nguyentrungthao/KicadLibrary/3D/Switch_Button/TactileSwitch_Button/SMD/YD-3414/31LzOt8mbsL._AC_SY1000_.jpg

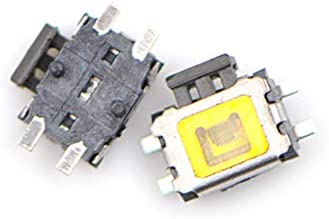
3D/Switch_Button/TactileSwitch_Button/SMD/YD-3414/31LzOt8mbsL._AC_SY1000_.jpg
