nguyentrungthao/KicadLibrary/README.md

# KicadLibrary
symbol and footprints for kicad
