nguyentrungthao/KicadLibrary/3D/Relay/PhanLoaiRelay.docx

HF32F 18.4x10.2x15.3

SRD 19.1x15.5x15.3

SRA 15.5X12.3X14.0

JQC 19.0X15.2X15.5

HK4100F 15.5X10.5X11.0 RELAY ĐÓNG CẮT NHANH

### RELAY SLA-12VDC-SL-A

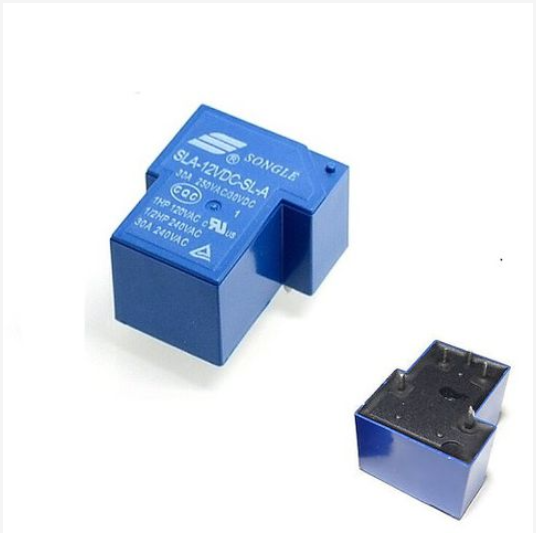
[picture p3: figure]
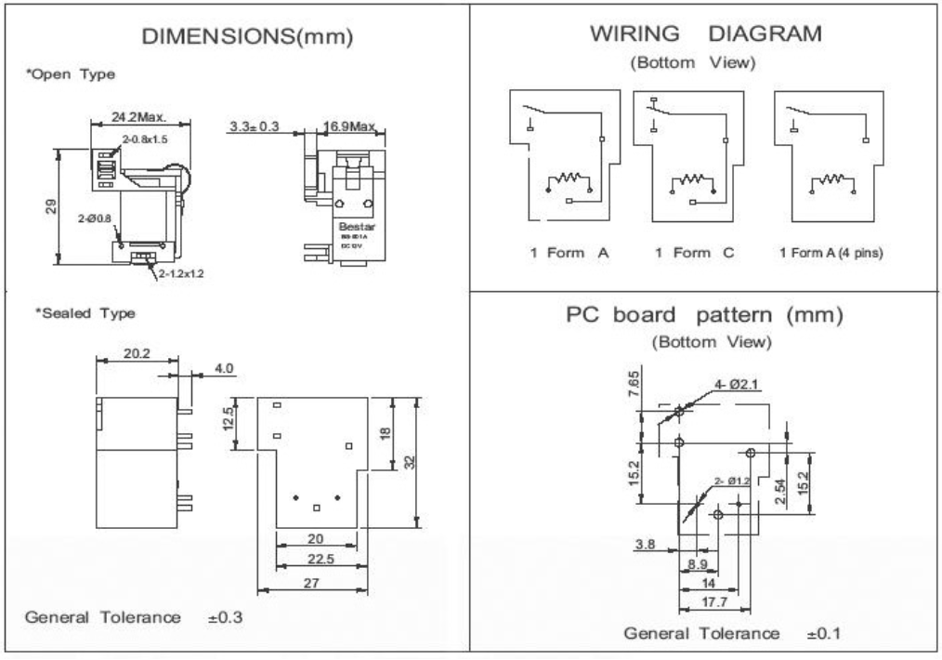
[picture p4: figure]

### Relay HK4100F-DC9V-SHG

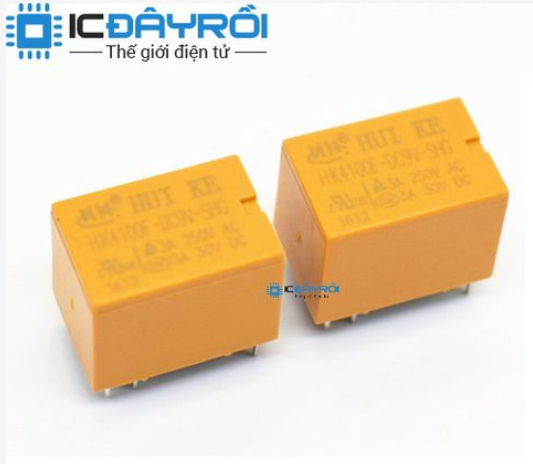
[picture p5: figure]
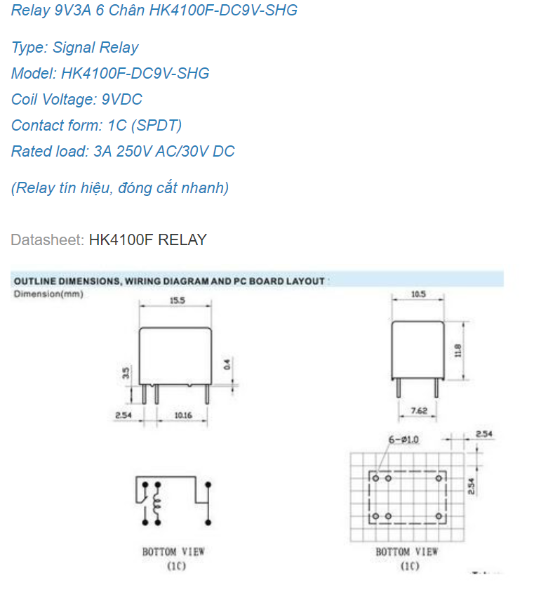
[picture p6: figure]

### Relay JQC-3FF-005-1ZS

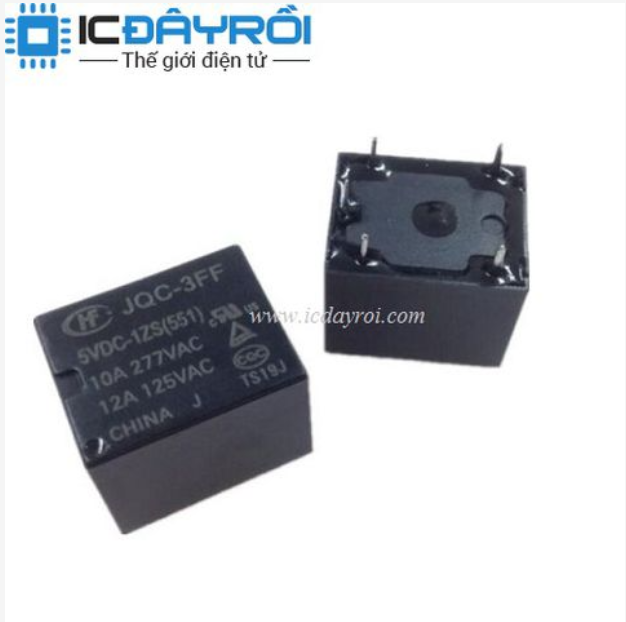
[picture p7: figure]
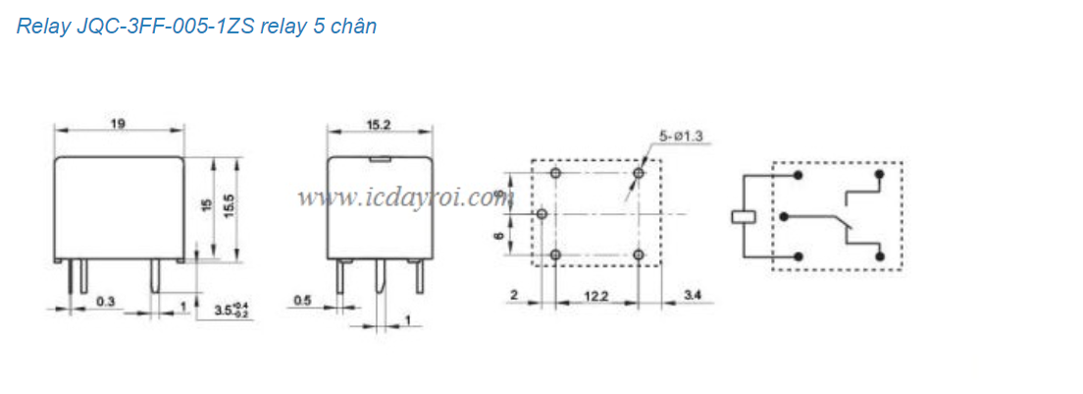
[picture p8: figure]

### Relay SRA-05VDC-CL

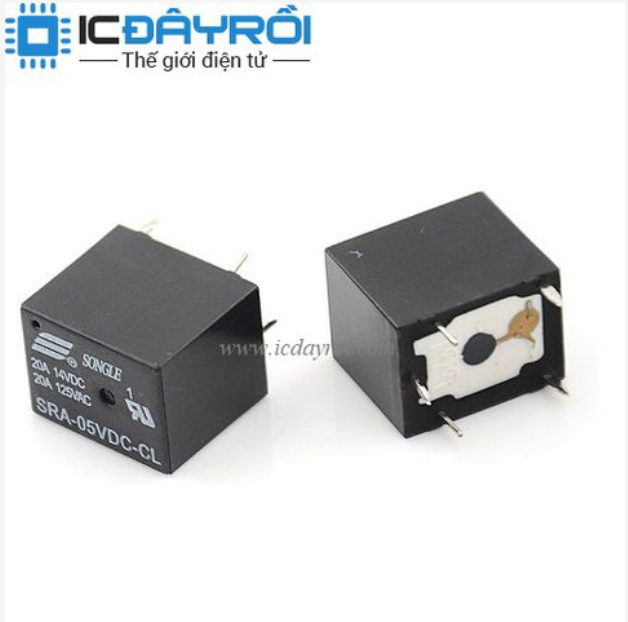
[picture p9: figure]
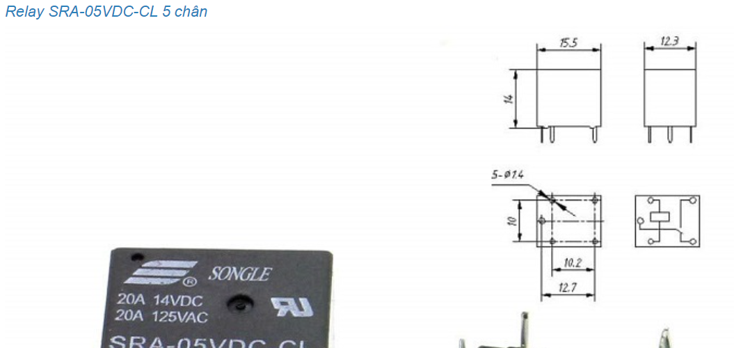
[picture p10: figure]

### Relay SRD-24VDC-SL-C

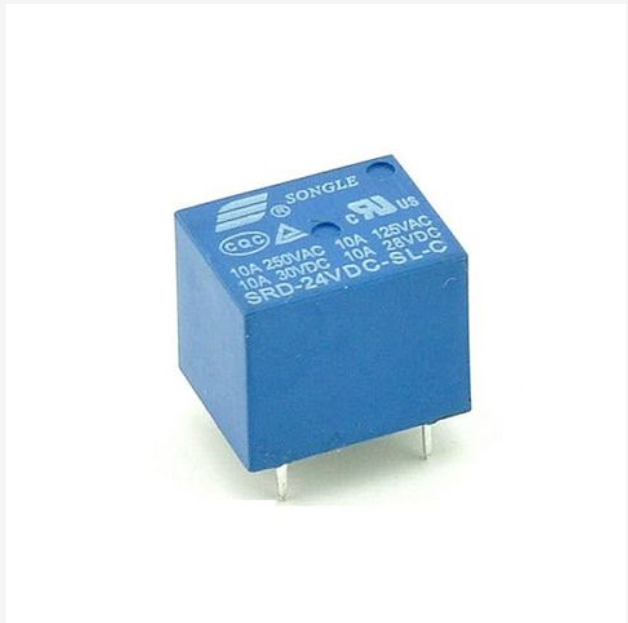
[picture p11: figure]
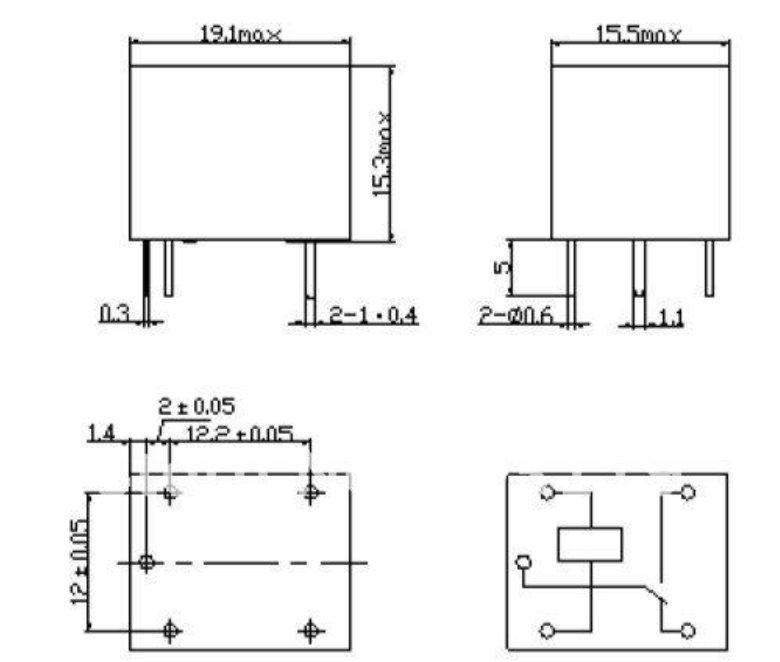
[picture p12: figure]

### Relay SLC-12VDC-SL-C

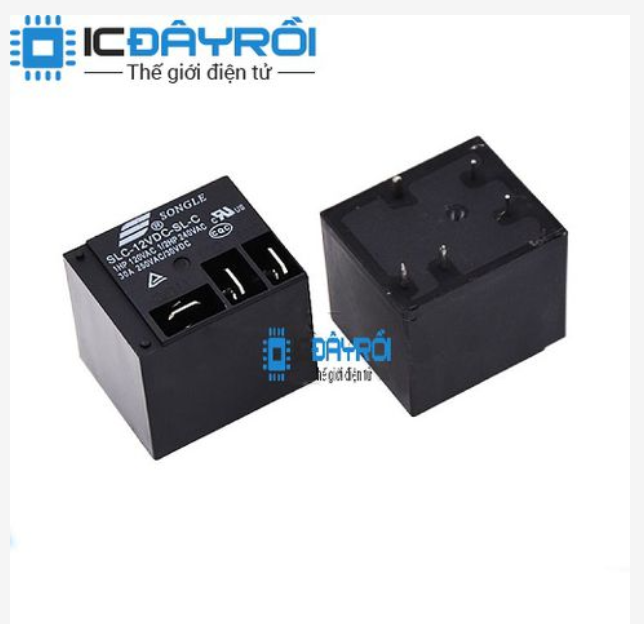
[picture p13: figure]
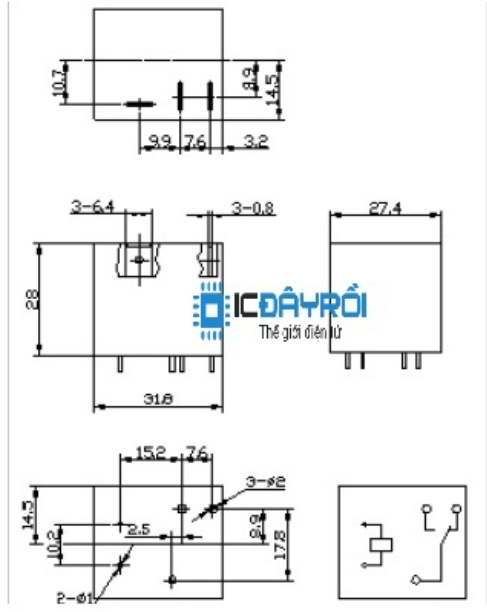
[picture p14: figure]

### Relay omron G3MB-202P-5VDC

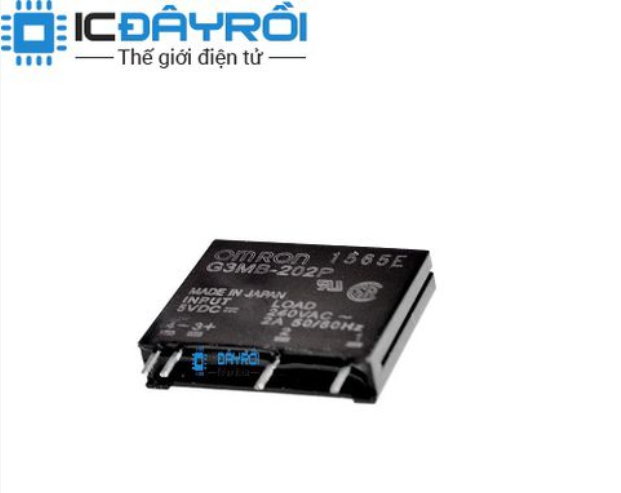
[picture p15: figure]
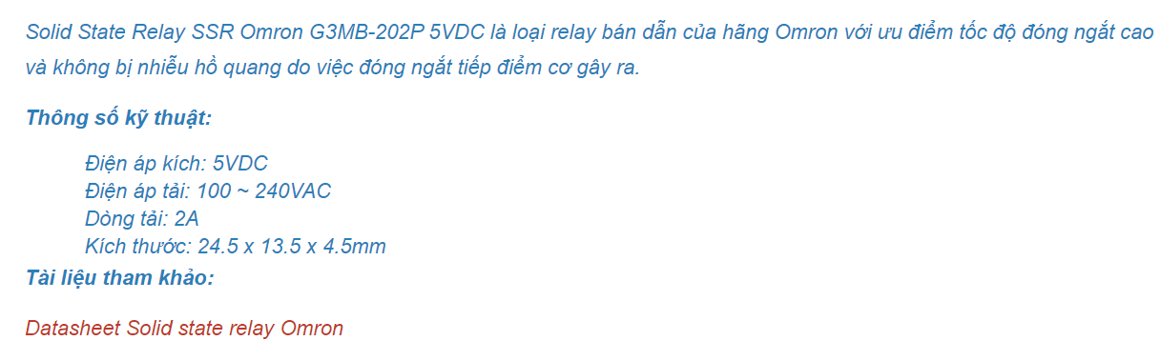
[picture p16: figure]

### Relay SMI-05VDC-SL-2C

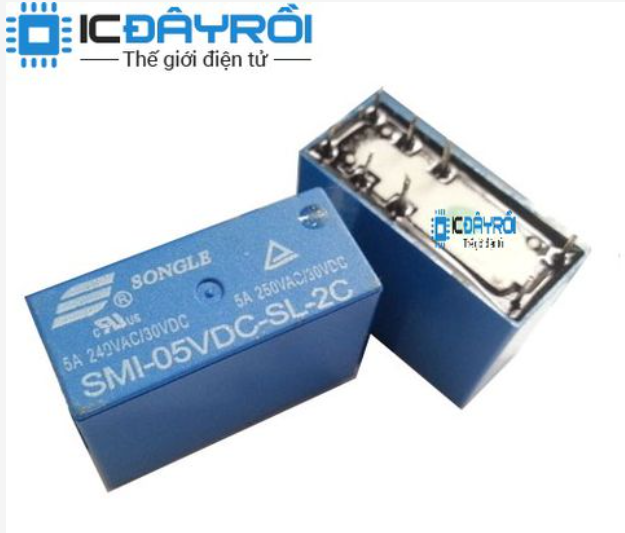
[picture p17: figure]
