nguyentrungthao/KicadLibrary/3D/Connector/RJ11/TJ6P6C/TJ6P6C (1).pdf

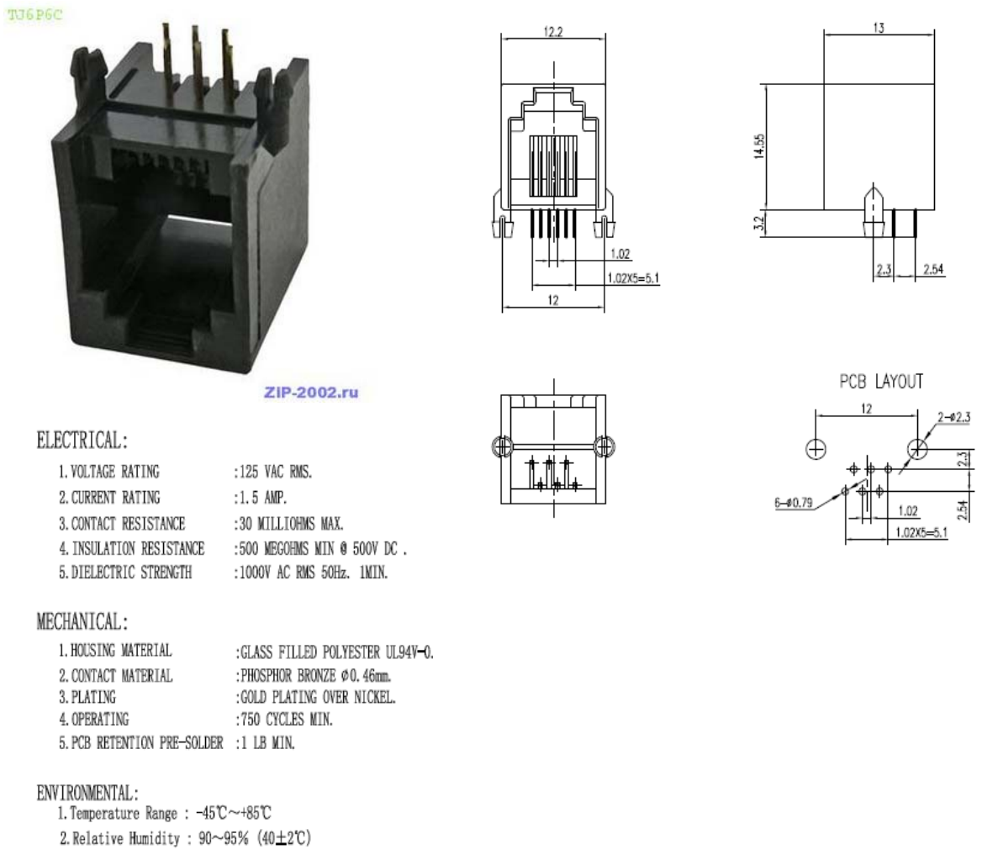
[picture p18: page 1]
