nguyentrungthao/KicadLibrary/3D/Capacitor/Cap_SMD/AluminumCap/Capacitor_SMD.jpeg

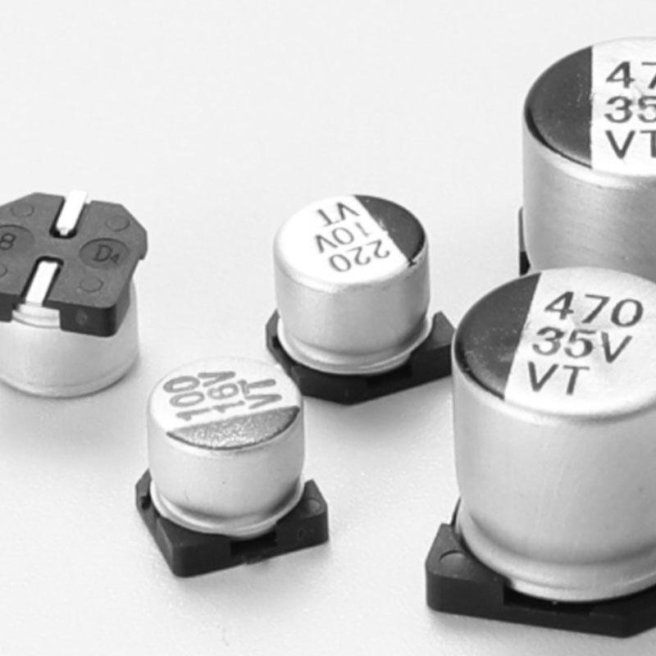
3D/Capacitor/Cap_SMD/AluminumCap/Capacitor_SMD.jpeg
