nguyentrungthao/KicadLibrary/3D/Comunication/TD301D485/TDx01D485.jpg

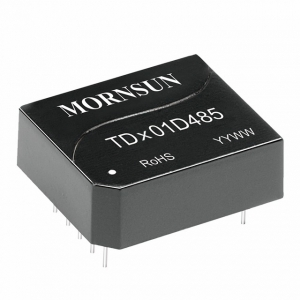
3D/Comunication/TD301D485/TDx01D485.jpg
