nguyentrungthao/KicadLibrary/3D/Connector/Banana/14116.jpg

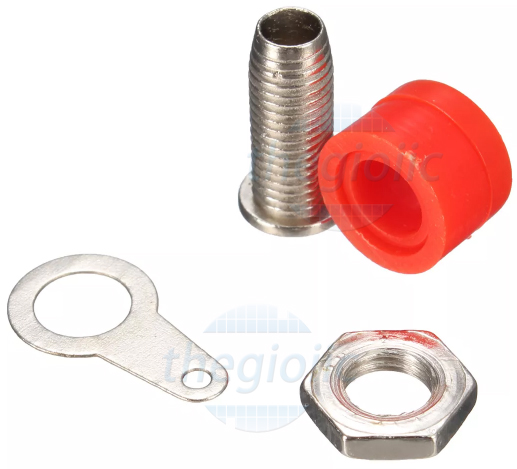
3D/Connector/Banana/14116.jpg
