nguyentrungthao/KicadLibrary/3D/Connector/DB/Db15 male PCB Connector.jpg

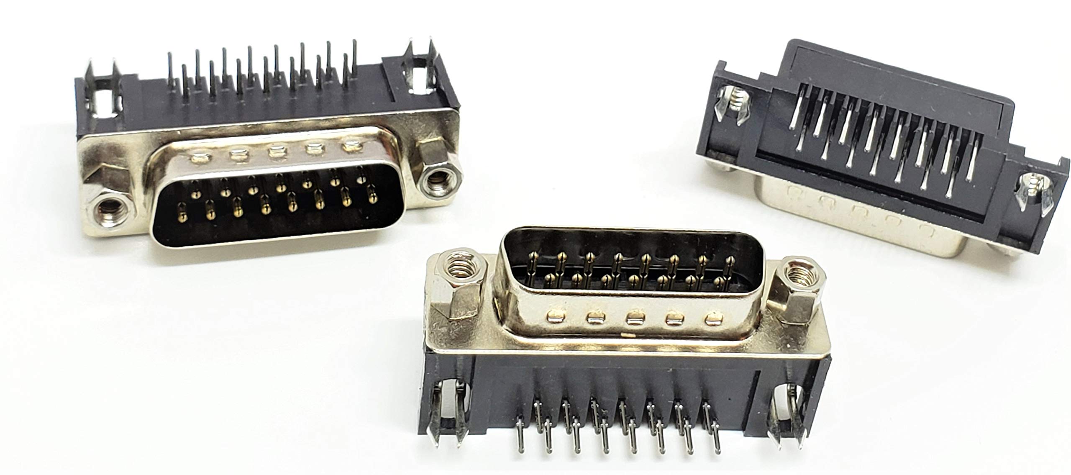
3D/Connector/DB/Db15 male PCB Connector.jpg
