nguyentrungthao/KicadLibrary/3D/Connector/IPEX_Antenna/i-pex-mhf-micro-coax-45-ghz-rf-receptacle-1.snapshot.1/I-PEX MHF_7 Recepticle iso rendering.JPG

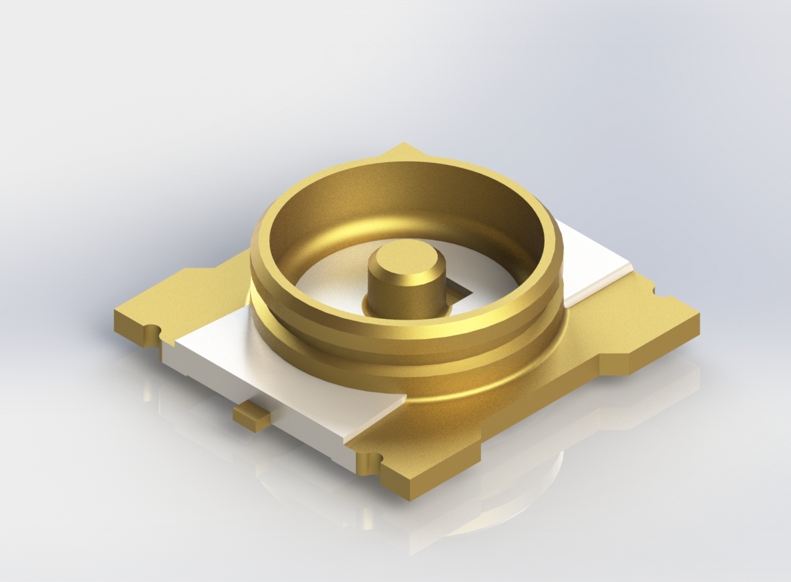
3D/Connector/IPEX_Antenna/i-pex-mhf-micro-coax-45-ghz-rf-receptacle-1.snapshot.1/I-PEX MHF_7 Recepticle iso rendering.JPG
