nguyentrungthao/KicadLibrary/3D/Connector/JST/DIP/JST-CH-Thru-Vertical-3.96mm/Capture.PNG

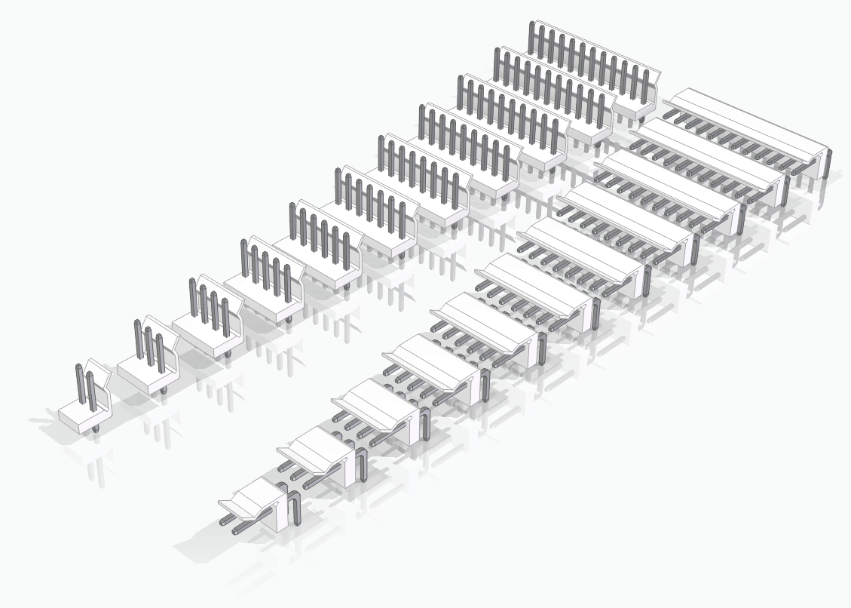
3D/Connector/JST/DIP/JST-CH-Thru-Vertical-3.96mm/Capture.PNG
