nguyentrungthao/KicadLibrary/3D/Connector/KF2510/molex3.jpg

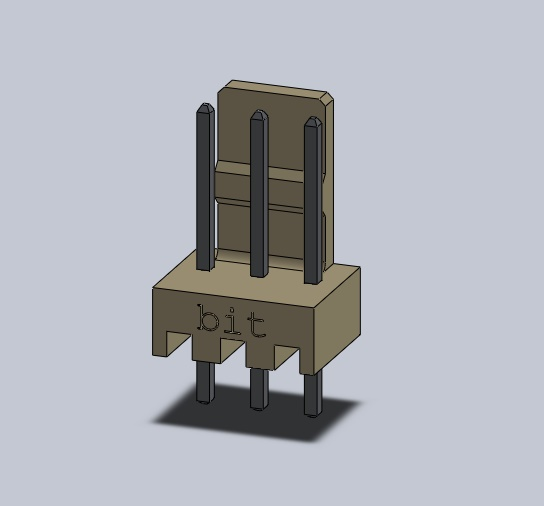
3D/Connector/KF2510/molex3.jpg
