nguyentrungthao/KicadLibrary/3D/Connector/RJ11/TJ6P4C/8fafbc54ad9b048f512ba79f.jpg

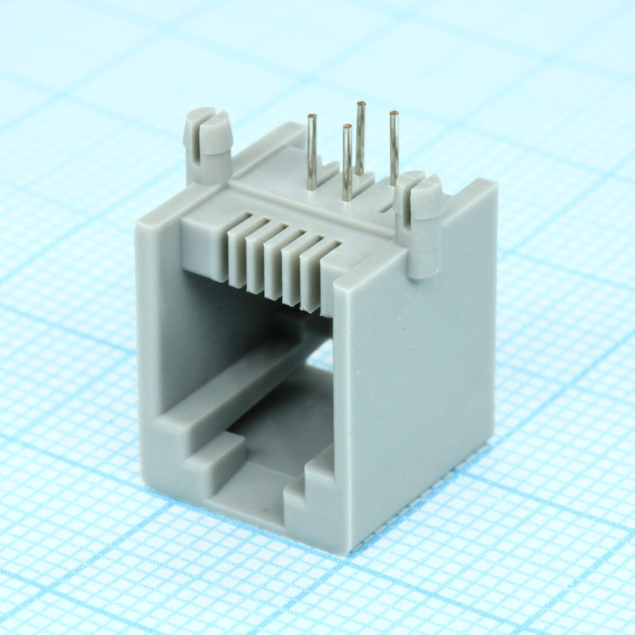
3D/Connector/RJ11/TJ6P4C/8fafbc54ad9b048f512ba79f.jpg
