nguyentrungthao/KicadLibrary/3D/Connector/RJ11/TJ6P6C/e70e3a5bf0055c61a7531b99.jpg

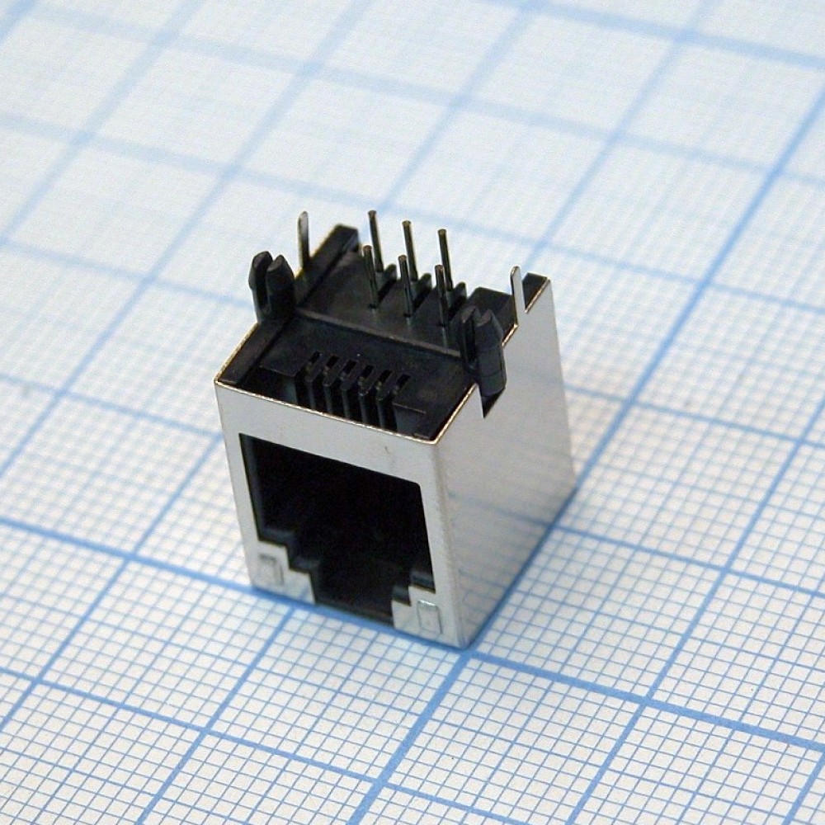
3D/Connector/RJ11/TJ6P6C/e70e3a5bf0055c61a7531b99.jpg
