nguyentrungthao/KicadLibrary/3D/Connector/SIMCardHolder/NanoSIM/Molex/78800001/1.JPG

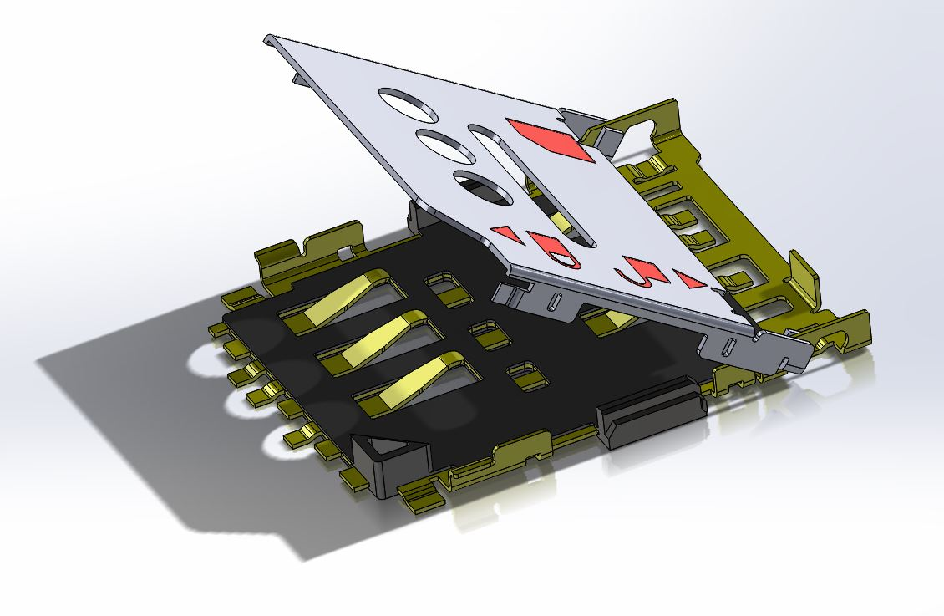
3D/Connector/SIMCardHolder/NanoSIM/Molex/78800001/1.JPG
