nguyentrungthao/KicadLibrary/3D/Connector/TerminalBlock/borne-5-08mm-duplo-nivel-1.snapshot.2/borne.png

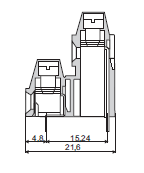
3D/Connector/TerminalBlock/borne-5-08mm-duplo-nivel-1.snapshot.2/borne.png
