nguyentrungthao/KicadLibrary/3D/Diode/Diodes-smd-packages.png

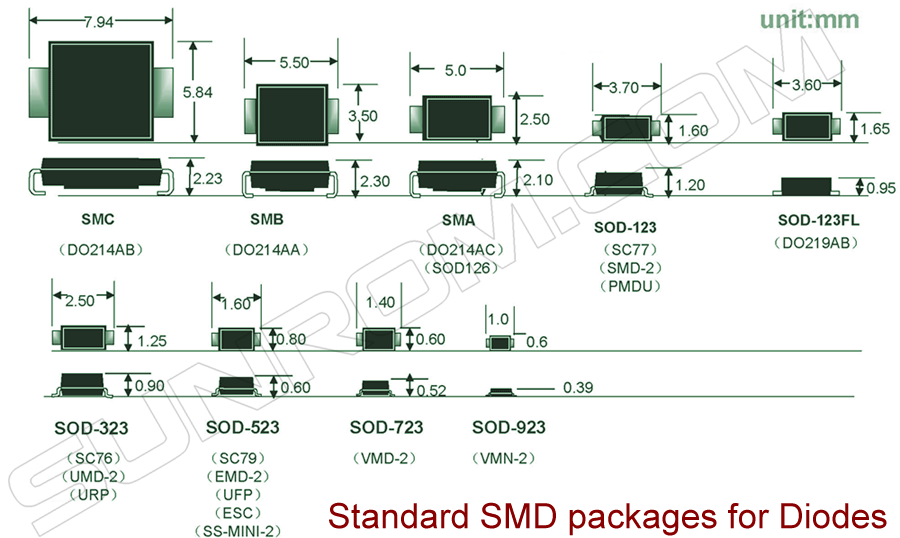
3D/Diode/Diodes-smd-packages.png
