nguyentrungthao/KicadLibrary/3D/Diode/LED/GP1UE26RK0VF.jpg

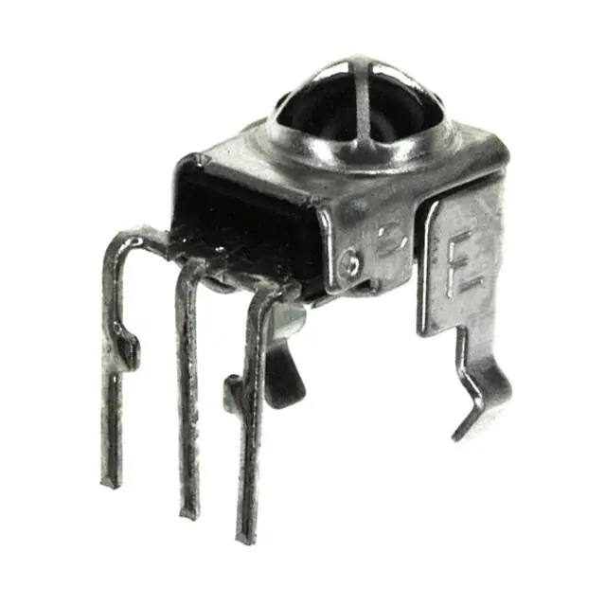
3D/Diode/LED/GP1UE26RK0VF.jpg
