nguyentrungthao/KicadLibrary/3D/Diode/LED/itr9909-ir-reflective-sensor-1.snapshot.2 (1)/ITR9909.png

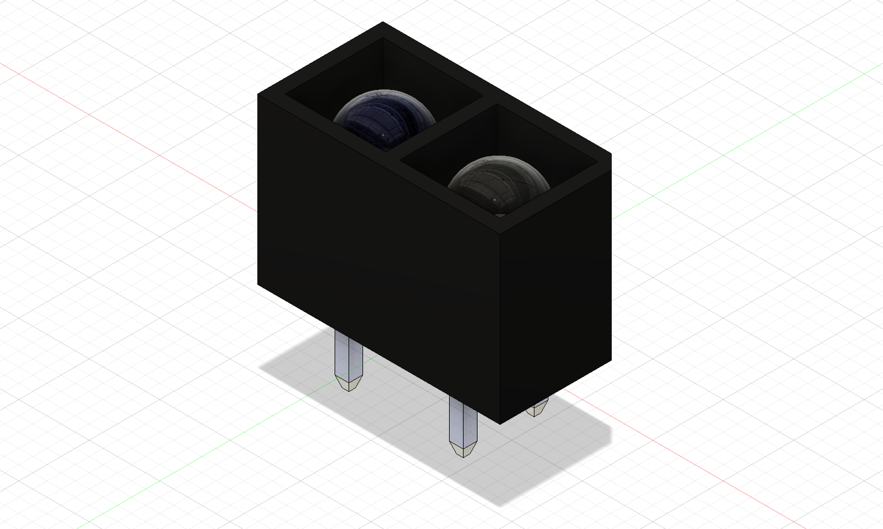
3D/Diode/LED/itr9909-ir-reflective-sensor-1.snapshot.2 (1)/ITR9909.png
