nguyentrungthao/KicadLibrary/3D/Diode/LED/ITR9909.jpg

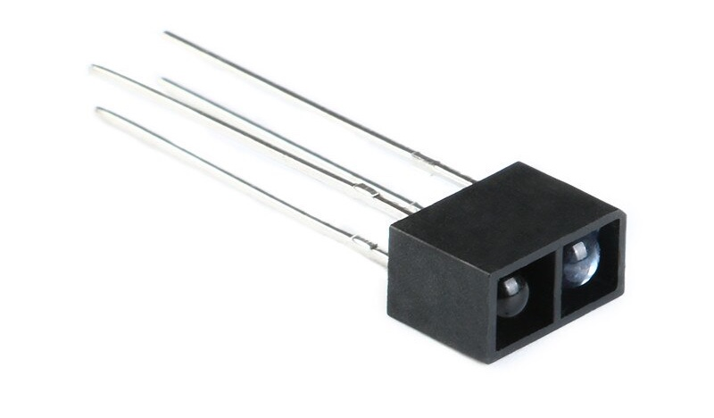
3D/Diode/LED/ITR9909.jpg
