nguyentrungthao/KicadLibrary/3D/Diode/LED/LED/Lite-On SMD LEDs.PNG

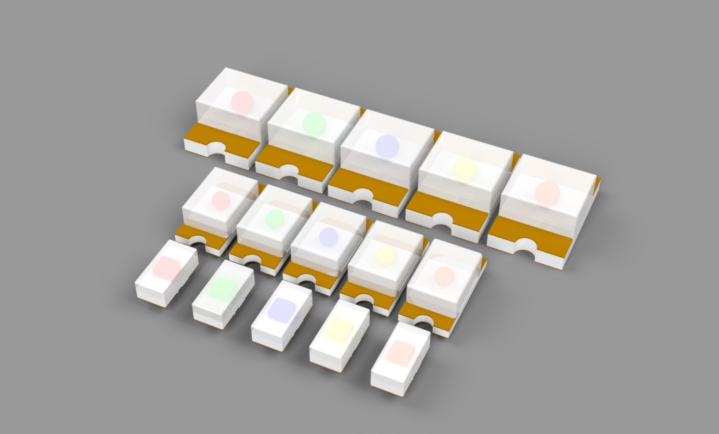
3D/Diode/LED/LED/Lite-On SMD LEDs.PNG
