nguyentrungthao/KicadLibrary/3D/Diode/LED/LED_Housing/LED 3mm red housing_3.jpg

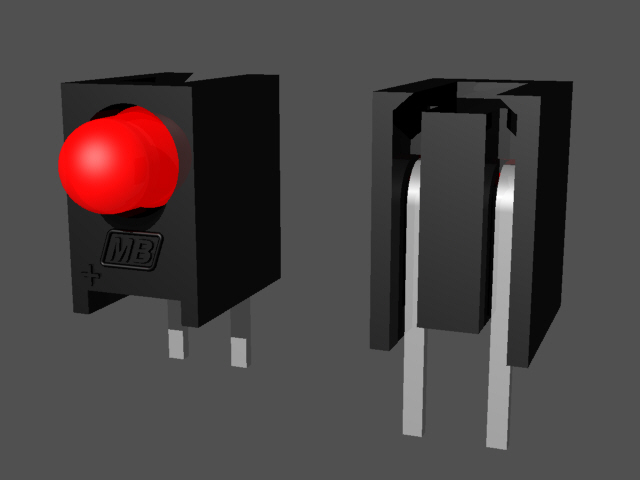
3D/Diode/LED/LED_Housing/LED 3mm red housing_3.jpg
