nguyentrungthao/KicadLibrary/3D/Diode/SMA/Package diode SMA.jpg

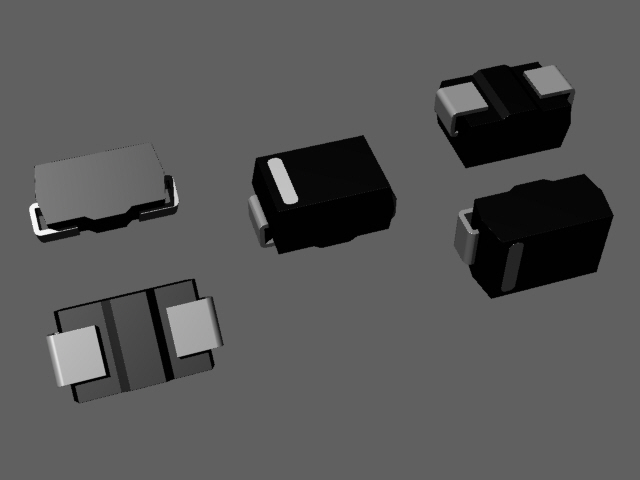
3D/Diode/SMA/Package diode SMA.jpg
