nguyentrungthao/KicadLibrary/3D/Diode/SOD323/SOD-600.jpg

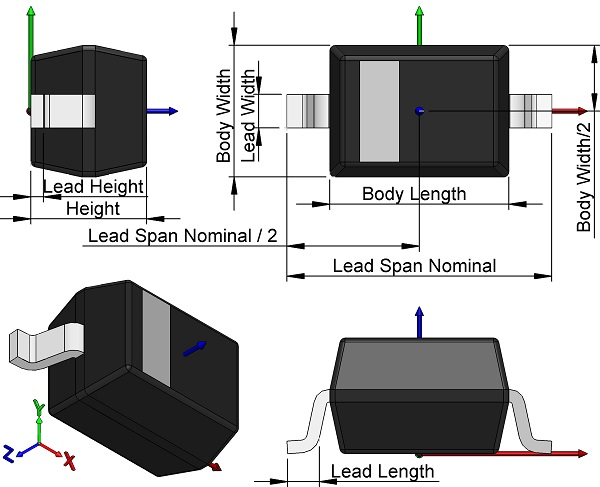
3D/Diode/SOD323/SOD-600.jpg
