nguyentrungthao/KicadLibrary/3D/Encoder/SMD/11mm-metal-shaft-rotary-encoders-smd-vertical-w-push-on-switch-1.snapshot.1/EC11-SMD-15F-green.png

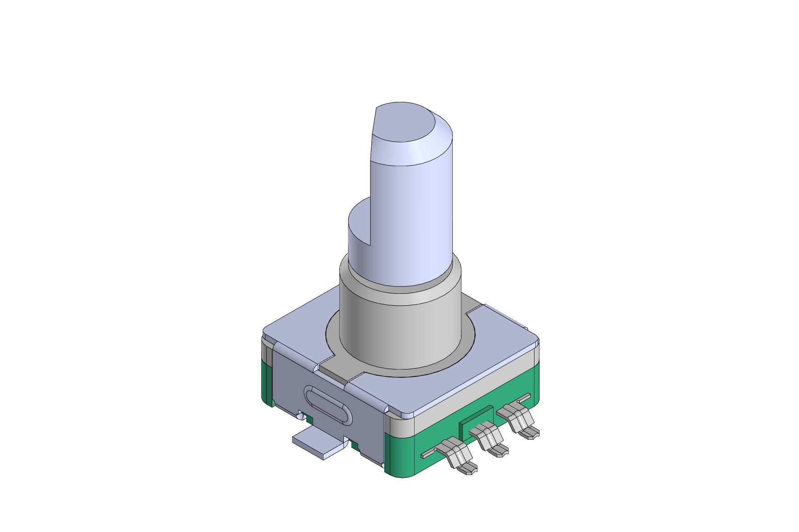
3D/Encoder/SMD/11mm-metal-shaft-rotary-encoders-smd-vertical-w-push-on-switch-1.snapshot.1/EC11-SMD-15F-green.png
