nguyentrungthao/KicadLibrary/3D/Filter/AC Filter Choke/filtr-ac-pins7x8.jpg

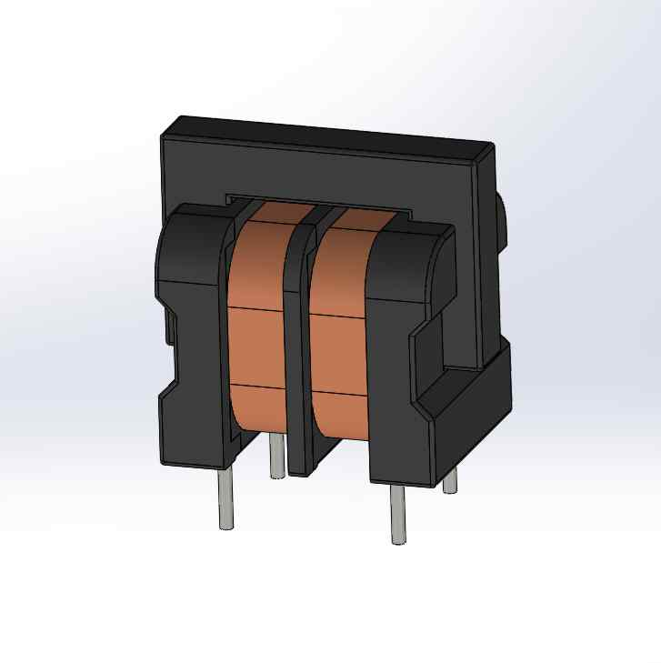
3D/Filter/AC Filter Choke/filtr-ac-pins7x8.jpg
