nguyentrungthao/KicadLibrary/3D/Fuses/FuseSMD/litteFuse/Littelfuse_0154.500DRT_2020-Jun-25_04-00-22AM-000_CustomizedView8331790309.png

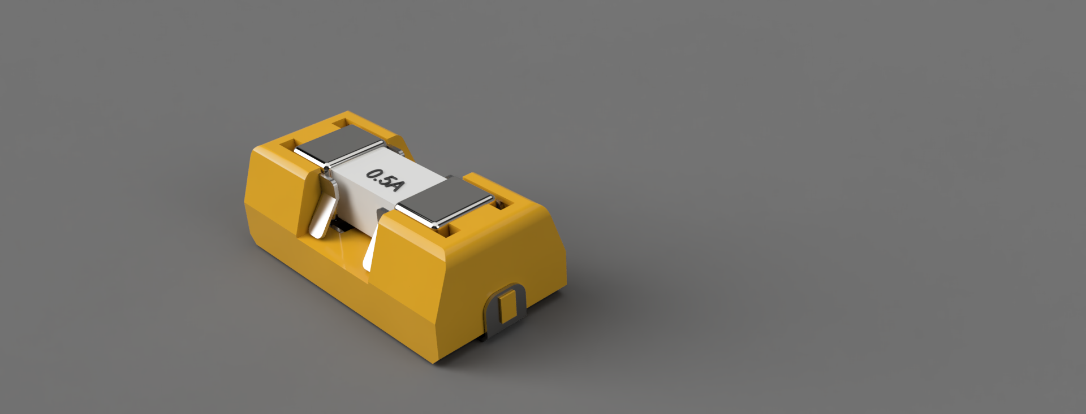
3D/Fuses/FuseSMD/litteFuse/Littelfuse_0154.500DRT_2020-Jun-25_04-00-22AM-000_CustomizedView8331790309.png
