nguyentrungthao/KicadLibrary/3D/Fuses/FuseSMD/litteFuse/Littelfuse_0154.500DRT_without_value_2020-Jun-29_07-49-51PM-000_CustomizedView18297485210.png

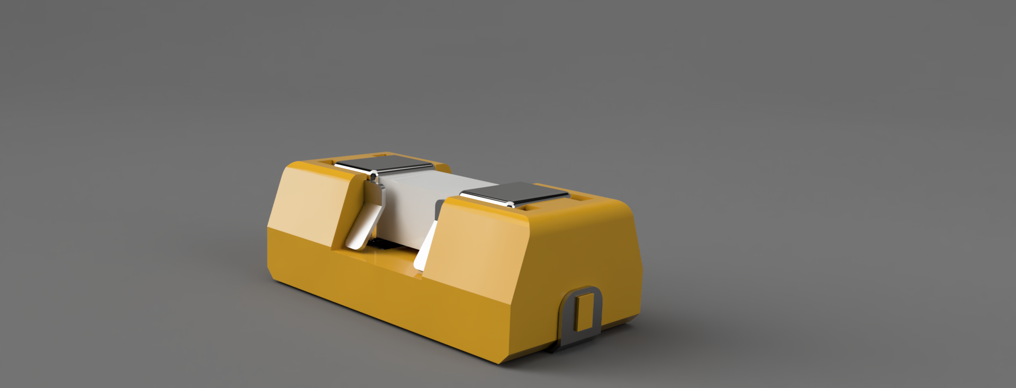
3D/Fuses/FuseSMD/litteFuse/Littelfuse_0154.500DRT_without_value_2020-Jun-29_07-49-51PM-000_CustomizedView18297485210.png
