nguyentrungthao/KicadLibrary/3D/Fuses/FuseSMD/Resettable Fuse/1206/Bourns SF Fuse/Bourns SF-1206SA-R series SMD Fuses.jpg

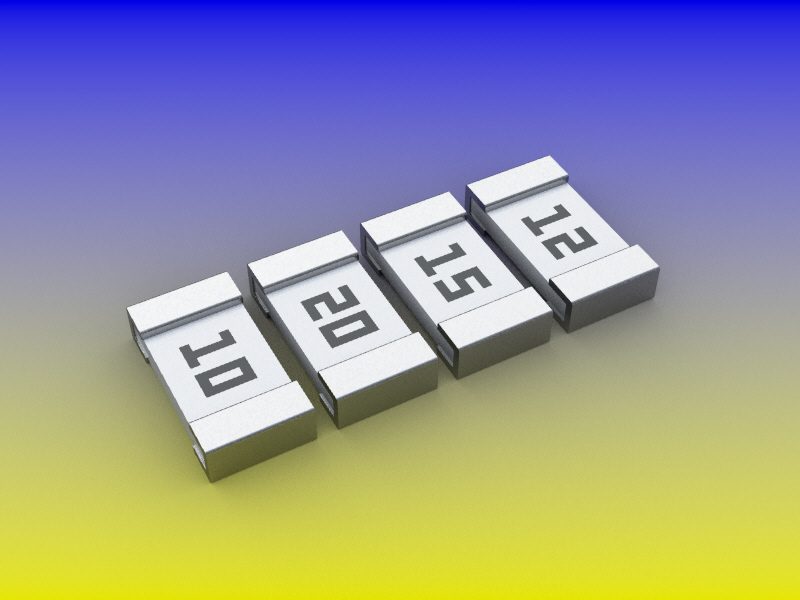
3D/Fuses/FuseSMD/Resettable Fuse/1206/Bourns SF Fuse/Bourns SF-1206SA-R series SMD Fuses.jpg
