nguyentrungthao/KicadLibrary/3D/Fuses/FuseSMD/Resettable Fuse/fuse_dimensions.PNG

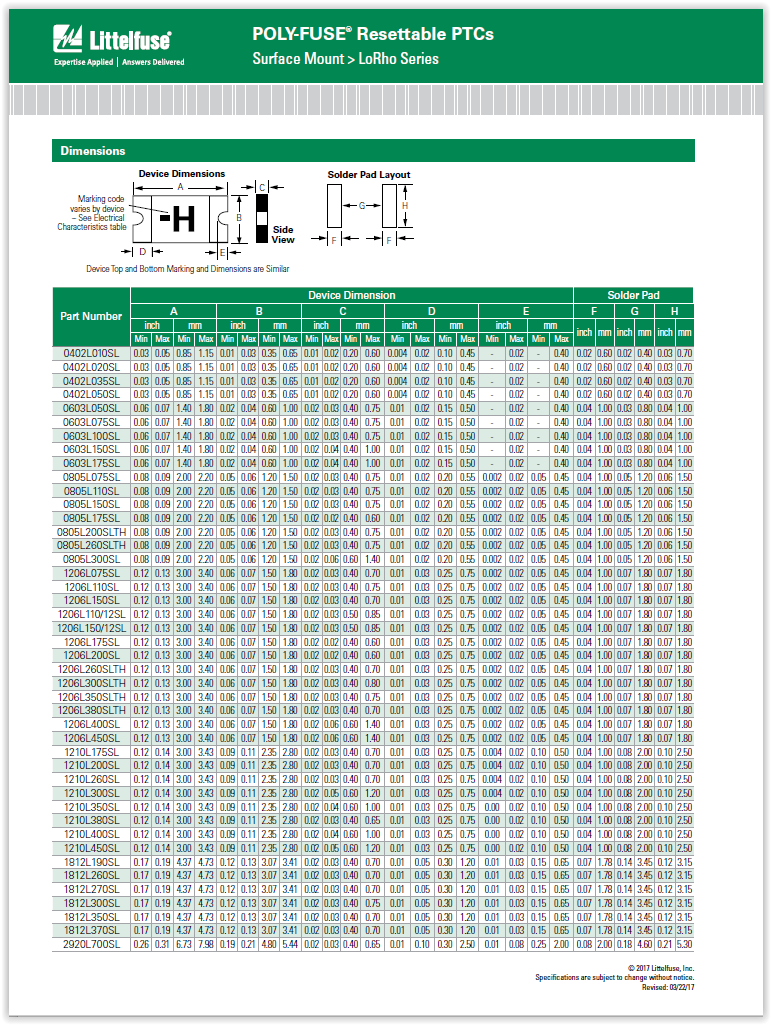
3D/Fuses/FuseSMD/Resettable Fuse/fuse_dimensions.PNG
