nguyentrungthao/KicadLibrary/3D/Isolation/OPTO/pc817/tải xuống.png

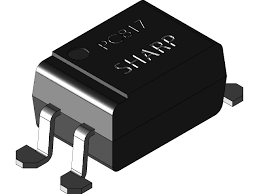
3D/Isolation/OPTO/pc817/tải xuống.png
