nguyentrungthao/KicadLibrary/3D/MCU_SoC_Package/QFN/HVQFN-40_5x5.PNG

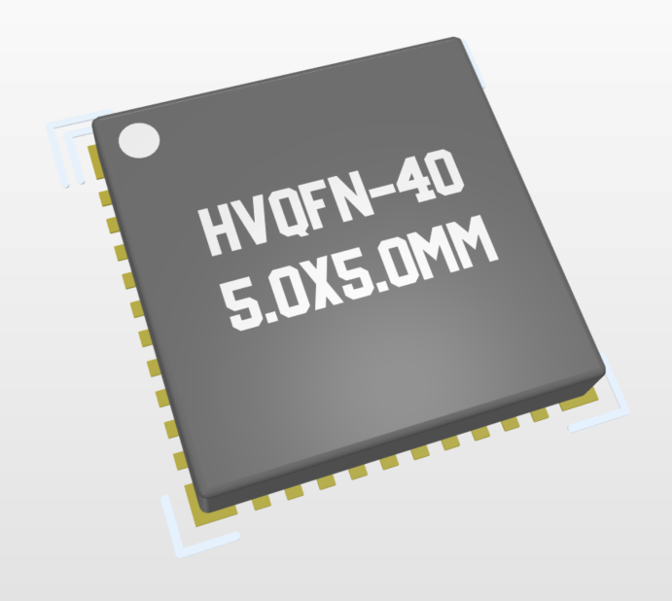
3D/MCU_SoC_Package/QFN/HVQFN-40_5x5.PNG
