nguyentrungthao/KicadLibrary/3D/MCU_SoC_Package/QFN/UFQFPN-48_7x7.PNG

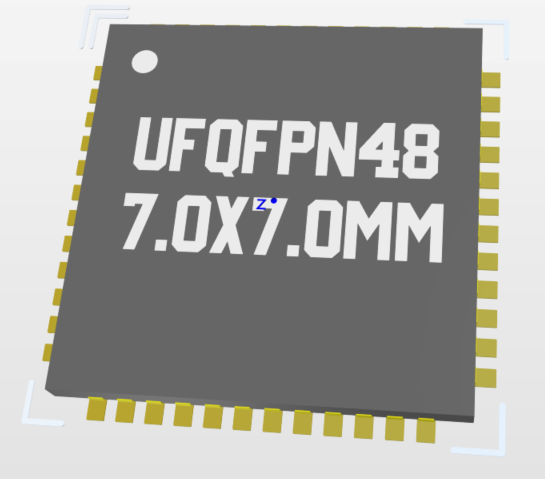
3D/MCU_SoC_Package/QFN/UFQFPN-48_7x7.PNG
