nguyentrungthao/KicadLibrary/3D/MCU_SoC_Package/SOIC_package/SOIC8/large.png

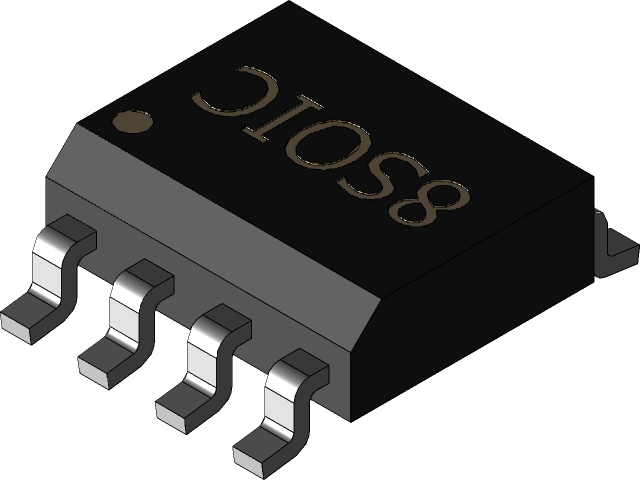
3D/MCU_SoC_Package/SOIC_package/SOIC8/large.png
