nguyentrungthao/KicadLibrary/3D/MCU_SoC_Package/SOT223/large.png

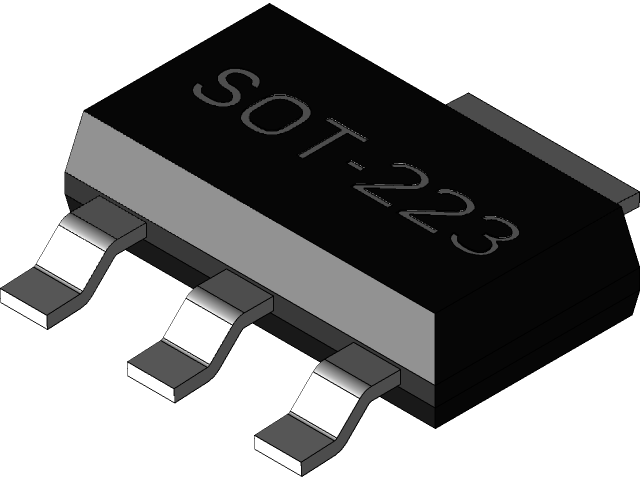
3D/MCU_SoC_Package/SOT223/large.png
