nguyentrungthao/KicadLibrary/3D/MCU_SoC_Package/SOT363/1.PNG

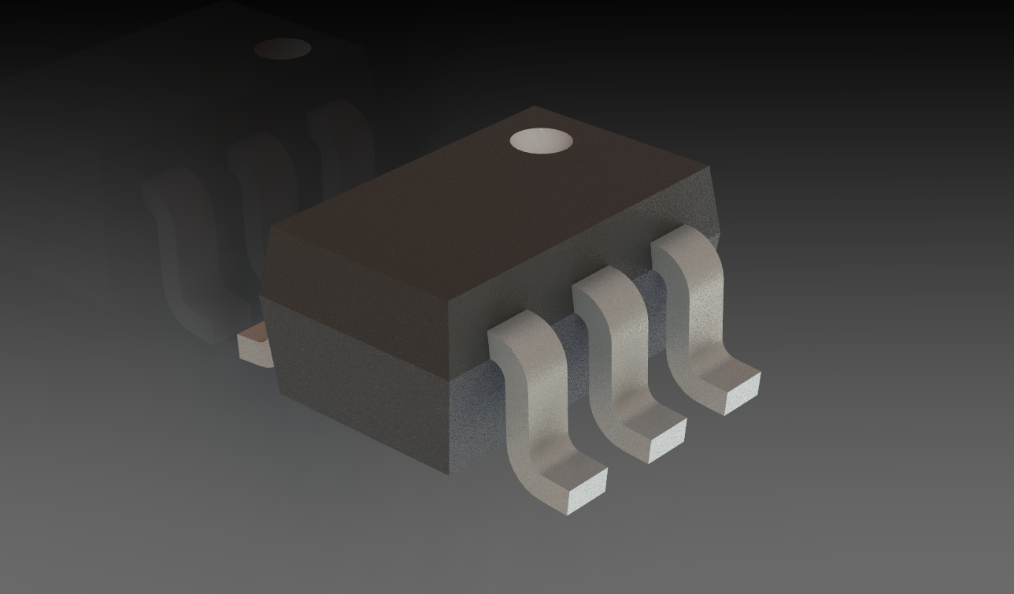
3D/MCU_SoC_Package/SOT363/1.PNG
