nguyentrungthao/KicadLibrary/3D/MCU_SoC_Package/TO-92/TO-92.jpg

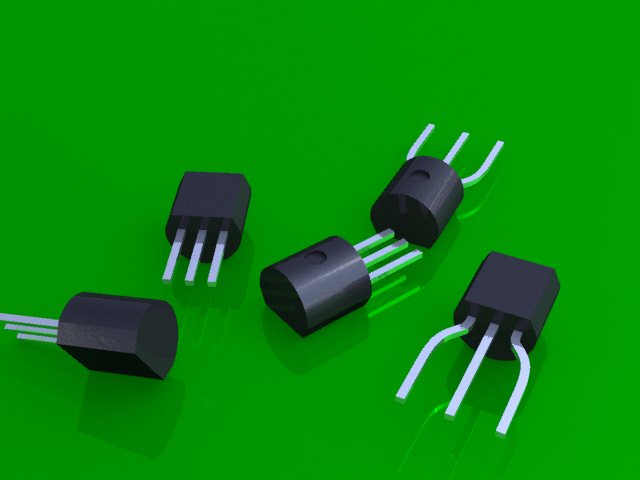
3D/MCU_SoC_Package/TO-92/TO-92.jpg
