nguyentrungthao/KicadLibrary/3D/Power/DCDC_converter/Isolate/1W/10691.jpg

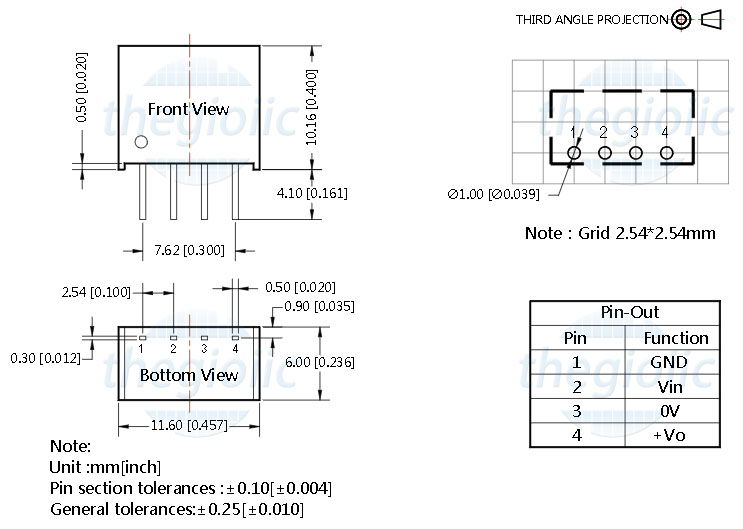
3D/Power/DCDC_converter/Isolate/1W/10691.jpg
