nguyentrungthao/KicadLibrary/3D/Power/DCDC_converter/Isolate/1W/34749.jpg

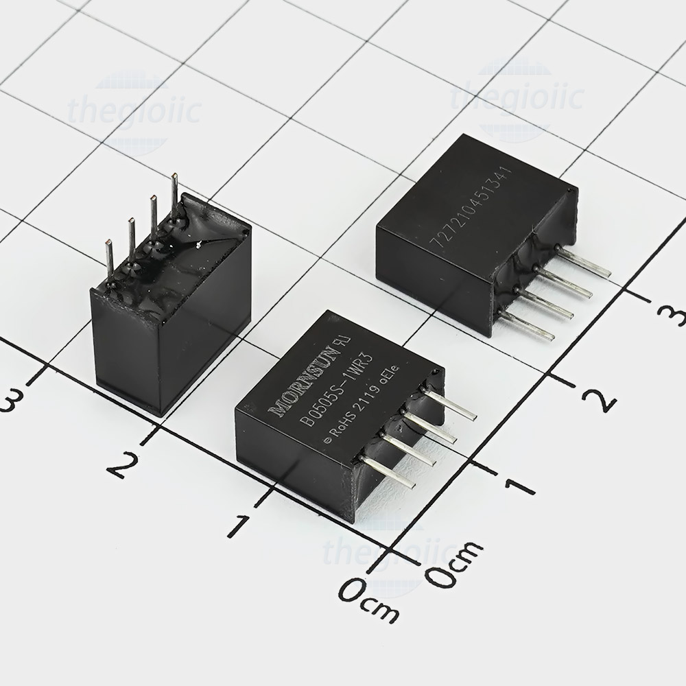
3D/Power/DCDC_converter/Isolate/1W/34749.jpg
