nguyentrungthao/KicadLibrary/3D/Power/DCDC_converter/Isolate/2W/B1205S-2W/B1205S-2W.PNG

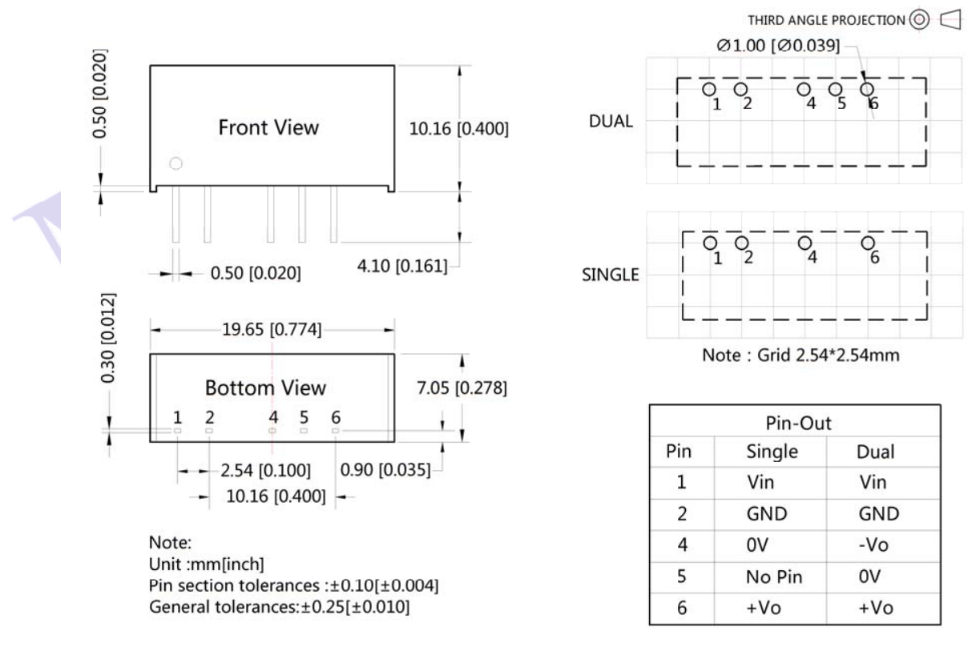
3D/Power/DCDC_converter/Isolate/2W/B1205S-2W/B1205S-2W.PNG
