nguyentrungthao/KicadLibrary/3D/Switch_Button/Button_SMD/21894.jpg

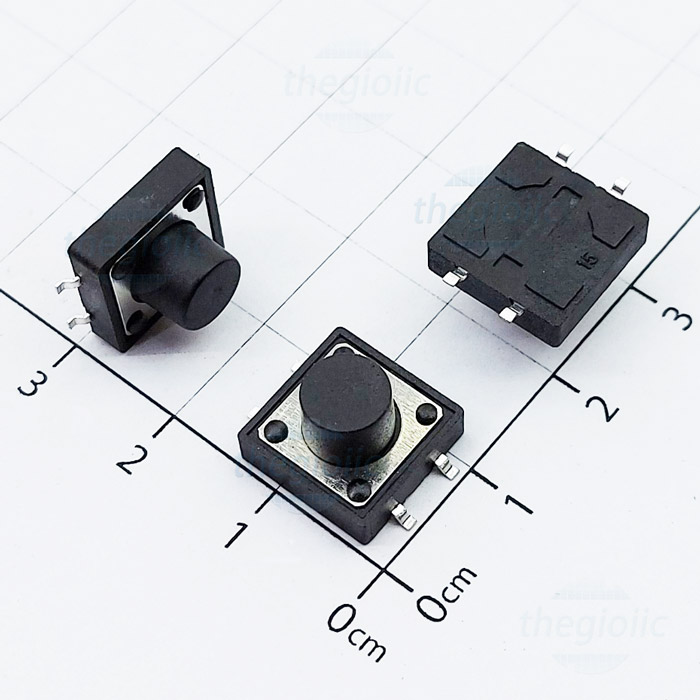
3D/Switch_Button/Button_SMD/21894.jpg
