nguyentrungthao/KicadLibrary/3D/Switch_Button/Switch/DIP/MSS22D18.jpg

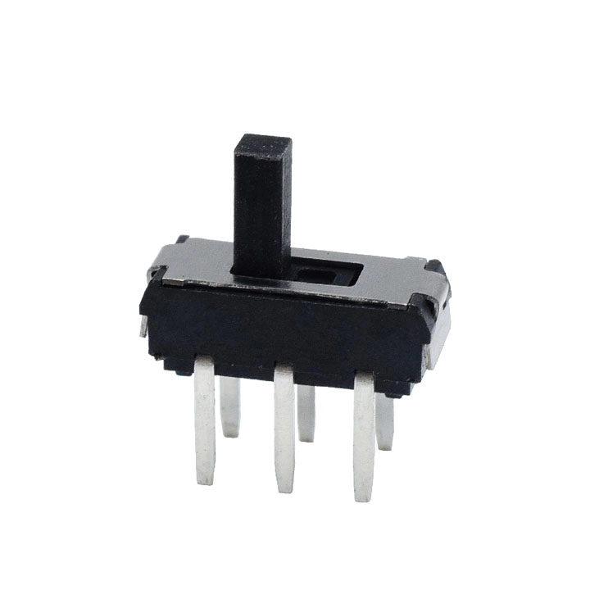
3D/Switch_Button/Switch/DIP/MSS22D18.jpg
