nguyentrungthao/KicadLibrary/3D/Switch_Button/Switch/DIP/SK22D07.jpg

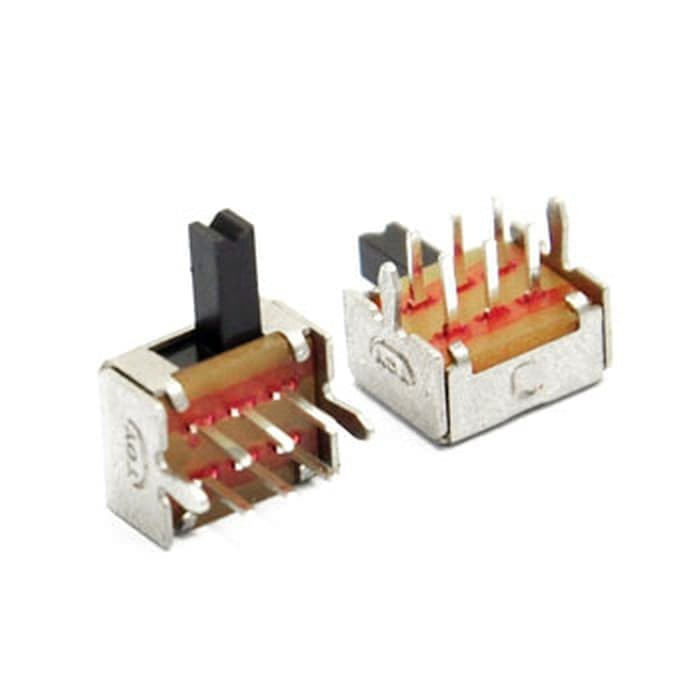
3D/Switch_Button/Switch/DIP/SK22D07.jpg
