nguyentrungthao/KicadLibrary/3D/Switch_Button/Switch/DIP/SS12D00.jpg

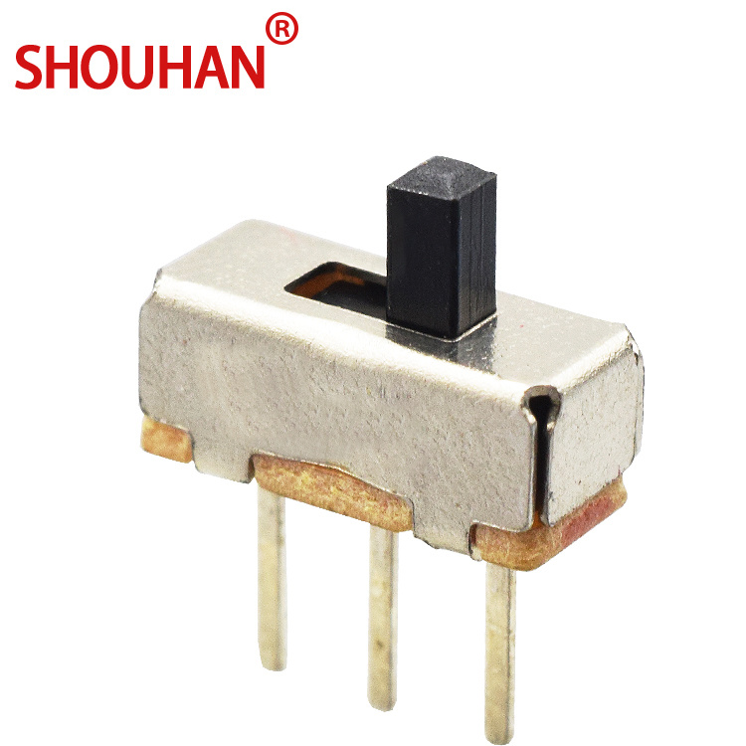
3D/Switch_Button/Switch/DIP/SS12D00.jpg
