nguyentrungthao/KicadLibrary/3D/Switch_Button/Switch/DIP/SS12F23.jpg

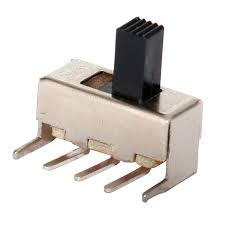
3D/Switch_Button/Switch/DIP/SS12F23.jpg
