nguyentrungthao/KicadLibrary/3D/Switch_Button/Switch/DIP/SS23D07.jpg

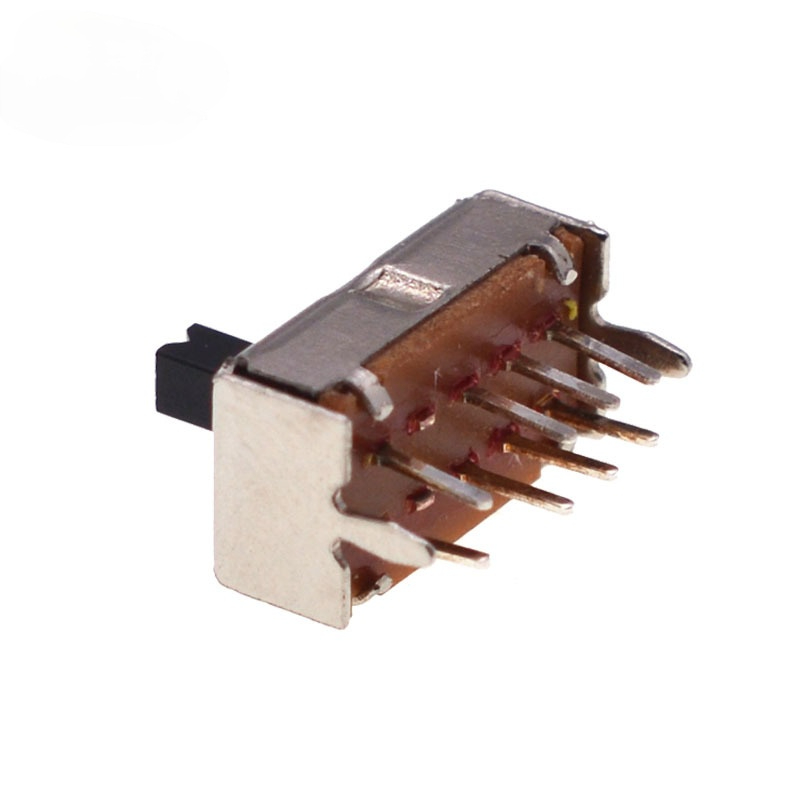
3D/Switch_Button/Switch/DIP/SS23D07.jpg
