nguyentrungthao/KicadLibrary/3D/Switch_Button/Switch/SMD/MSK1103.jpg

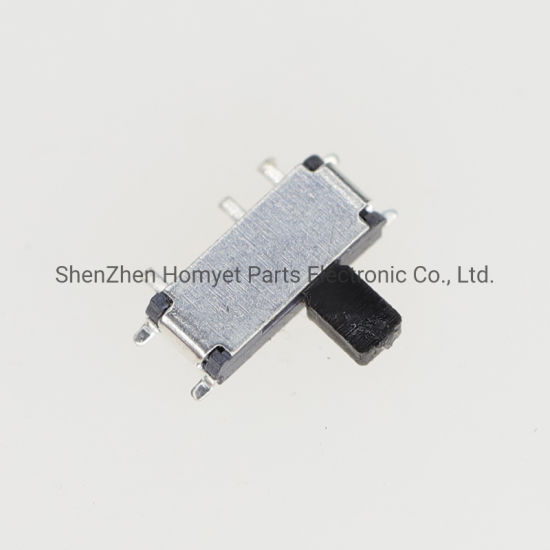
3D/Switch_Button/Switch/SMD/MSK1103.jpg
