nguyentrungthao/KicadLibrary/3D/Connector/Header/Header 1.27mm/Male 1.27mm 2Row SMD/1_27mm_single_pin_assembled.STEP

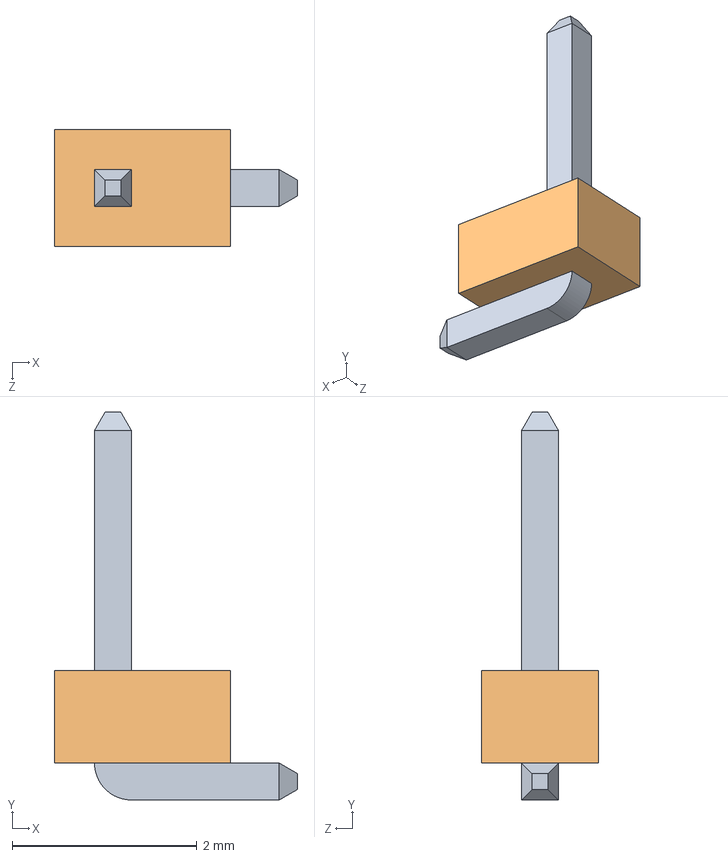
[picture p87: CAD file, 2024-09-17]
3D/Connector/Header/Header 1.27mm/Male 1.27mm 2Row SMD/1_27mm_single_pin_assembled.STEP
2.64 x 4.20 x 1.27 mm
1_27mm_pin_right_angle
1_27mm_plastic_for_pin
