nguyentrungthao/KicadLibrary/3D/LCD/LCD1602/LCD WITH IIC/LCD.SLDASM

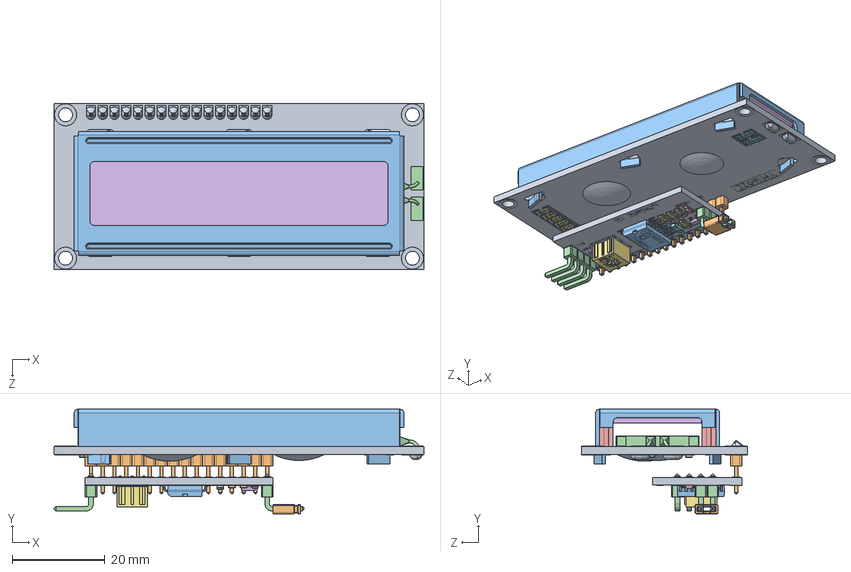
[picture p89: CAD file, 2024-09-17]
3D/LCD/LCD1602/LCD WITH IIC/LCD.SLDASM
80.0 x 22.6 x 36.0 mm
pcbboard
16pin_header__
lcd window
backlight
conductor x 2
liquid crystal grabcad i2s
smt_resistor222 x 10
smt_resistor101 x 2
i2C board
jumper__
pcf8574p
bent header x 6
led
ssot3
trimpot 3662
smt_cap
