nguyentrungthao/KicadLibrary/3D/Connector/Header_1-27mm_2Row_SMD/1_27mm_Header/1_27mm_2x10pin.SLDASM

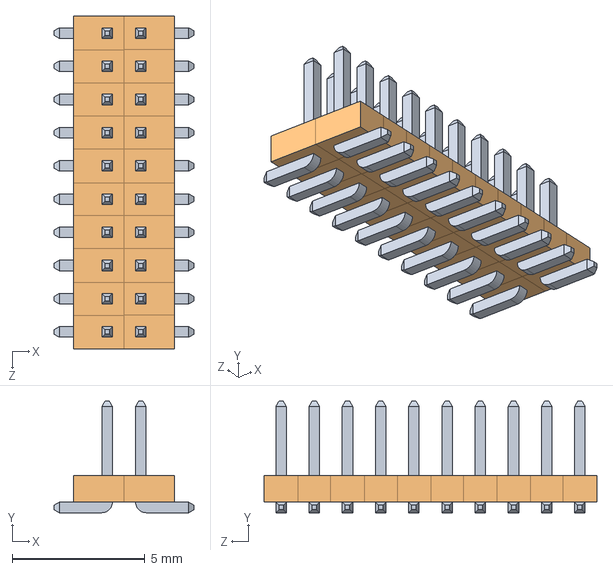
[picture p92: CAD file, 2024-09-17]
3D/Connector/Header_1-27mm_2Row_SMD/1_27mm_Header/1_27mm_2x10pin.SLDASM
5.27 x 4.20 x 12.5 mm
1_27mm_pin_right_angle x 20
1_27mm_plastic_for_pin x 20
