nguyentrungthao/KicadLibrary/3D/BatteryHolder/14500_BatteryHolder/ICR 14500.stp

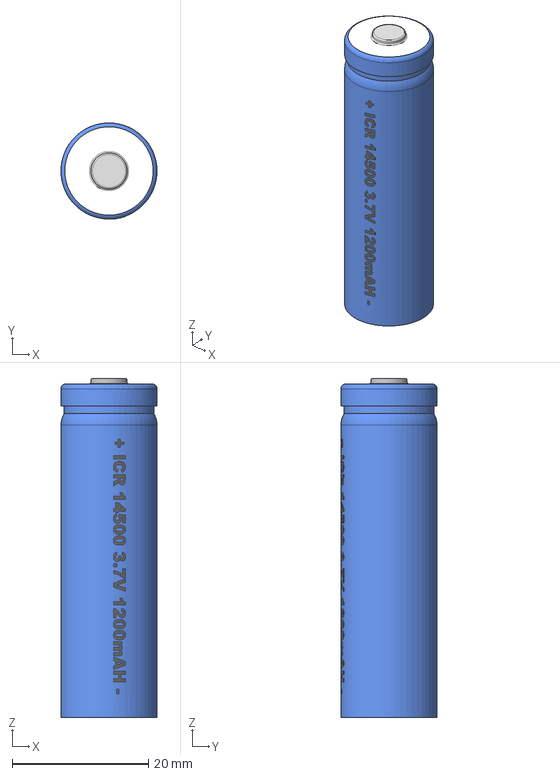
[picture p96: CAD file, 2024-09-17]
3D/BatteryHolder/14500_BatteryHolder/ICR 14500.stp
14.1 x 14.1 x 49.7 mm
