nguyentrungthao/KicadLibrary/3D/BatteryHolder/CR1220_BatteryHolder/CR1220.STEP

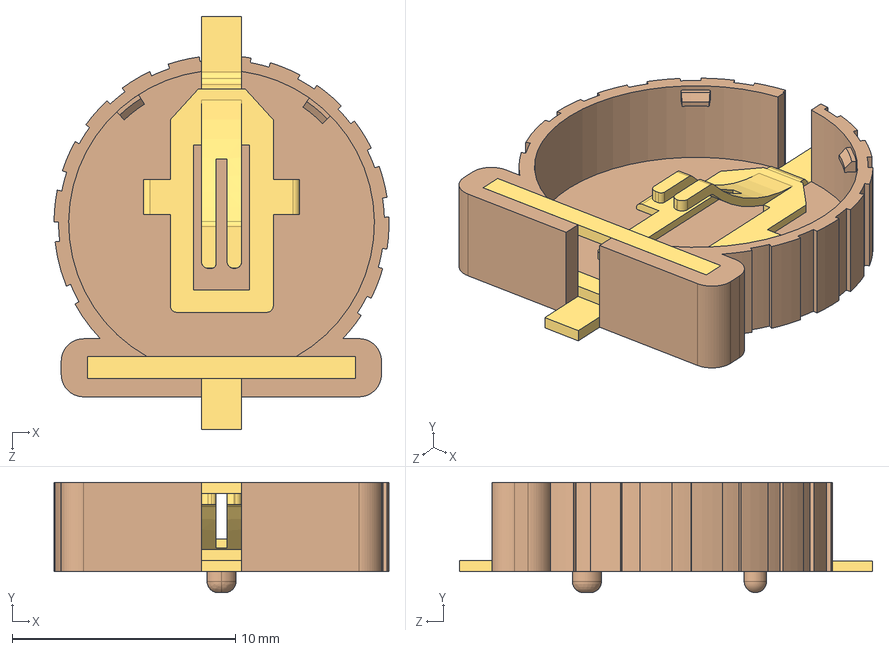
[picture p97: CAD file, 2024-09-17]
3D/BatteryHolder/CR1220_BatteryHolder/CR1220.STEP
15.0 x 4.94 x 18.5 mm
ALSRobot-CR1220_User Library-cr1220_CR1220
ALSRobot-CR1220_User Library-cr1220_PRT0001 x 2
ALSRobot-CR1220_User Library-cr1220_PRT0002
ALSRobot-CR1220_User Library-cr1220_PRT0003
ALSRobot-CR1220_User Library-cr1220_PRT0004
