nguyentrungthao/KicadLibrary/3D/BatteryHolder/CR2032_BatteryHolder/CR2032 holder.step

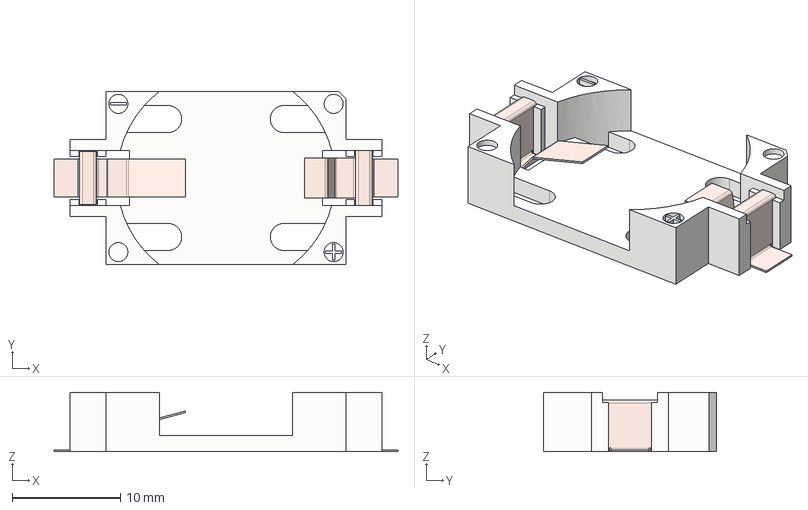
[picture p98: CAD file, 2024-09-17]
3D/BatteryHolder/CR2032_BatteryHolder/CR2032 holder.step
31.8 x 16.0 x 5.50 mm
base
connector_plus
connector_minus
