nguyentrungthao/KicadLibrary/3D/BatteryHolder/SINGLE AA BATHOLDER/SINGLE AA BATHOLDER.SLDPRT

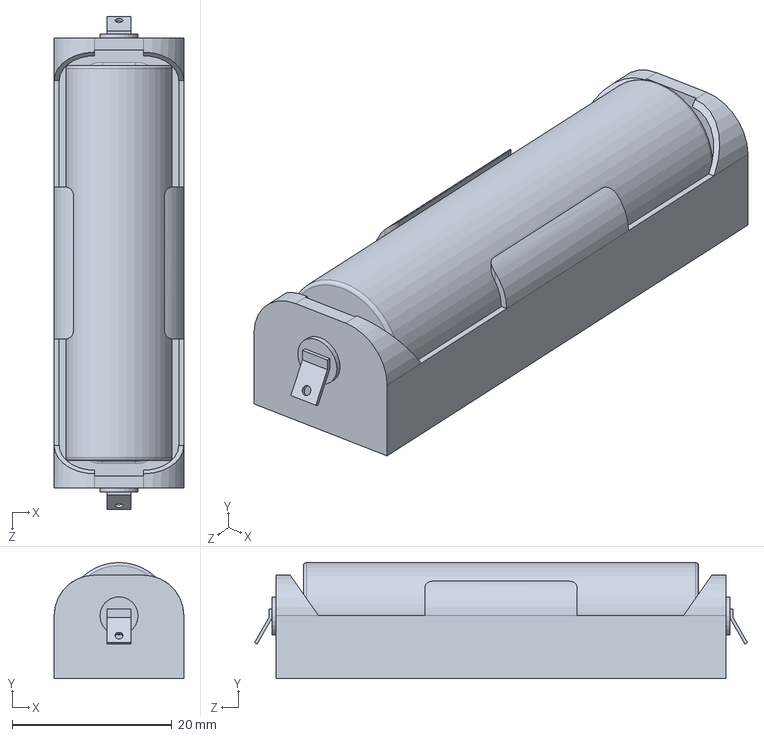
[picture p99: CAD file, 2024-09-17]
3D/BatteryHolder/SINGLE AA BATHOLDER/SINGLE AA BATHOLDER.SLDPRT
16.3 x 14.5 x 61.8 mm
