nguyentrungthao/KicadLibrary/3D/Buzzer/Buzzer 9 mm.STEP

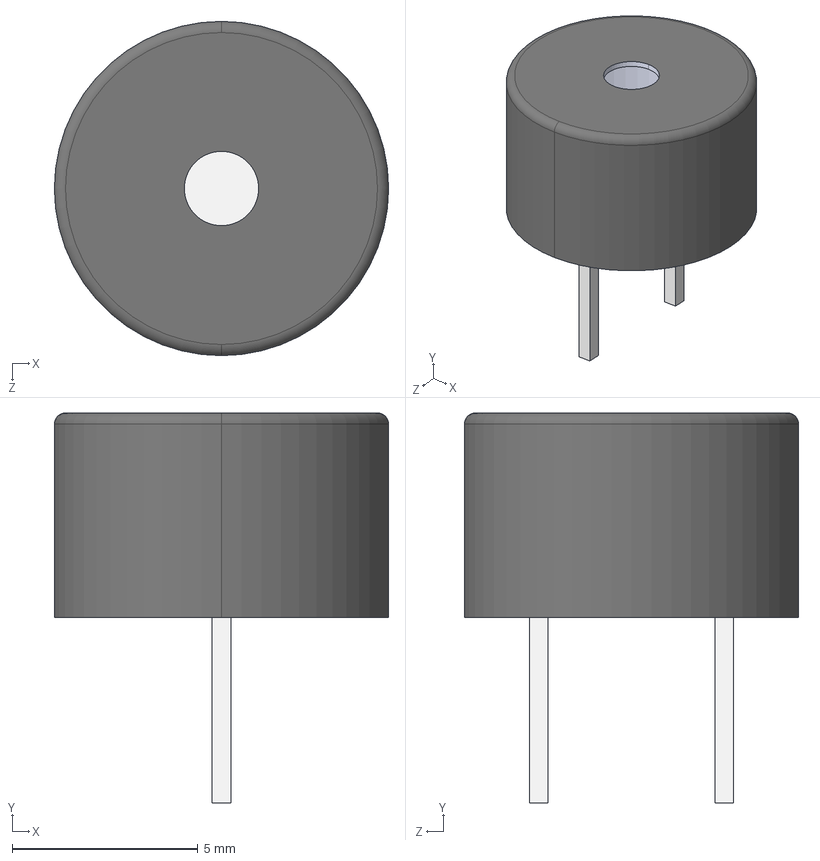
[picture p100: CAD file, 2024-09-17]
3D/Buzzer/Buzzer 9 mm.STEP
9.00 x 10.5 x 9.00 mm
