nguyentrungthao/KicadLibrary/3D/Capacitor/Cap_SMD/AluminumCap/100uF 35V.STEP

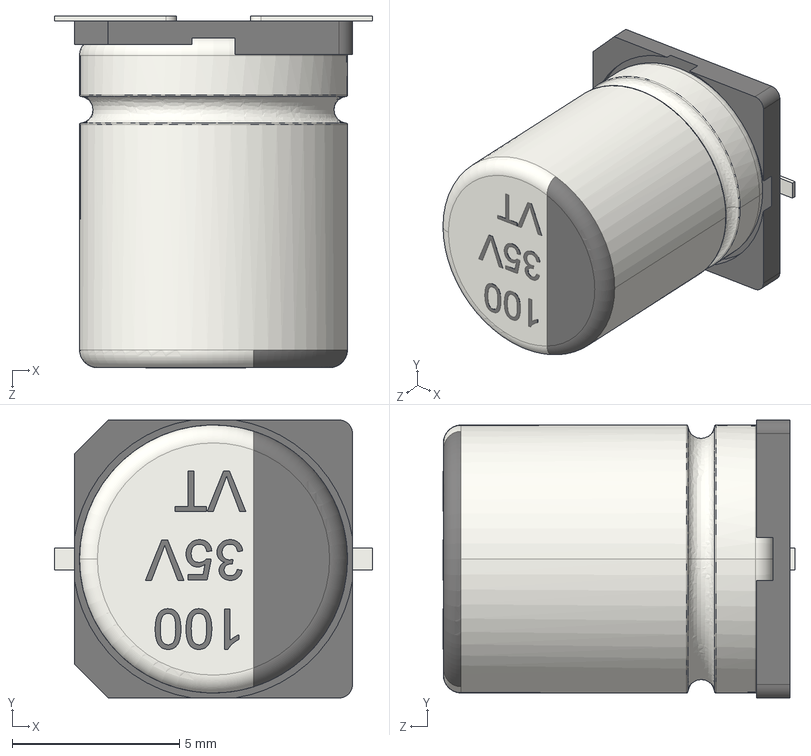
[picture p101: CAD file, 2024-09-17]
3D/Capacitor/Cap_SMD/AluminumCap/100uF 35V.STEP
9.50 x 8.30 x 10.5 mm
