nguyentrungthao/KicadLibrary/3D/Capacitor/Cap_SMD/CAP/Film Capacitor P10/FILM_GREY_P1000L1300W600H1200PD80.stp

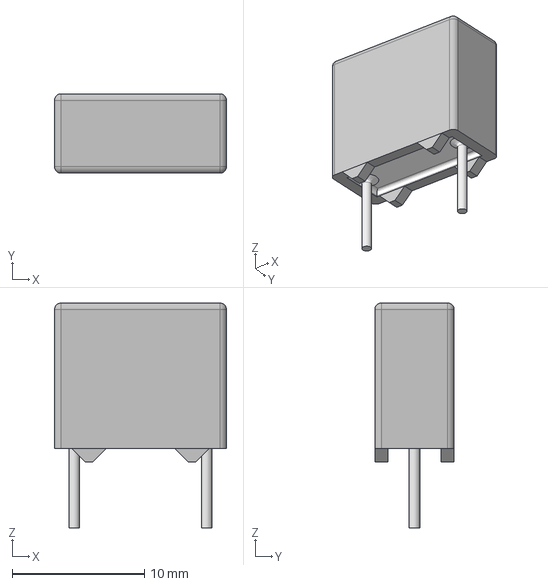
[picture p103: CAD file, 2024-09-17]
3D/Capacitor/Cap_SMD/CAP/Film Capacitor P10/FILM_GREY_P1000L1300W600H1200PD80.stp
13.0 x 6.00 x 17.0 mm
