nguyentrungthao/KicadLibrary/3D/Capacitor/Cap_SMD/CAP/Film Capacitor P22.5/FILM_GREY_P2250L2650W1100H2000PD80.stp

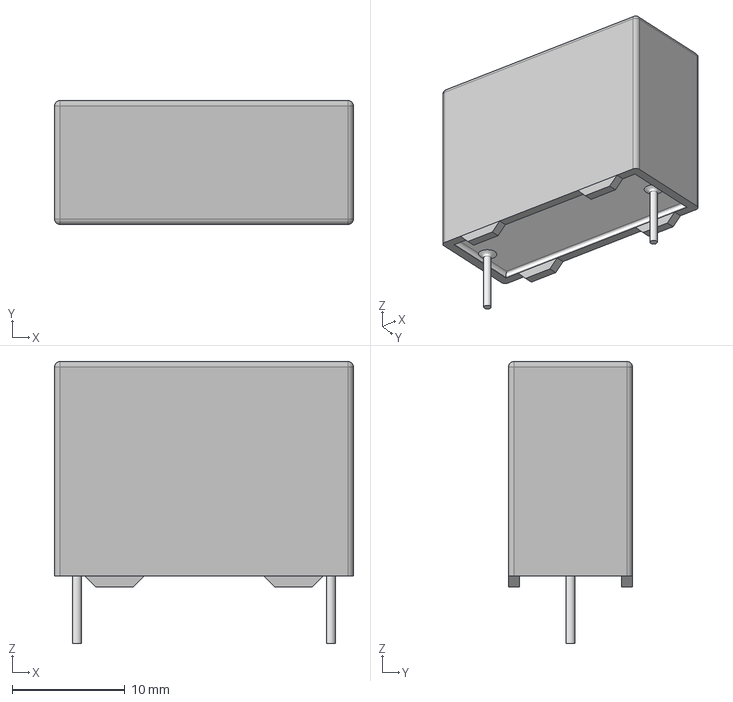
[picture p104: CAD file, 2024-09-17]
3D/Capacitor/Cap_SMD/CAP/Film Capacitor P22.5/FILM_GREY_P2250L2650W1100H2000PD80.stp
26.5 x 11.0 x 25.0 mm
