nguyentrungthao/KicadLibrary/3D/Capacitor/Cap_SMD/CAP/Film Capacitor P27.5/FILM_BLUE_P2750L3200W1500H2600PD90.stp

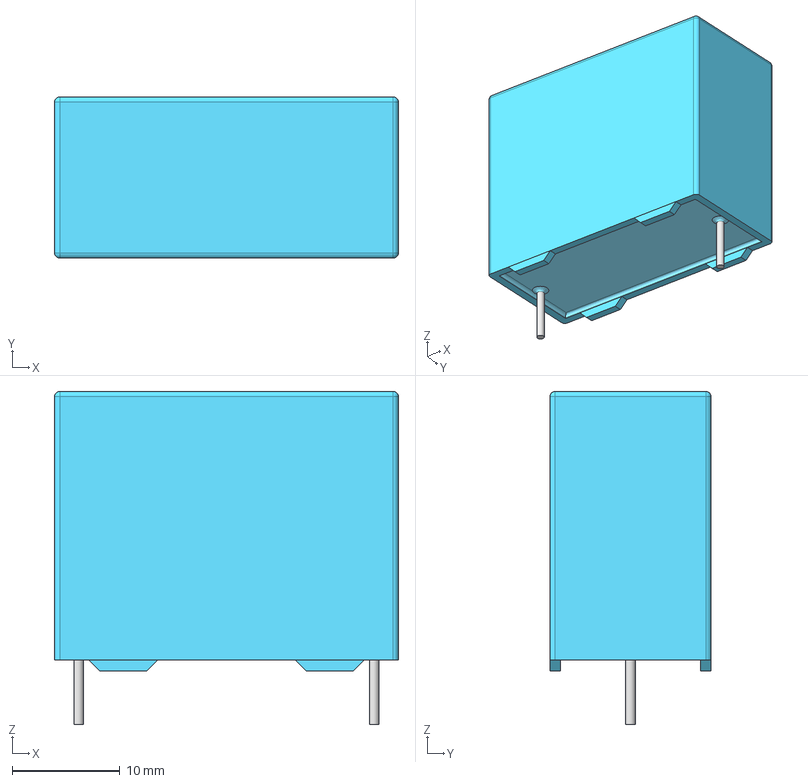
[picture p105: CAD file, 2024-09-17]
3D/Capacitor/Cap_SMD/CAP/Film Capacitor P27.5/FILM_BLUE_P2750L3200W1500H2600PD90.stp
32.0 x 15.0 x 31.0 mm
