nguyentrungthao/KicadLibrary/3D/Capacitor/Cap_SMD/CAP/Film Capacitor P37.5/FILM_GREY_P3750L4150W2000H4000PD100.stp

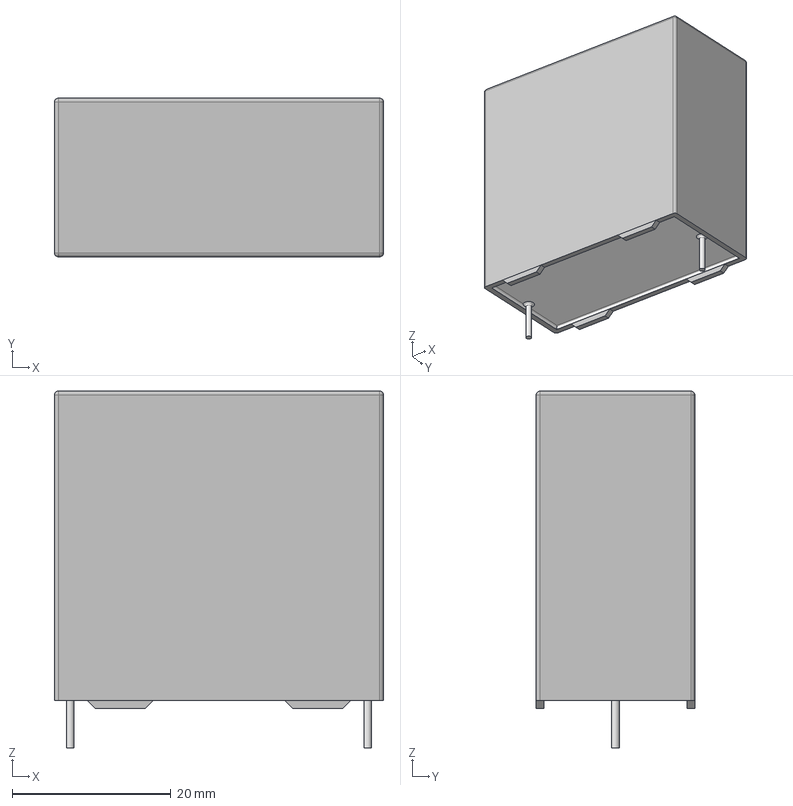
[picture p106: CAD file, 2024-09-17]
3D/Capacitor/Cap_SMD/CAP/Film Capacitor P37.5/FILM_GREY_P3750L4150W2000H4000PD100.stp
41.5 x 20.0 x 45.0 mm
