nguyentrungthao/KicadLibrary/3D/Capacitor/Cap_SMD/Tantalum/Tantalum SMD Capacitor .step

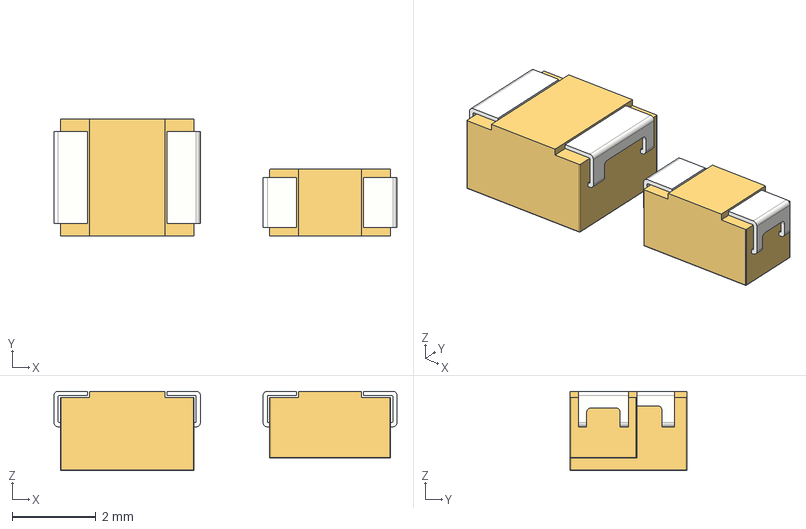
[picture p107: CAD file, 2024-09-17]
3D/Capacitor/Cap_SMD/Tantalum/Tantalum SMD Capacitor .step
8.20 x 2.80 x 1.90 mm
