nguyentrungthao/KicadLibrary/3D/Capacitor/Cap_THT/CAP/2200uF 63V electr -20x42mm -P.diameter 10mm.stp

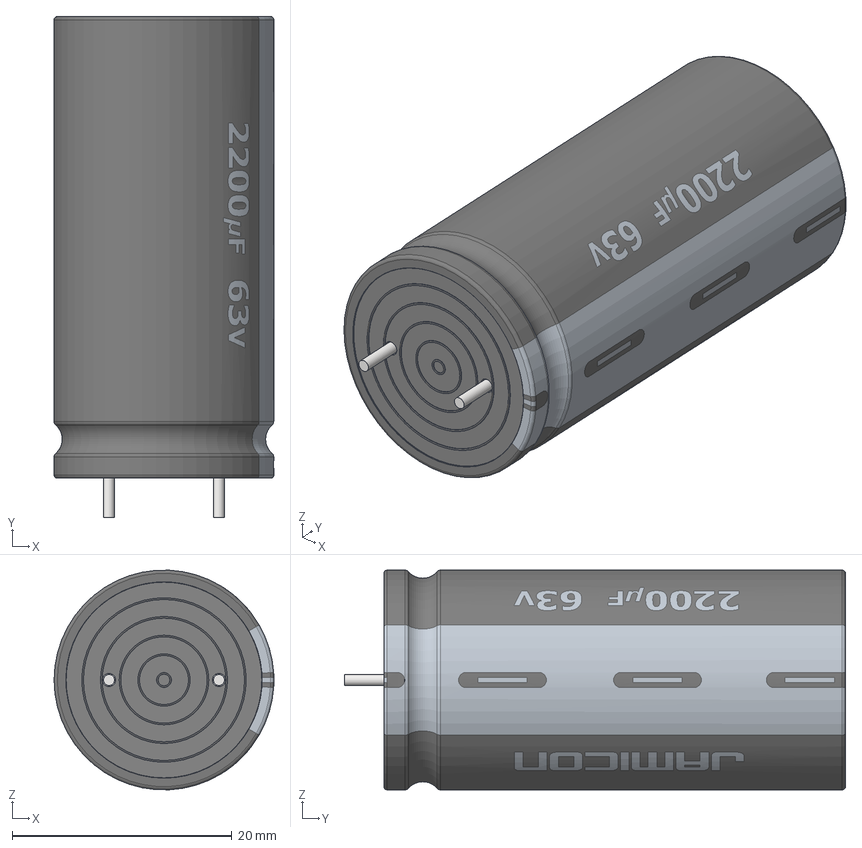
[picture p108: CAD file, 2024-09-17]
3D/Capacitor/Cap_THT/CAP/2200uF 63V electr -20x42mm -P.diameter 10mm.stp
20.0 x 45.6 x 20.0 mm
