nguyentrungthao/KicadLibrary/3D/Capacitor/Cap_THT/Film Capacitor P15/FILM_GREY_P1500L1800W1100H1900PD80.stp

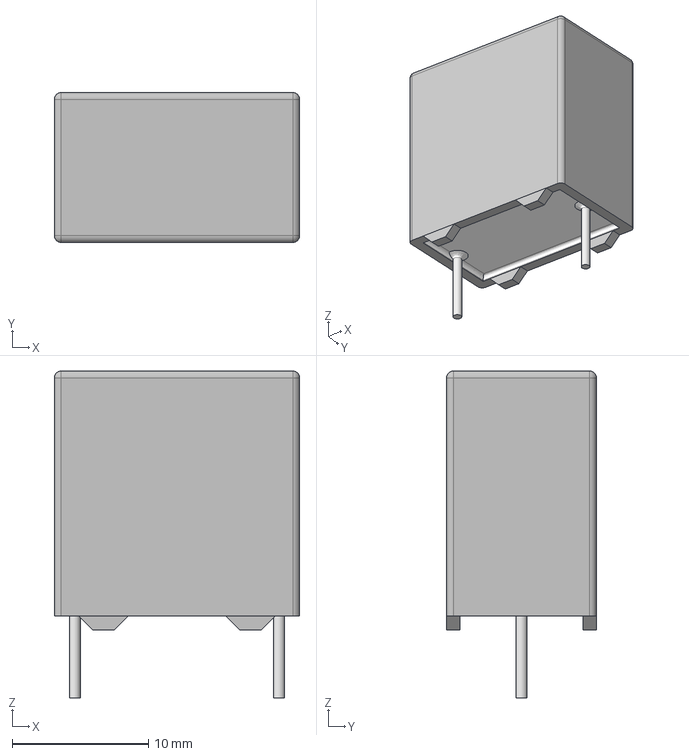
[picture p109: CAD file, 2024-09-17]
3D/Capacitor/Cap_THT/Film Capacitor P15/FILM_GREY_P1500L1800W1100H1900PD80.stp
18.0 x 11.0 x 24.0 mm
