nguyentrungthao/KicadLibrary/3D/Capacitor/Cap_THT/FilmCap/Film Capacitor P22.5/FILM_GREY_P2250L2650W850H1700PD80.stp

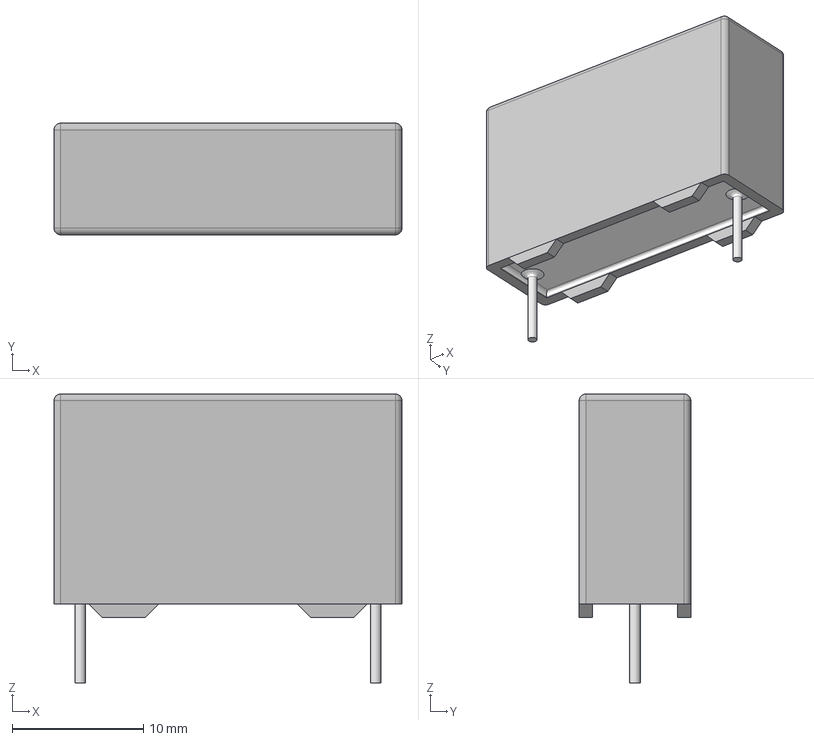
[picture p110: CAD file, 2024-09-17]
3D/Capacitor/Cap_THT/FilmCap/Film Capacitor P22.5/FILM_GREY_P2250L2650W850H1700PD80.stp
26.5 x 8.50 x 22.0 mm
