nguyentrungthao/KicadLibrary/3D/Capacitor/Cap_THT/FilmCap/Film Capacitor P27.5/FILM_BLUE_P2750L3200W2200H3700PD90.stp

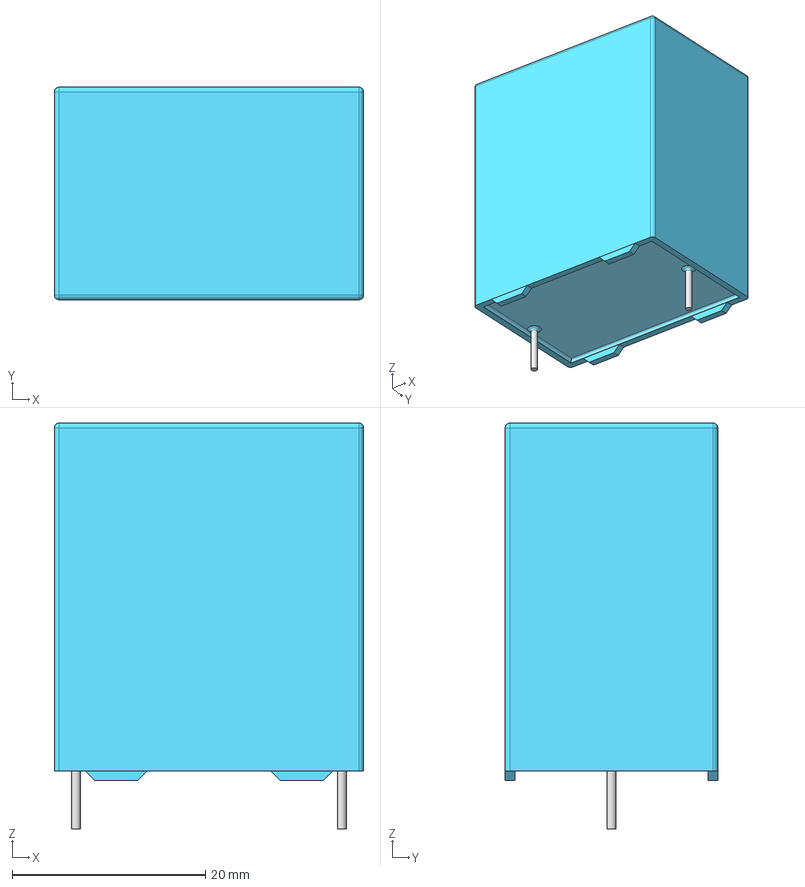
[picture p111: CAD file, 2024-09-17]
3D/Capacitor/Cap_THT/FilmCap/Film Capacitor P27.5/FILM_BLUE_P2750L3200W2200H3700PD90.stp
32.0 x 22.0 x 42.0 mm
