nguyentrungthao/KicadLibrary/3D/Capacitor/Cap_THT/FilmCap/Film Capacitor P37.5/FILM_GREY_P3750L4150W2400H1900PD100.stp

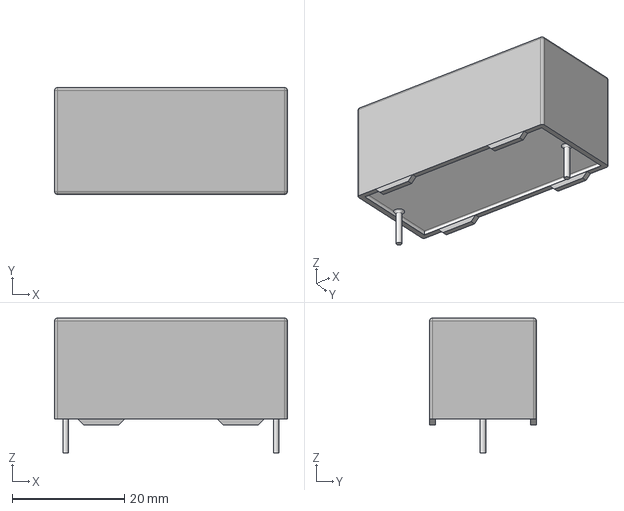
[picture p112: CAD file, 2024-09-17]
3D/Capacitor/Cap_THT/FilmCap/Film Capacitor P37.5/FILM_GREY_P3750L4150W2400H1900PD100.stp
41.5 x 19.0 x 24.0 mm
