nguyentrungthao/KicadLibrary/3D/Capacitor/Cap_THT/MKT/MKT Capacitor Yellow (Double Width).step

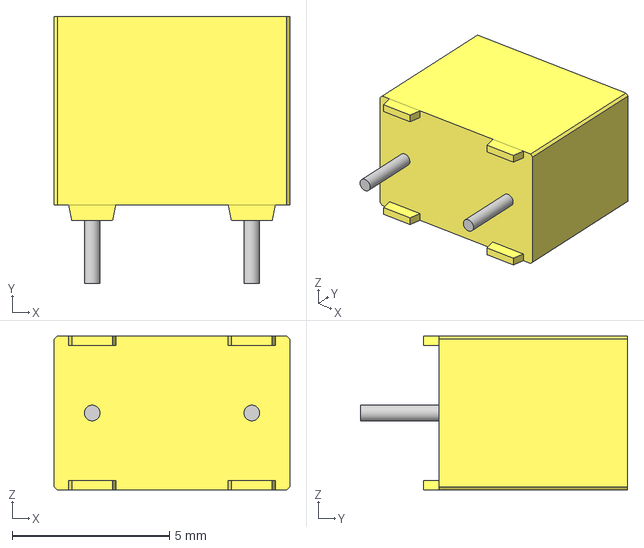
[picture p113: CAD file, 2024-09-17]
3D/Capacitor/Cap_THT/MKT/MKT Capacitor Yellow (Double Width).step
7.50 x 8.50 x 4.90 mm
