nguyentrungthao/KicadLibrary/3D/Comunication/TD301D485/User Library-TDx01D485.step

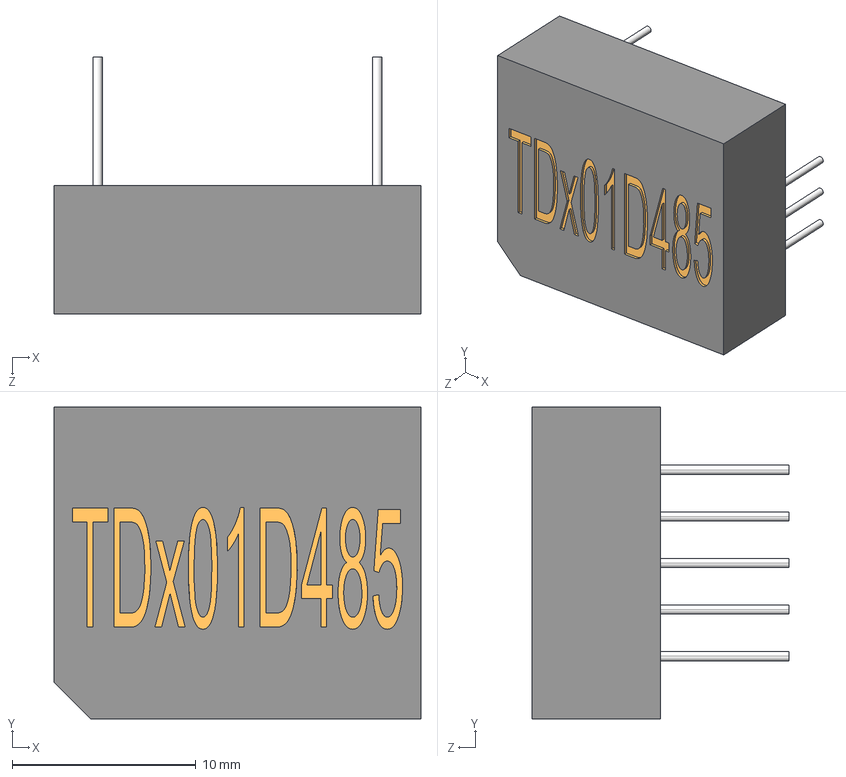
[picture p114: CAD file, 2024-09-17]
3D/Comunication/TD301D485/User Library-TDx01D485.step
20.0 x 17.0 x 14.0 mm
