nguyentrungthao/KicadLibrary/3D/Connector/Banana/4mm Panel Mount Banana Socket.stp

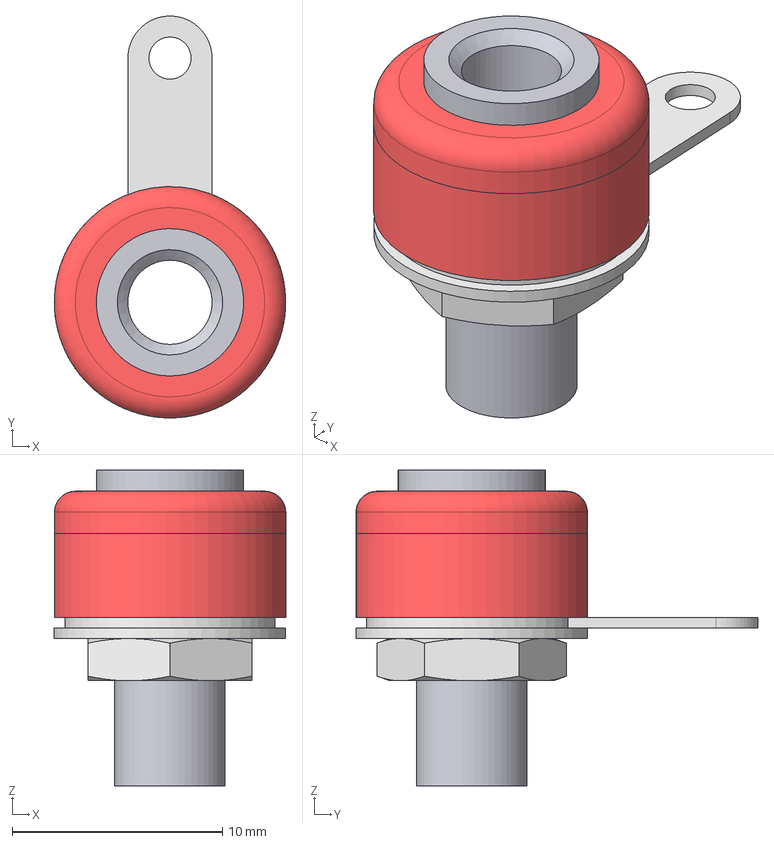
[picture p115: CAD file, 2024-09-17]
3D/Connector/Banana/4mm Panel Mount Banana Socket.stp
11.0 x 19.1 x 15.0 mm
Plastic Cap
Plastic Cap top
Socket Tube
Wire Connector
Washer
Connector Nut
