nguyentrungthao/KicadLibrary/3D/Connector/Barrel Jack SMD/BarrelJackSMD v3.step

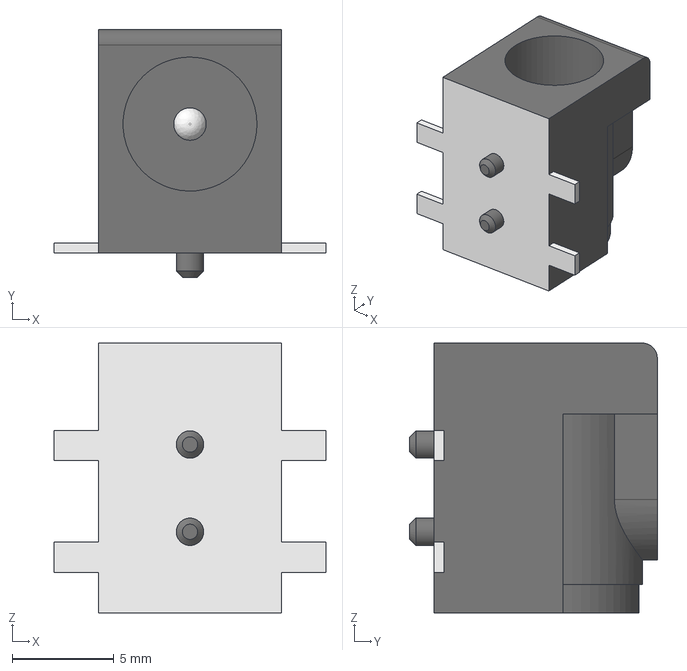
[picture p116: CAD file, 2024-09-17]
3D/Connector/Barrel Jack SMD/BarrelJackSMD v3.step
13.4 x 12.2 x 13.3 mm
