nguyentrungthao/KicadLibrary/3D/Connector/DB/Db15 male PCB Connector.STEP

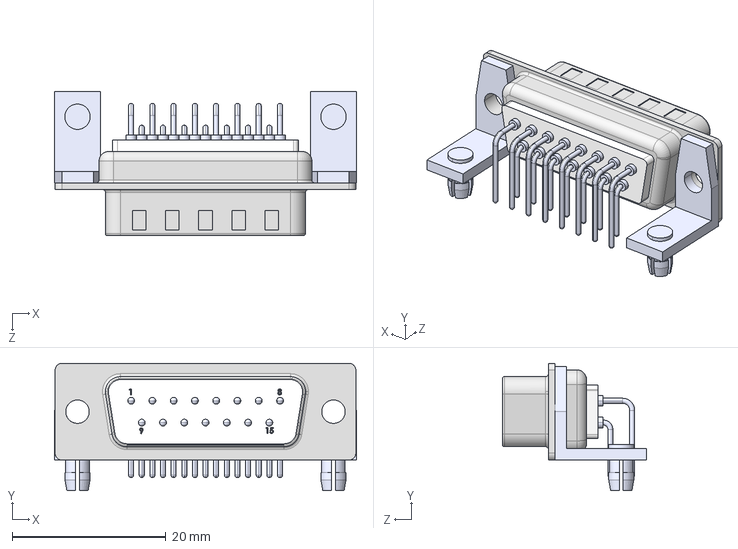
[picture p117: CAD file, 2024-09-17]
3D/Connector/DB/Db15 male PCB Connector.STEP
39.3 x 16.6 x 18.8 mm
