nguyentrungthao/KicadLibrary/3D/Connector/DB/VGA_DB15_PCB_RightAngle/VGA connector on plate (short).STEP

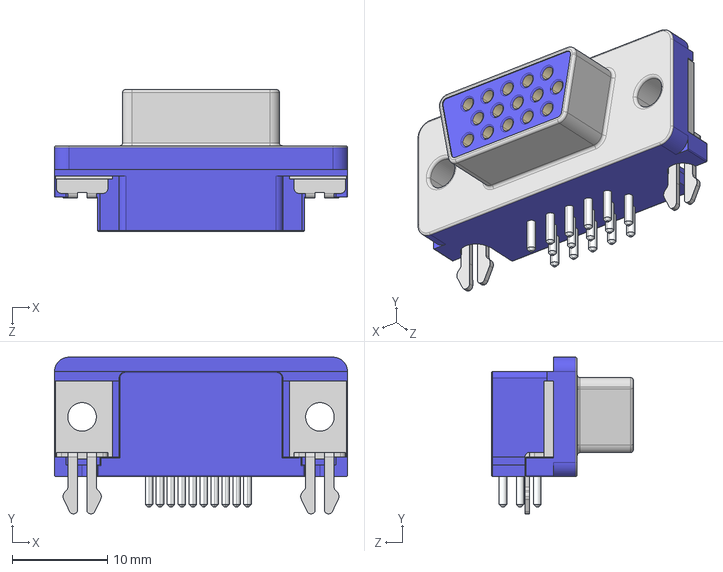
[picture p118: CAD file, 2024-09-17]
3D/Connector/DB/VGA_DB15_PCB_RightAngle/VGA connector on plate (short).STEP
30.8 x 16.5 x 14.9 mm
