nguyentrungthao/KicadLibrary/3D/Connector/FPC/FFC3B05-20-T.stp

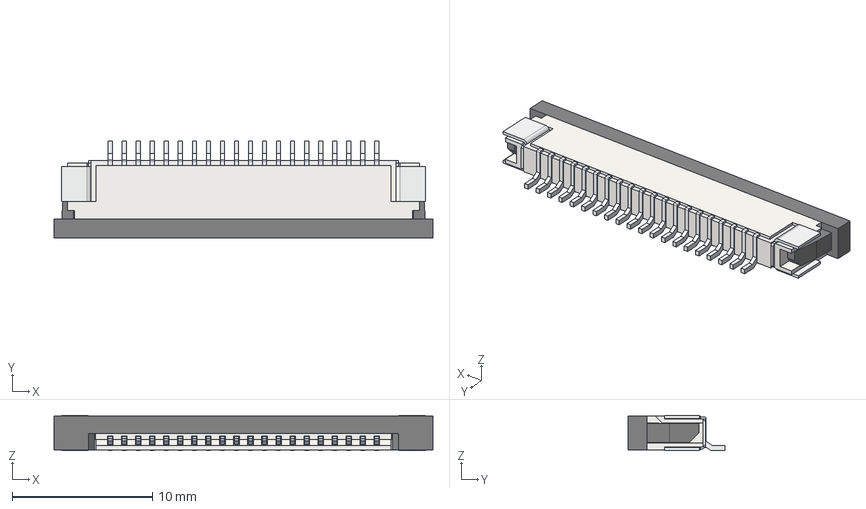
[picture p119: CAD file, 2024-09-17]
3D/Connector/FPC/FFC3B05-20-T.stp
27.0 x 6.90 x 2.50 mm
