nguyentrungthao/KicadLibrary/3D/Connector/GroveConnector/Grove Connector (flat).STEP

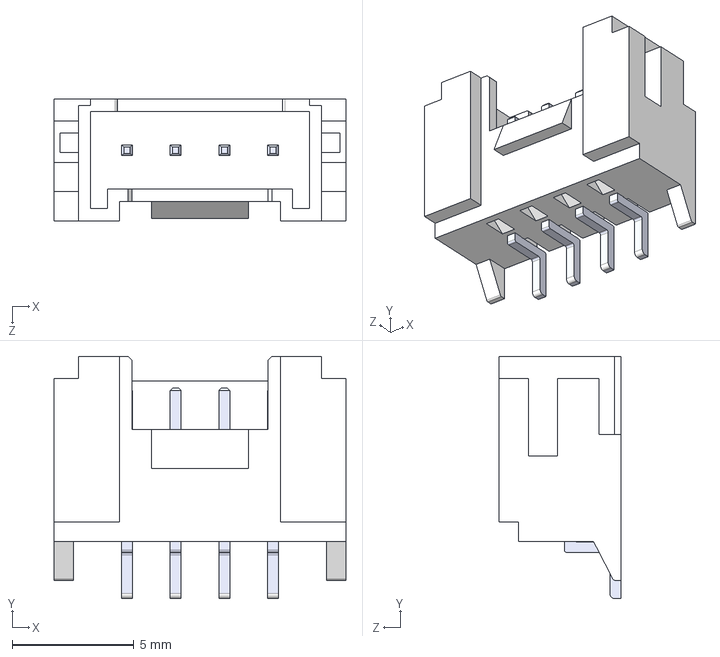
[picture p120: CAD file, 2024-09-17]
3D/Connector/GroveConnector/Grove Connector (flat).STEP
12.0 x 9.95 x 5.00 mm
