nguyentrungthao/KicadLibrary/3D/Connector/Header Male 2.0mm/2x2 2.0MM MALE SMD.STEP

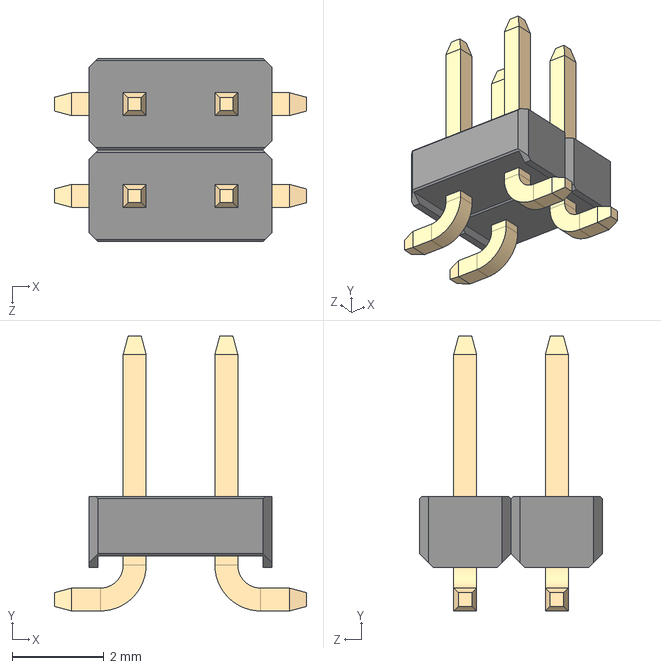
[picture p121: CAD file, 2024-09-17]
3D/Connector/Header Male 2.0mm/2x2 2.0MM MALE SMD.STEP
5.50 x 6.00 x 4.00 mm
