nguyentrungthao/KicadLibrary/3D/Connector/Header Male 2.0mm/TH/Pin Header 2x7 TH Pitch 2.54mm.stp

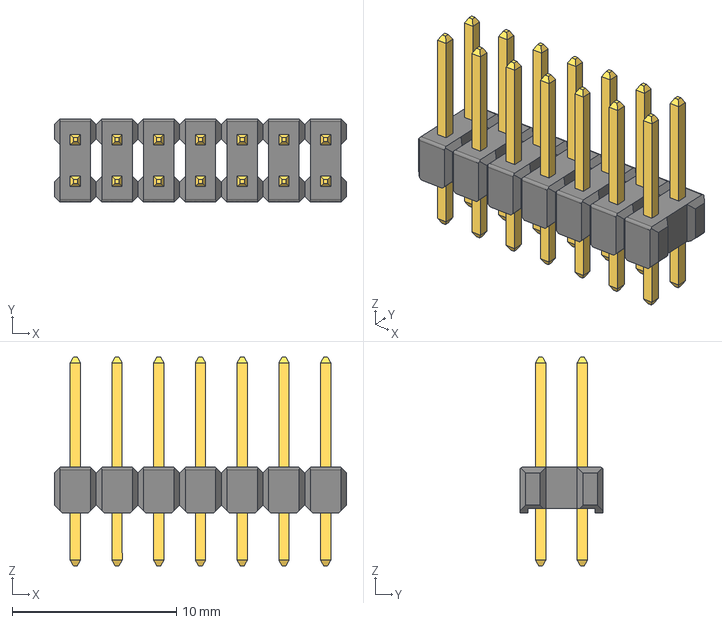
[picture p122: CAD file, 2024-09-17]
3D/Connector/Header Male 2.0mm/TH/Pin Header 2x7 TH Pitch 2.54mm.stp
17.8 x 5.08 x 12.7 mm
