nguyentrungthao/KicadLibrary/3D/Connector/Header/Header 2.0mm/Header Male 2.0mm/2x3 2.0MM MALE SMD.STEP

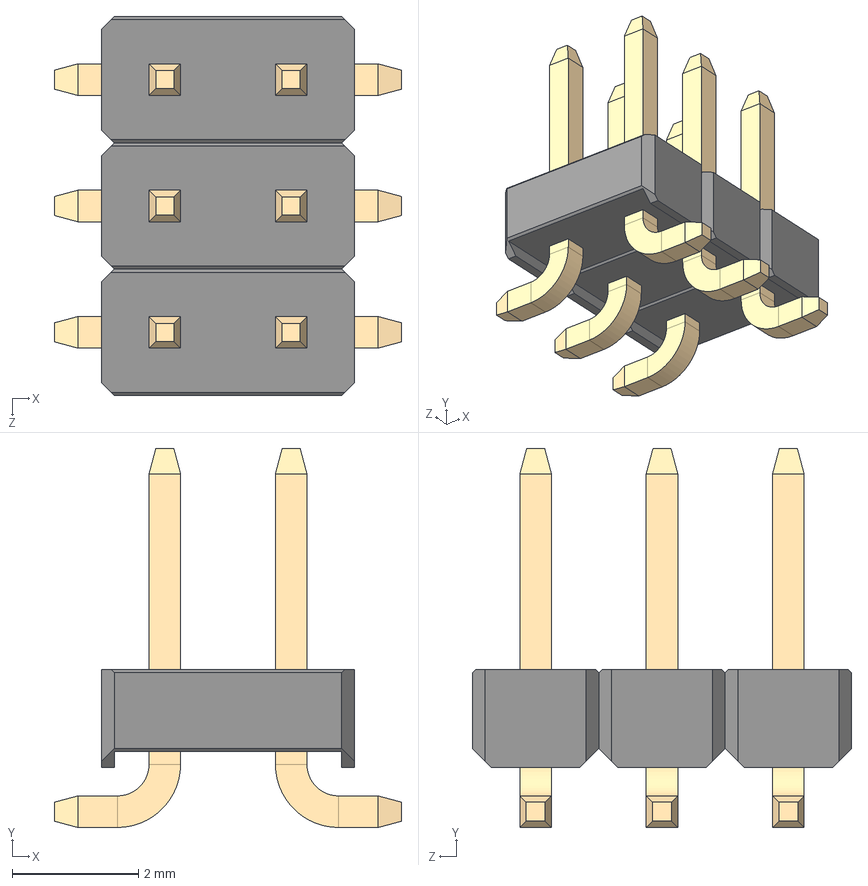
[picture p123: CAD file, 2024-09-17]
3D/Connector/Header/Header 2.0mm/Header Male 2.0mm/2x3 2.0MM MALE SMD.STEP
5.50 x 6.00 x 6.00 mm
