nguyentrungthao/KicadLibrary/3D/Connector/Header_1-27mm_2Row_SMD/1_27mm_Header/1_27mm_plastic_for_pin.SLDPRT

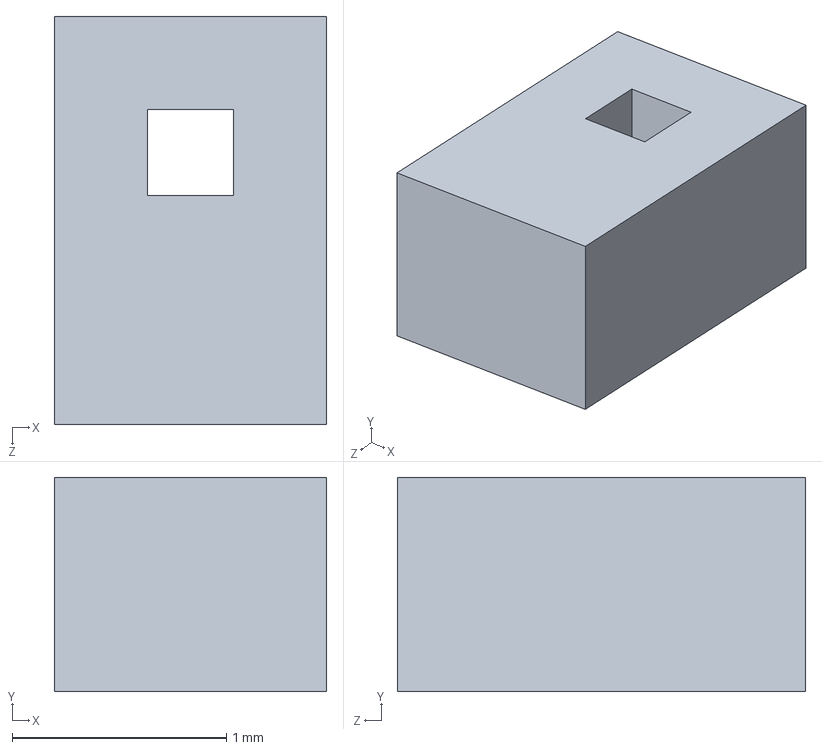
[picture p125: CAD file, 2024-09-17]
3D/Connector/Header_1-27mm_2Row_SMD/1_27mm_Header/1_27mm_plastic_for_pin.SLDPRT
1.27 x 1.00 x 1.90 mm
