nguyentrungthao/KicadLibrary/3D/Connector/HT-3.96/HT396 3.96 Connector Green v1.step

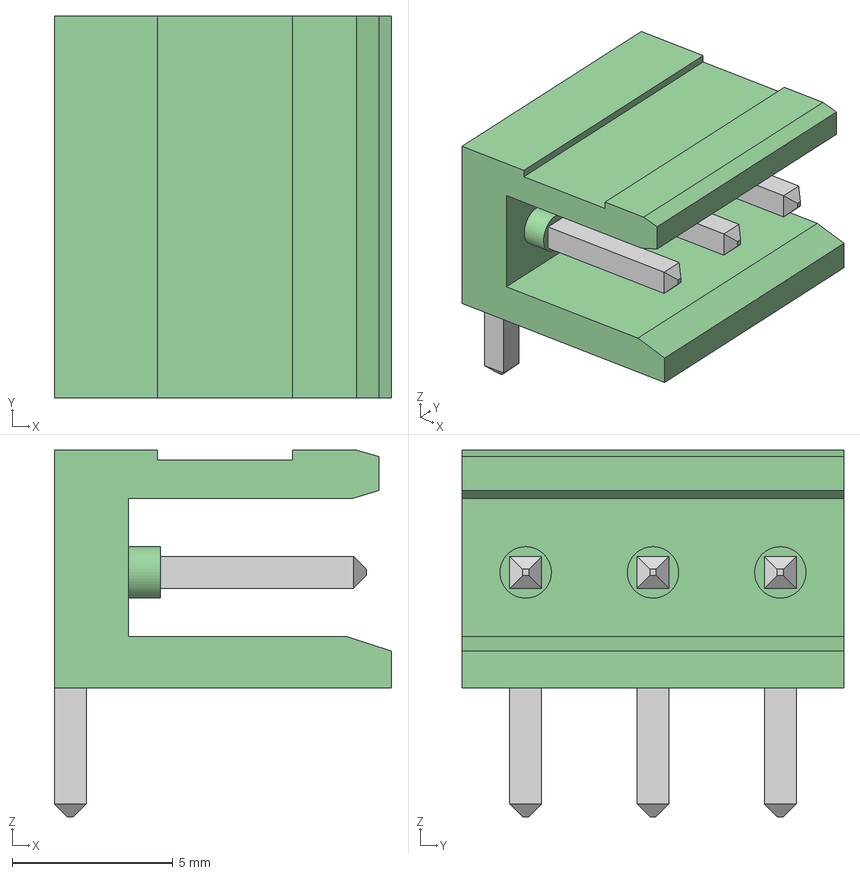
[picture p126: CAD file, 2024-09-17]
3D/Connector/HT-3.96/HT396 3.96 Connector Green v1.step
10.5 x 11.9 x 11.4 mm
