nguyentrungthao/KicadLibrary/3D/Connector/IDC/bh-connector-set-1.snapshot.1/BH-14.STEP

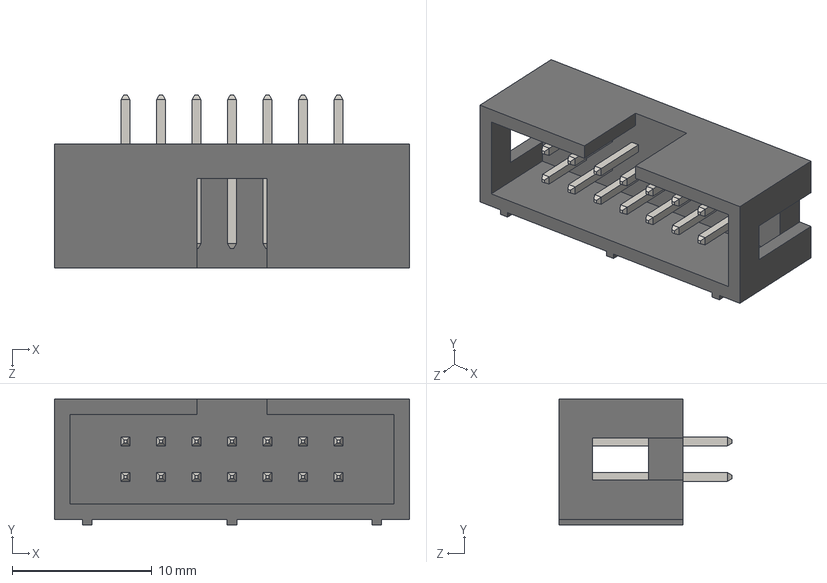
[picture p127: CAD file, 2024-09-17]
3D/Connector/IDC/bh-connector-set-1.snapshot.1/BH-14.STEP
25.4 x 9.00 x 12.4 mm
