nguyentrungthao/KicadLibrary/3D/Connector/IDC/IDC Connector 2.54mm/DS1013 (IDC CONNFLY)/DS1013-14S (IDC-14MS CONNFLY).stp

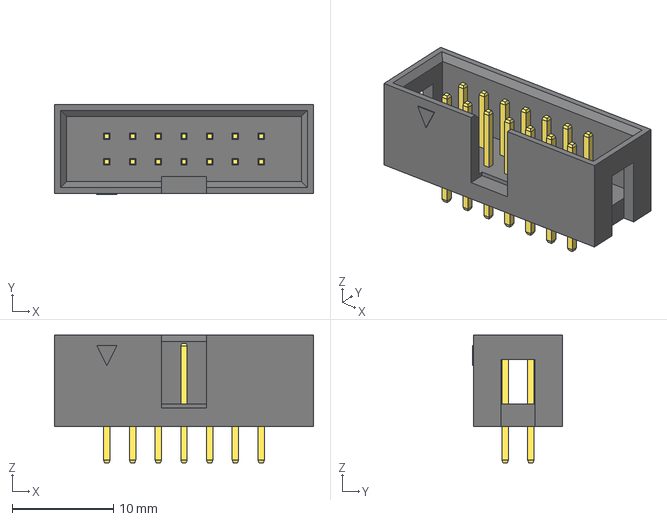
[picture p128: CAD file, 2024-09-17]
3D/Connector/IDC/IDC Connector 2.54mm/DS1013 (IDC CONNFLY)/DS1013-14S (IDC-14MS CONNFLY).stp
25.6 x 8.90 x 12.6 mm
