nguyentrungthao/KicadLibrary/3D/Connector/IPEX_Antenna/SMA-angled.STEP

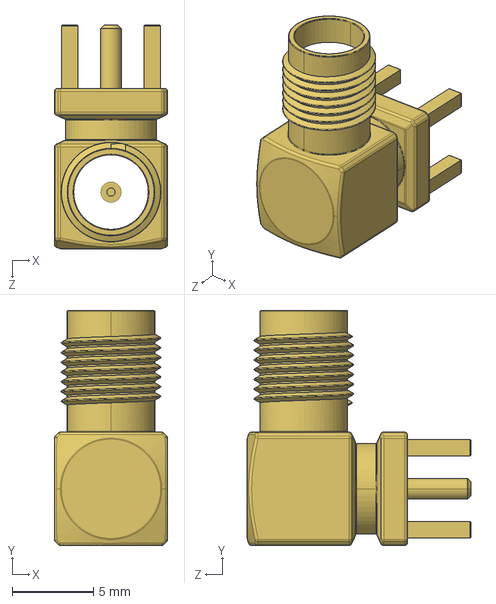
[picture p131: CAD file, 2024-09-17]
3D/Connector/IPEX_Antenna/SMA-angled.STEP
7.00 x 14.5 x 13.8 mm
