nguyentrungthao/KicadLibrary/3D/Connector/Jack_DC/DC Power Jack 5.5mm x 2.1mm.STEP

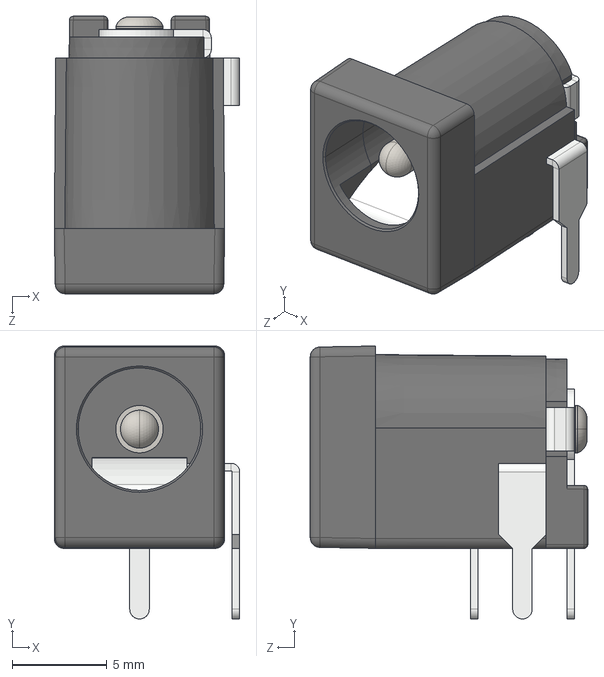
[picture p132: CAD file, 2024-09-17]
3D/Connector/Jack_DC/DC Power Jack 5.5mm x 2.1mm.STEP
9.77 x 14.4 x 14.6 mm
