nguyentrungthao/KicadLibrary/3D/Connector/JST/DIP/JST-CH-Thru-Vertical-3.96mm/JST - CH - Thru - Right- 3.96mm/JST - CH - Thru (R) - 11Pin - 3.96mm.stp

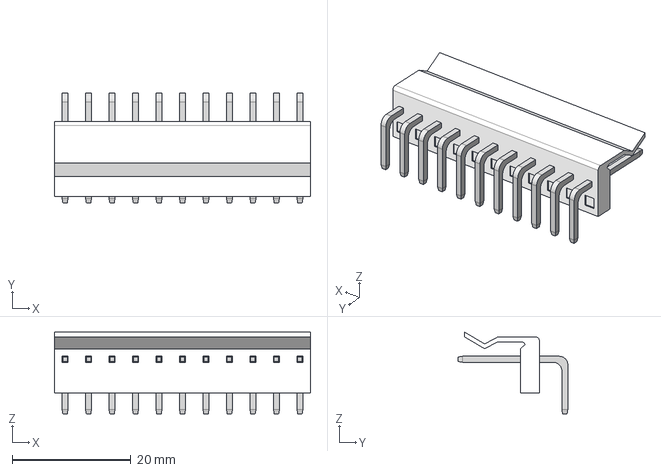
[picture p133: CAD file, 2024-09-17]
3D/Connector/JST/DIP/JST-CH-Thru-Vertical-3.96mm/JST - CH - Thru - Right- 3.96mm/JST - CH - Thru (R) - 11Pin - 3.96mm.stp
43.2 x 18.5 x 13.8 mm
