nguyentrungthao/KicadLibrary/3D/Connector/JST/DIP/JST-CH-Thru-Vertical-3.96mm/JST - CH - Thru - Vertical - 3.96mm/JST - CH - Thru (V) - 7Pin - 3.96mm.stp

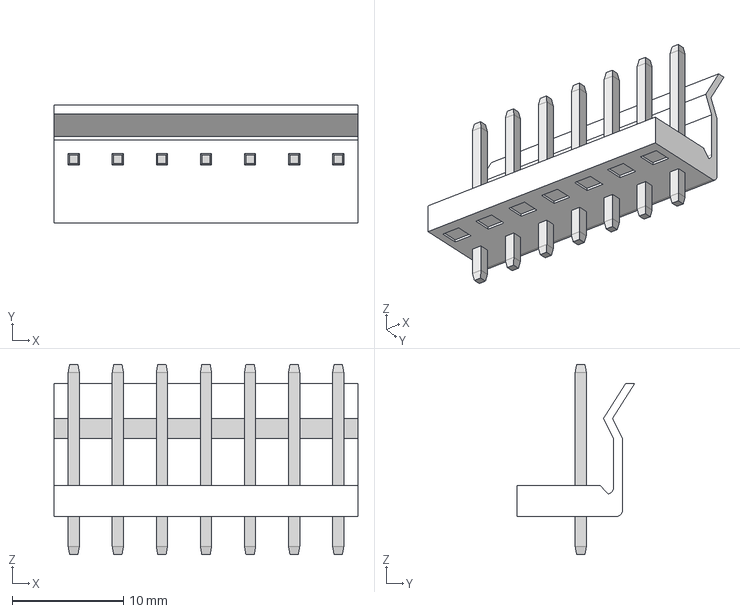
[picture p134: CAD file, 2024-09-17]
3D/Connector/JST/DIP/JST-CH-Thru-Vertical-3.96mm/JST - CH - Thru - Vertical - 3.96mm/JST - CH - Thru (V) - 7Pin - 3.96mm.stp
27.3 x 10.6 x 17.1 mm
