nguyentrungthao/KicadLibrary/3D/Connector/JST/DIP/JST-PH-Thru-Vertical-2.00mm/JST - PH - Thru (V) - 3Pin - 2.00mm.stp

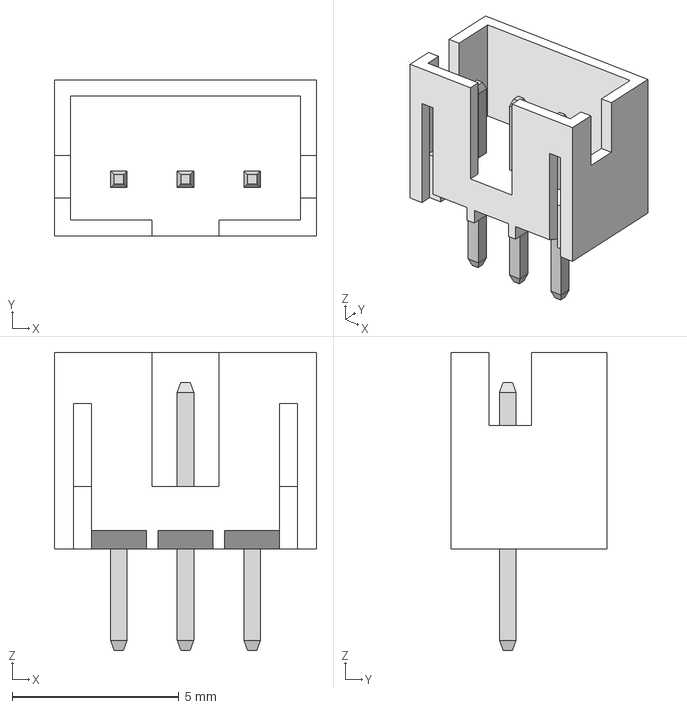
[picture p135: CAD file, 2024-09-17]
3D/Connector/JST/DIP/JST-PH-Thru-Vertical-2.00mm/JST - PH - Thru (V) - 3Pin - 2.00mm.stp
7.86 x 4.67 x 8.94 mm
