nguyentrungthao/KicadLibrary/3D/Connector/JST/DIP/JST-VH-Thru-Vertical-3.96mm/JST - VH - Thru (V) - 3Pin - 3.96mm.stp

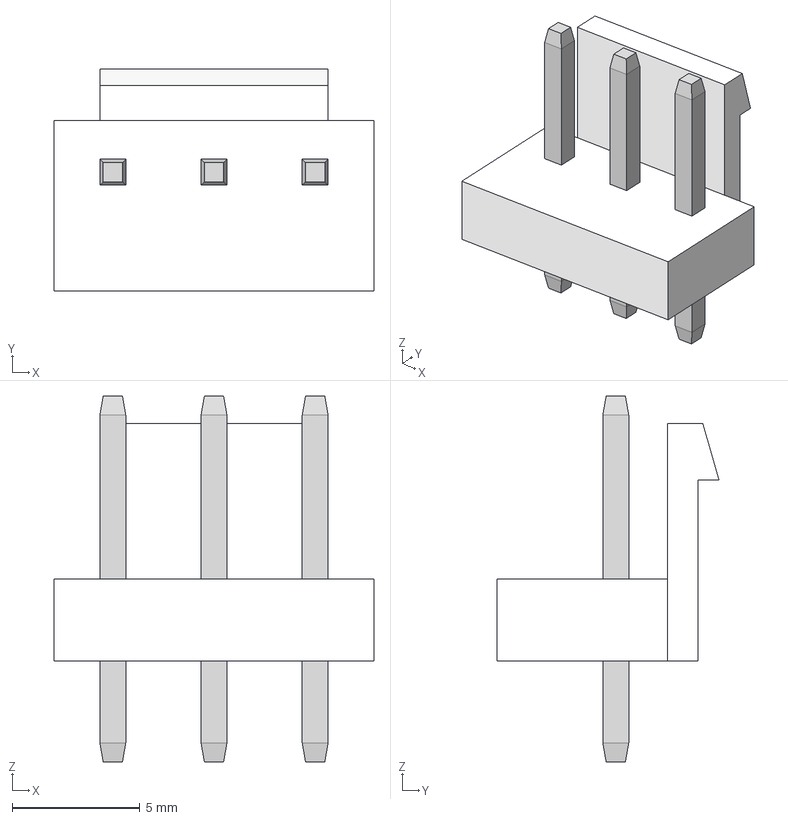
[picture p136: CAD file, 2024-09-17]
3D/Connector/JST/DIP/JST-VH-Thru-Vertical-3.96mm/JST - VH - Thru (V) - 3Pin - 3.96mm.stp
12.5 x 8.69 x 14.3 mm
