nguyentrungthao/KicadLibrary/3D/Connector/JST/DIP/JST-XH-Thru-Vertical-2.54mm-8P/JST XH 8 S8B-XH-A1 shrouded header connector v4.step

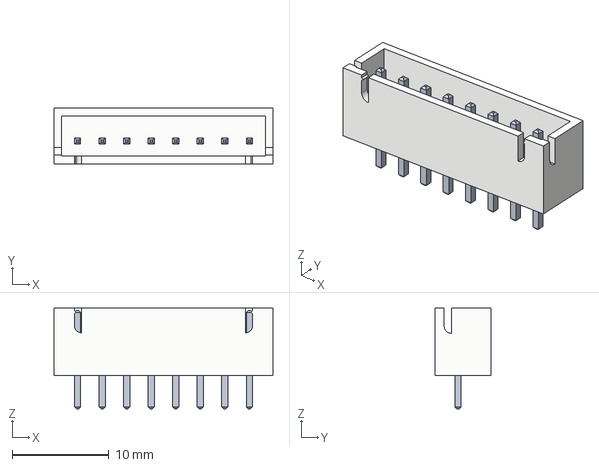
[picture p140: CAD file, 2024-09-17]
3D/Connector/JST/DIP/JST-XH-Thru-Vertical-2.54mm-8P/JST XH 8 S8B-XH-A1 shrouded header connector v4.step
22.7 x 5.75 x 10.4 mm
