nguyentrungthao/KicadLibrary/3D/Connector/JST/SMD/JST-PH-SMD-Right-2.0mm/JST - PH - SMD (R) - 12Pin - 2.00mm.stp

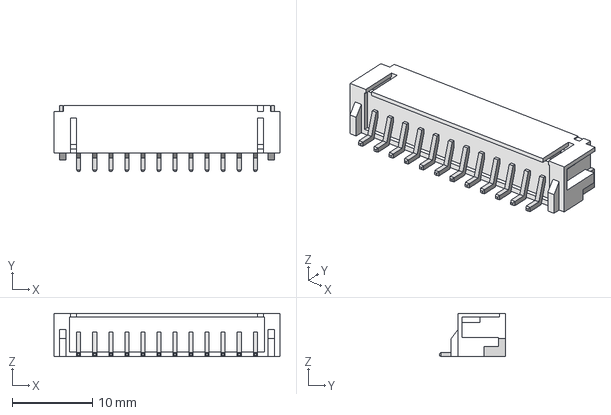
[picture p141: CAD file, 2024-09-17]
3D/Connector/JST/SMD/JST-PH-SMD-Right-2.0mm/JST - PH - SMD (R) - 12Pin - 2.00mm.stp
28.1 x 8.26 x 5.38 mm
