nguyentrungthao/KicadLibrary/3D/Connector/JST/SMD/JST-XH-SMD-Right-2.54mm/S2B-XH-SM4-TB.STEP

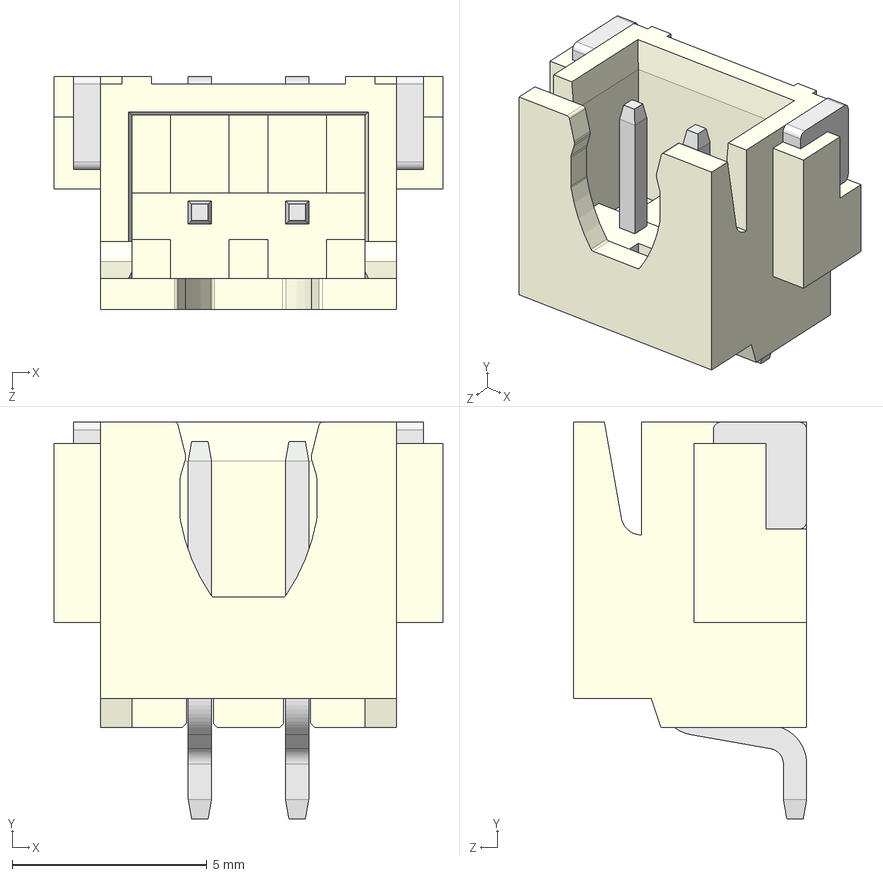
[picture p142: CAD file, 2024-09-17]
3D/Connector/JST/SMD/JST-XH-SMD-Right-2.54mm/S2B-XH-SM4-TB.STEP
10.0 x 10.2 x 6.00 mm
