nguyentrungthao/KicadLibrary/3D/Connector/JST_Connector/JST_PH_2.0mm_DIP/JST - PH - SMD - Right - 1.25mm/JST - PH - SMD (R) - 11Pin - 2.00mm.stp

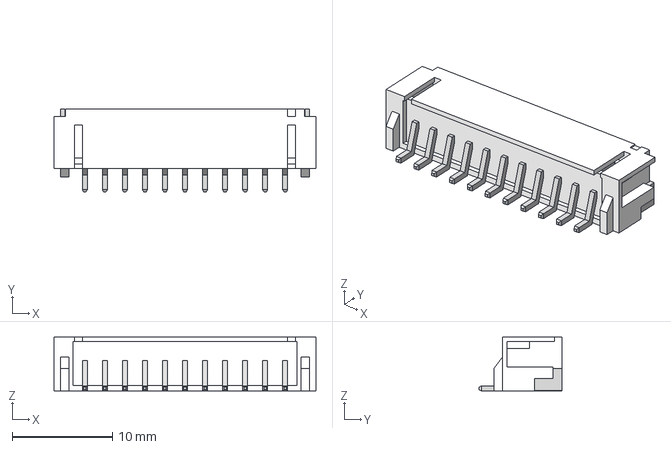
[picture p143: CAD file, 2024-09-17]
3D/Connector/JST_Connector/JST_PH_2.0mm_DIP/JST - PH - SMD - Right - 1.25mm/JST - PH - SMD (R) - 11Pin - 2.00mm.stp
26.1 x 8.26 x 5.38 mm
