nguyentrungthao/KicadLibrary/3D/Connector/JST_Connector/JST_PH_2.0mm_DIP/JST - PH - Thru - Vertical - 2.00mm/JST - PH - Thru (V) - 2Pin - 2.00mm.stp

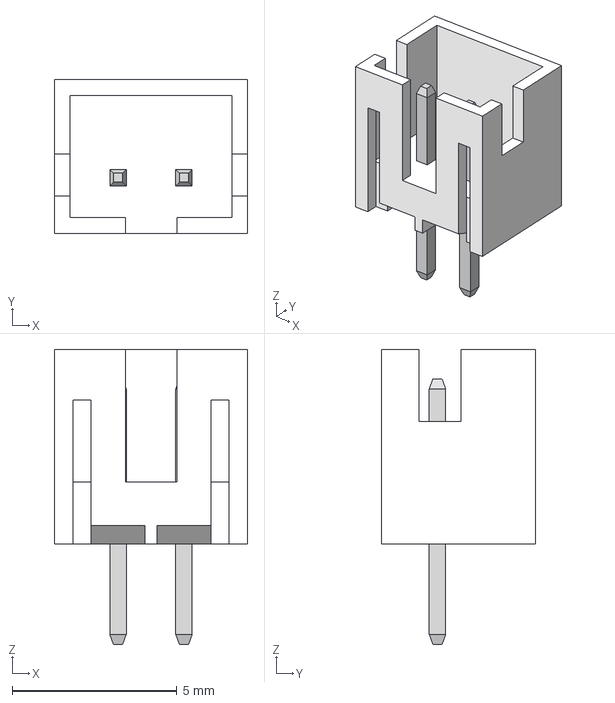
[picture p144: CAD file, 2024-09-17]
3D/Connector/JST_Connector/JST_PH_2.0mm_DIP/JST - PH - Thru - Vertical - 2.00mm/JST - PH - Thru (V) - 2Pin - 2.00mm.stp
5.86 x 4.67 x 8.94 mm
