nguyentrungthao/KicadLibrary/3D/Connector/JST_Connector/JST_XH_2.54mm/S5B-XH-SM4-TB.STEP

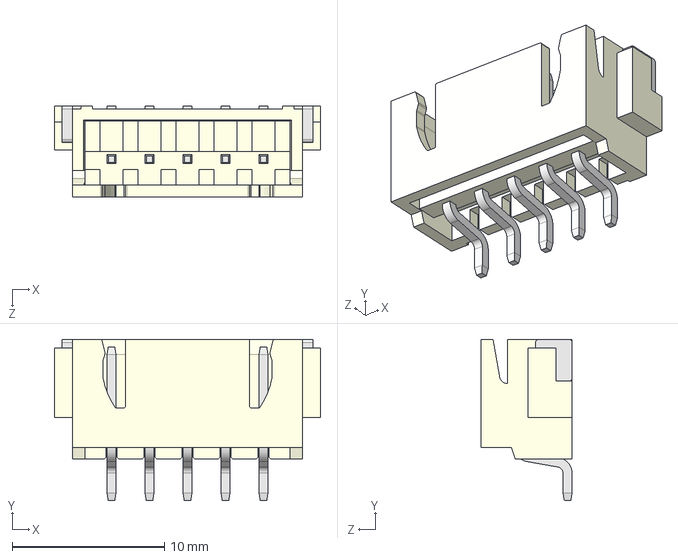
[picture p145: CAD file, 2024-09-17]
3D/Connector/JST_Connector/JST_XH_2.54mm/S5B-XH-SM4-TB.STEP
17.5 x 10.6 x 6.00 mm
