nguyentrungthao/KicadLibrary/3D/Connector/KF-5.08/2P.STEP

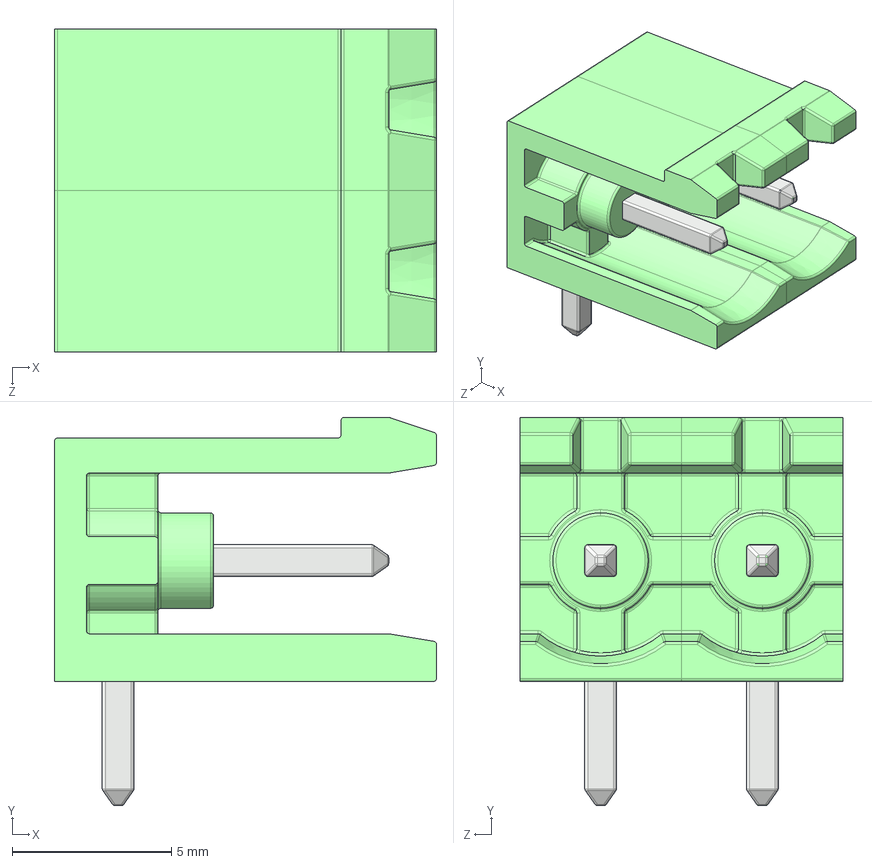
[picture p146: CAD file, 2024-09-17]
3D/Connector/KF-5.08/2P.STEP
12.0 x 12.2 x 10.2 mm
