nguyentrungthao/KicadLibrary/3D/Connector/KF128/TER-KF128-2P.step

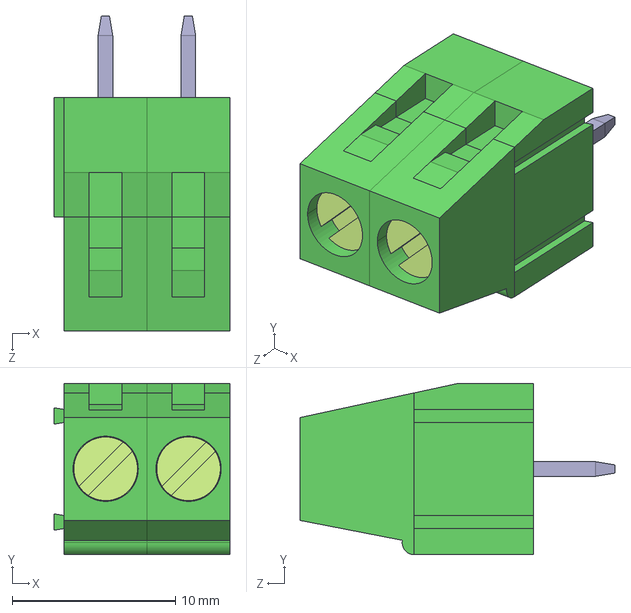
[picture p147: CAD file, 2024-09-17]
3D/Connector/KF128/TER-KF128-2P.step
10.8 x 10.5 x 19.3 mm
