nguyentrungthao/KicadLibrary/3D/Connector/KF2510/molex-2.54-3pin.STEP

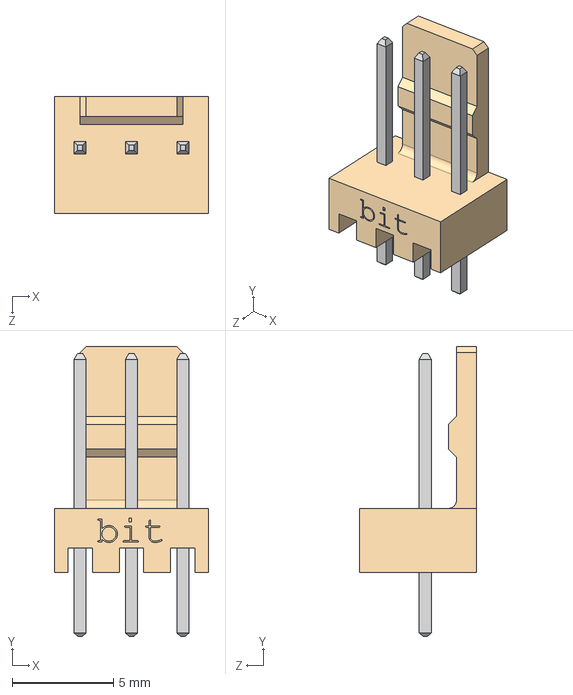
[picture p148: CAD file, 2024-09-17]
3D/Connector/KF2510/molex-2.54-3pin.STEP
7.62 x 14.3 x 5.80 mm
Pieza3
pin x 3
