nguyentrungthao/KicadLibrary/3D/Connector/KF2EDG/3P.STEP

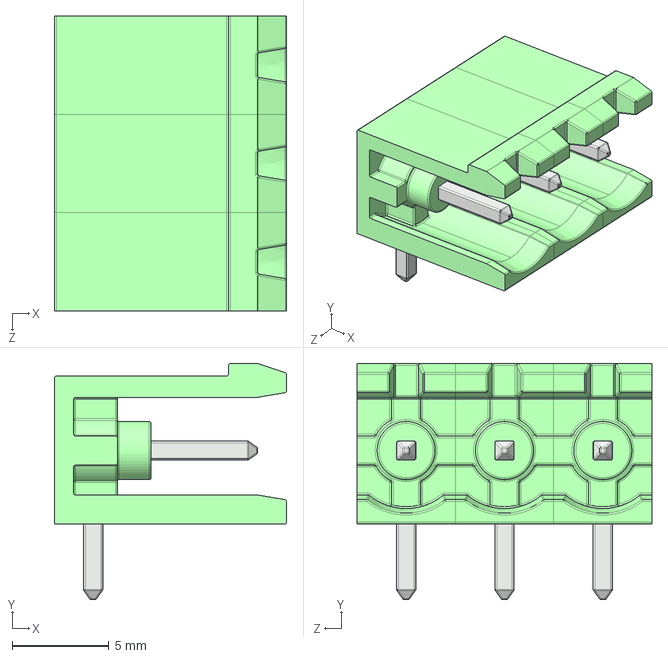
[picture p149: CAD file, 2024-09-17]
3D/Connector/KF2EDG/3P.STEP
12.0 x 12.2 x 15.2 mm
