nguyentrungthao/KicadLibrary/3D/Connector/KF2EDG/KF-5.08/1P.DXF

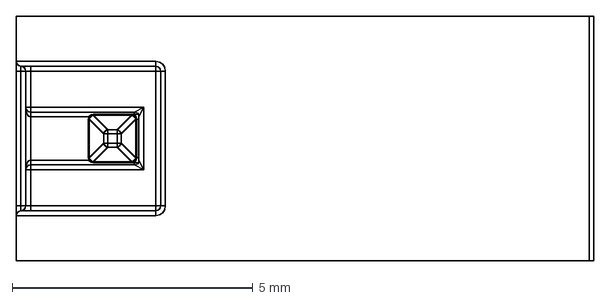
[picture p150: CAD file, 2024-09-17]
3D/Connector/KF2EDG/KF-5.08/1P.DXF
12.0 x 5.08 mm
