nguyentrungthao/KicadLibrary/3D/Connector/pin-headers-dual-rows-1.snapshot.2/Pin Header 2x10 TH Pitch 2.54mm.stp

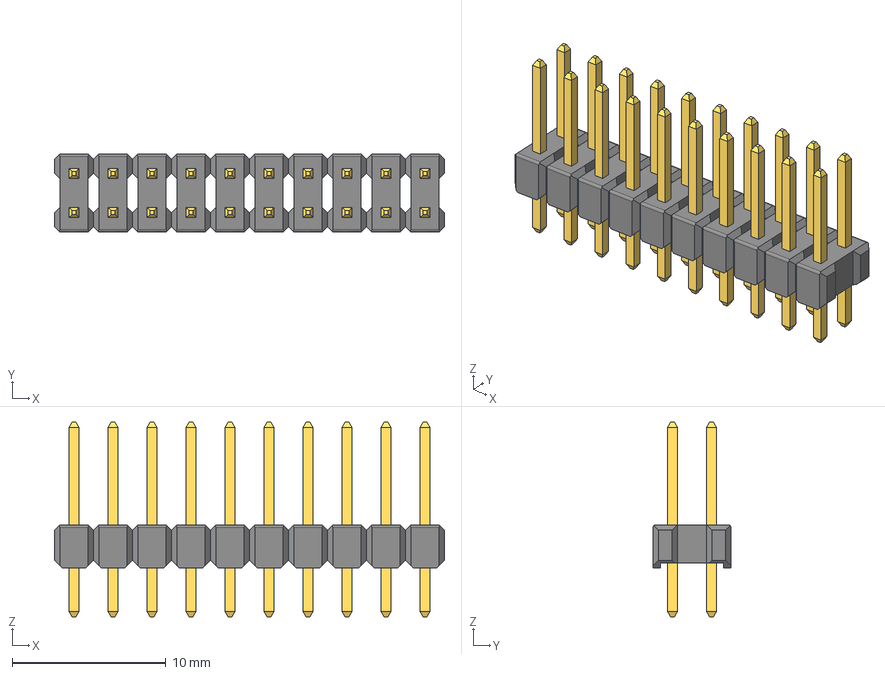
[picture p152: CAD file, 2024-09-17]
3D/Connector/pin-headers-dual-rows-1.snapshot.2/Pin Header 2x10 TH Pitch 2.54mm.stp
25.4 x 5.08 x 12.7 mm
