nguyentrungthao/KicadLibrary/3D/Connector/QHPPC-2.5mm_Magsafe Connector Pair/QHPPC-2.5mm_Magsafe Connector Pair.STEP

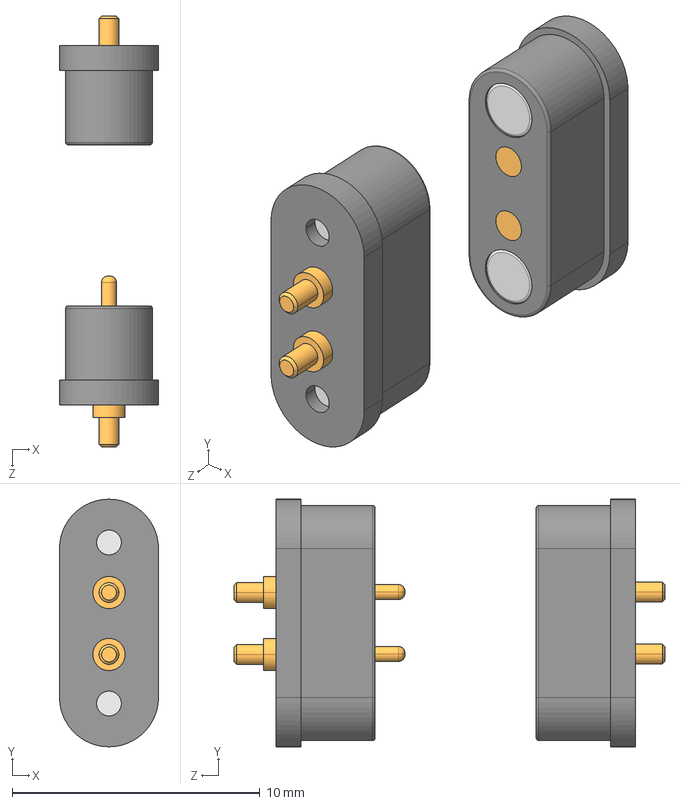
[picture p153: CAD file, 2024-09-17]
3D/Connector/QHPPC-2.5mm_Magsafe Connector Pair/QHPPC-2.5mm_Magsafe Connector Pair.STEP
4.00 x 10.0 x 17.4 mm
