nguyentrungthao/KicadLibrary/3D/Connector/RJ11/TJ6P4C/TJ6P4C.stp

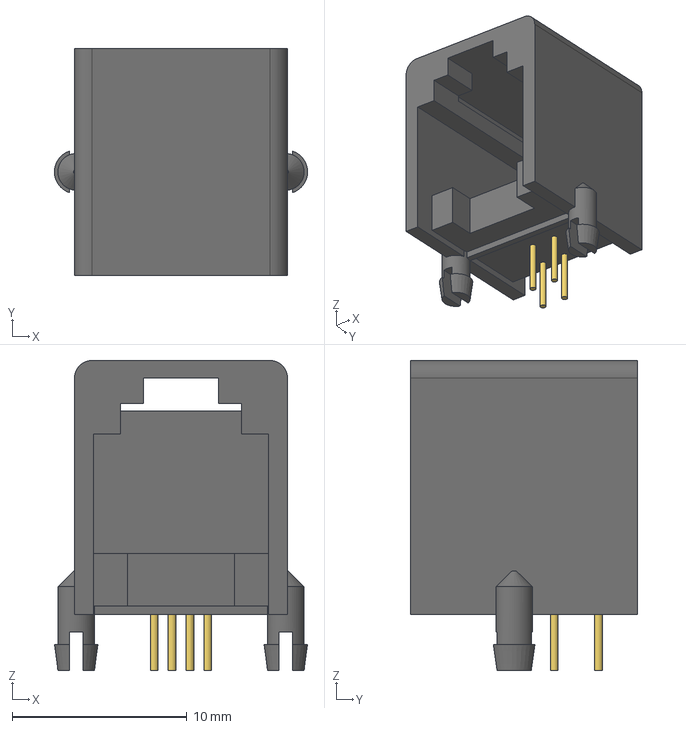
[picture p154: CAD file, 2024-09-17]
3D/Connector/RJ11/TJ6P4C/TJ6P4C.stp
14.5 x 13.0 x 17.8 mm
