nguyentrungthao/KicadLibrary/3D/Connector/RJ45/User Library-HR911105A.STEP

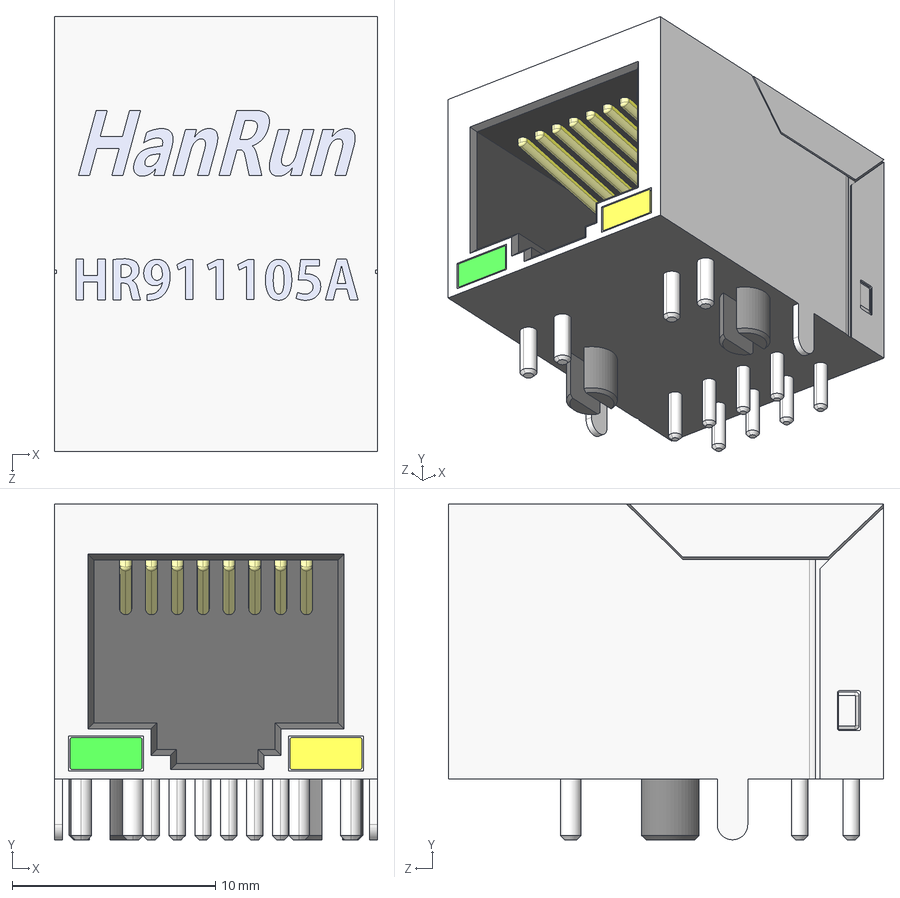
[picture p155: CAD file, 2024-09-17]
3D/Connector/RJ45/User Library-HR911105A.STEP
15.9 x 16.5 x 21.4 mm
