nguyentrungthao/KicadLibrary/3D/Connector/S2B-ZR-SM4A-TF.step

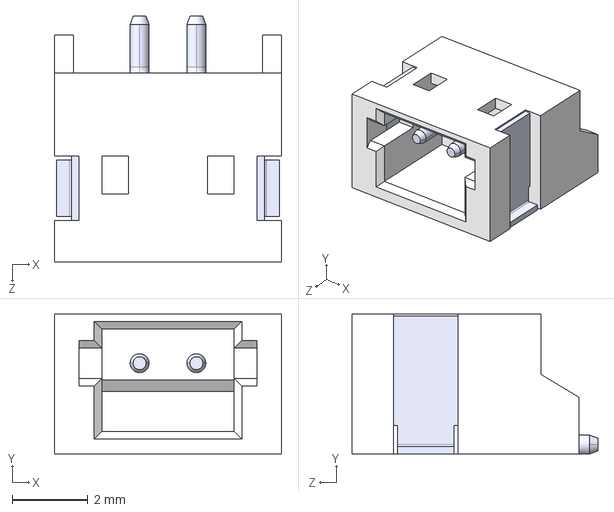
[picture p156: CAD file, 2024-09-17]
3D/Connector/S2B-ZR-SM4A-TF.step
6.00 x 3.70 x 6.50 mm
