nguyentrungthao/KicadLibrary/3D/Connector/ShuntJumpter/Jumper Closed.stp

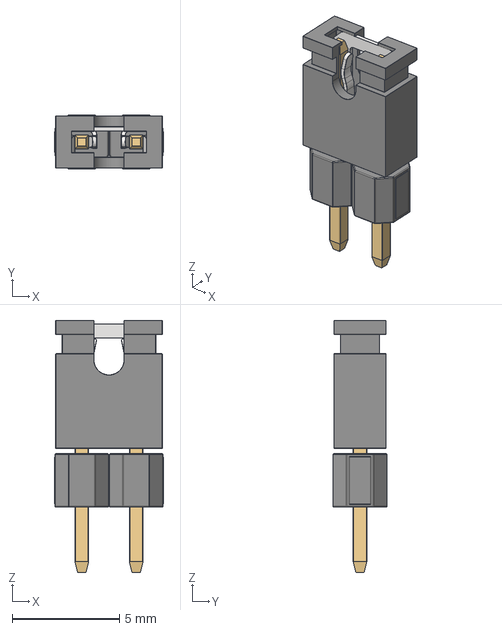
[picture p157: CAD file, 2024-09-17]
3D/Connector/ShuntJumpter/Jumper Closed.stp
5.08 x 2.54 x 11.8 mm
