nguyentrungthao/KicadLibrary/3D/Connector/Sim_card_holder/ATTEND_115A-ADA0-R02.STEP

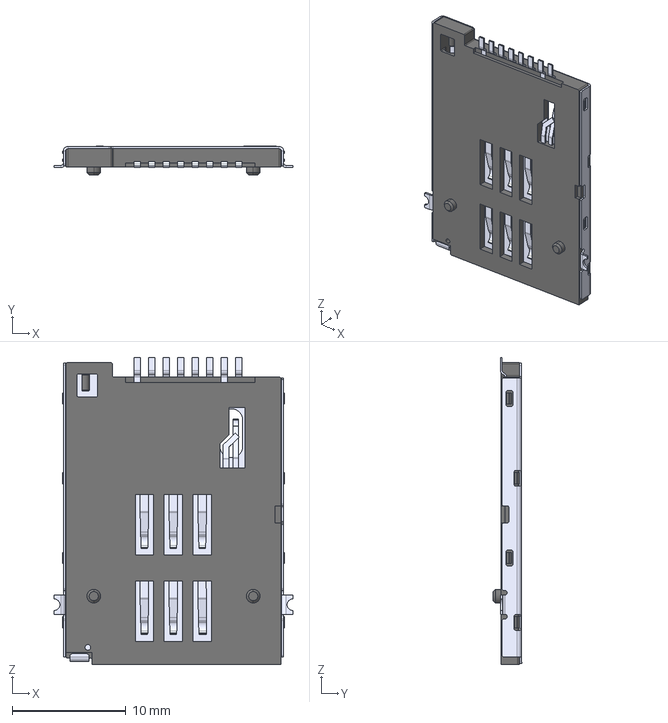
[picture p158: CAD file, 2024-09-17]
3D/Connector/Sim_card_holder/ATTEND_115A-ADA0-R02.STEP
20.9 x 2.54 x 26.9 mm
