nguyentrungthao/KicadLibrary/3D/Connector/SIMCardHolder/NanoSIM/SIM8060/User Library-SIM8060.STEP

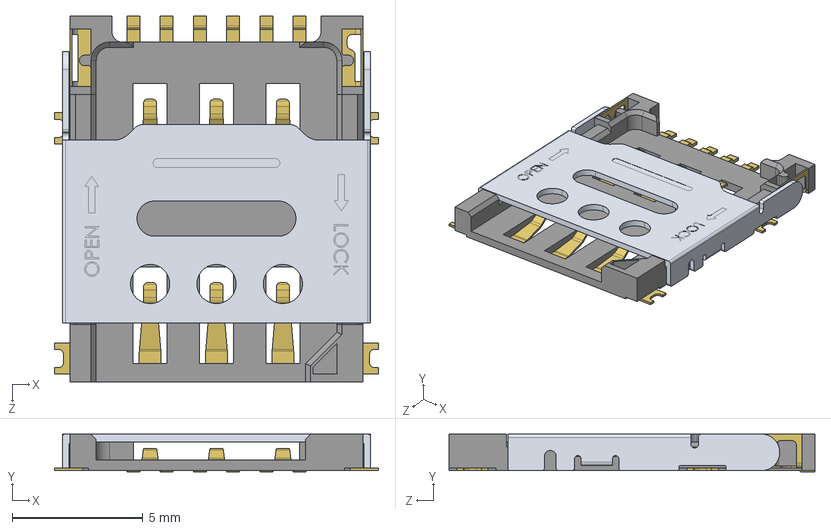
[picture p159: CAD file, 2024-09-17]
3D/Connector/SIMCardHolder/NanoSIM/SIM8060/User Library-SIM8060.STEP
12.4 x 1.45 x 14.0 mm
