nguyentrungthao/KicadLibrary/3D/Connector/SIMCardHolder/NanoSIM/User Library-NANO SIM-1/User Library-NANO SIM-1.STEP

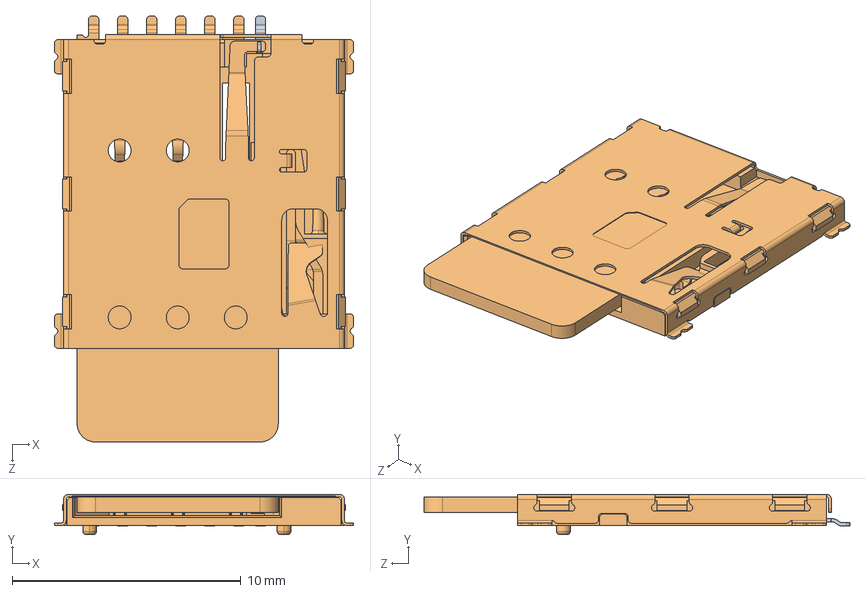
[picture p160: CAD file, 2024-09-17]
3D/Connector/SIMCardHolder/NanoSIM/User Library-NANO SIM-1/User Library-NANO SIM-1.STEP
13.1 x 1.77 x 18.6 mm
