nguyentrungthao/KicadLibrary/3D/Connector/TerminalBlock/borne-5-08mm-duplo-nivel-1.snapshot.2/borne br12 deslocado à direita.STEP

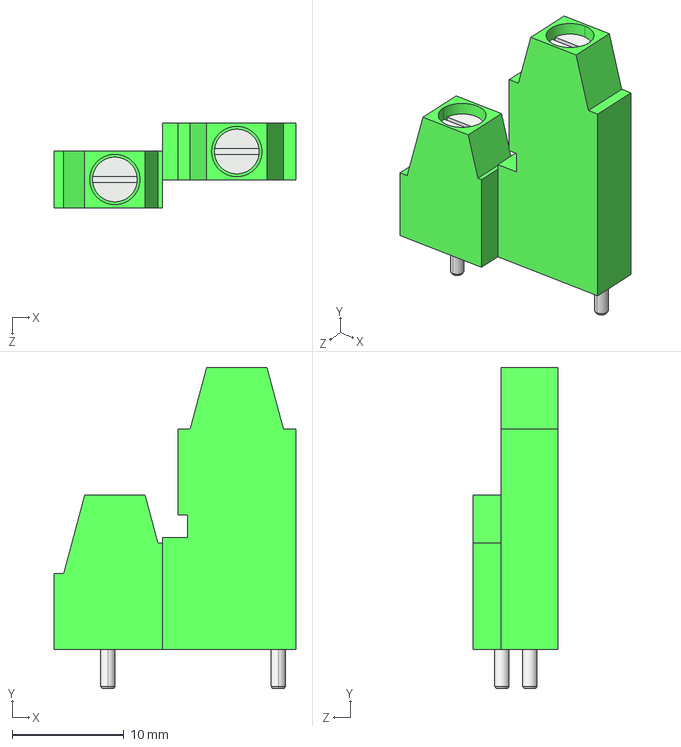
[picture p162: CAD file, 2024-09-17]
3D/Connector/TerminalBlock/borne-5-08mm-duplo-nivel-1.snapshot.2/borne br12 deslocado à direita.STEP
21.6 x 28.7 x 7.58 mm
