nguyentrungthao/KicadLibrary/3D/Connector/TerminalBlock/HB9500/HB9500_01x10_P9.50mm.step

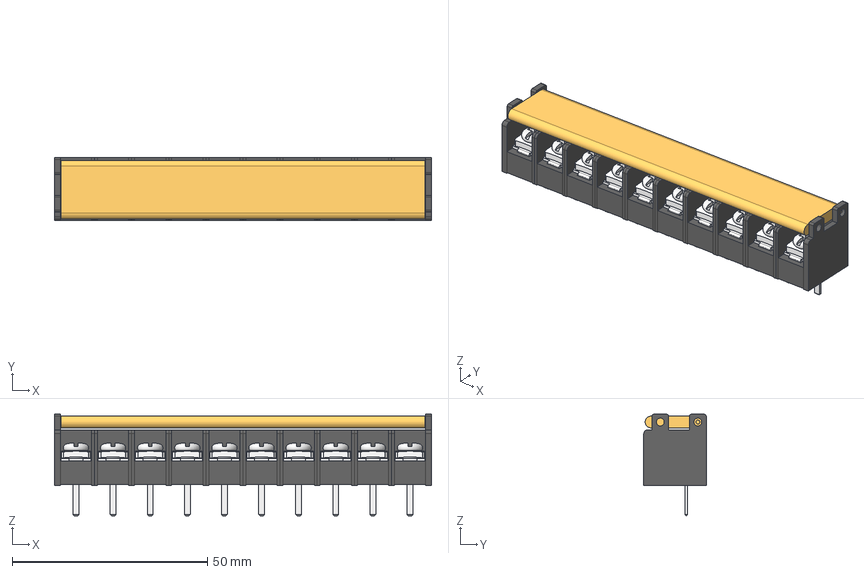
[picture p163: CAD file, 2024-09-17]
3D/Connector/TerminalBlock/HB9500/HB9500_01x10_P9.50mm.step
96.5 x 16.0 x 26.0 mm
BodyLeft
BodyRight
Cover
LCS_Origin x 8
BodyCenter x 8
LCS_BodyCenter x 8
