nguyentrungthao/KicadLibrary/3D/Connector/TerminalBlock/TE 1776244/3P Blue/Terminal_3pin.STEP

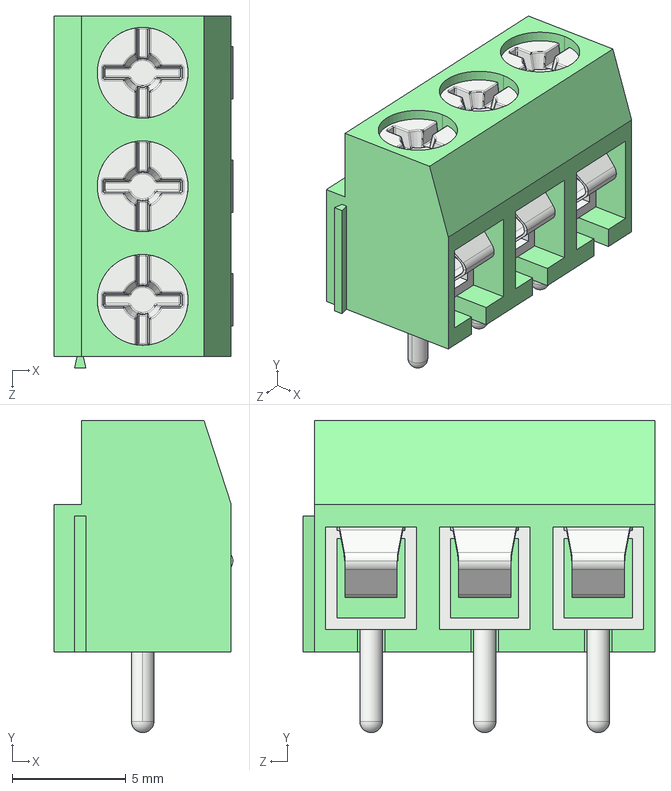
[picture p164: CAD file, 2024-09-17]
3D/Connector/TerminalBlock/TE 1776244/3P Blue/Terminal_3pin.STEP
7.87 x 13.8 x 15.5 mm
Outter
Screw x 3
Inner x 3
