nguyentrungthao/KicadLibrary/3D/Connector/TerminalBlock/WURTH_691216510002/WURTH_691216510002.STEP

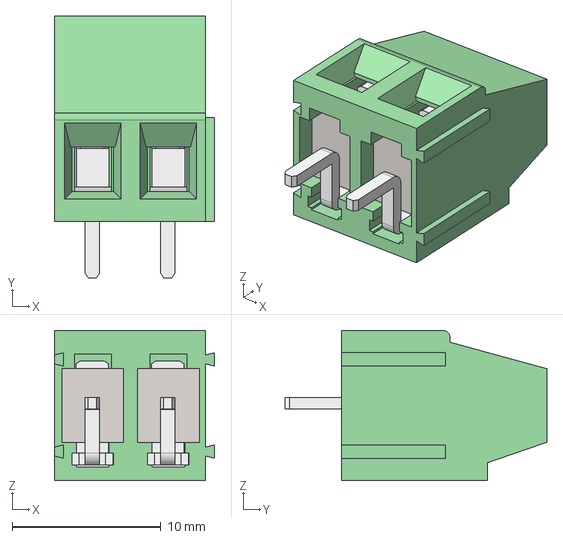
[picture p165: CAD file, 2024-09-17]
3D/Connector/TerminalBlock/WURTH_691216510002/WURTH_691216510002.STEP
10.8 x 17.6 x 10.1 mm
