nguyentrungthao/KicadLibrary/3D/Connector/USB-C_12pin_SMD/USB Type C Port (SMD Type).STEP

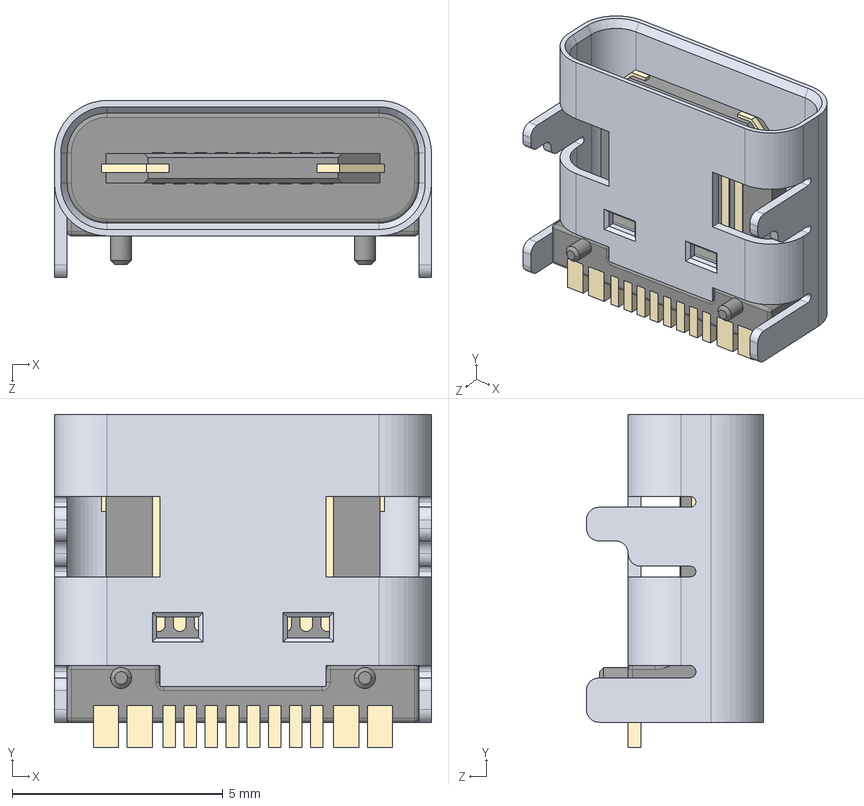
[picture p167: CAD file, 2024-09-17]
3D/Connector/USB-C_12pin_SMD/USB Type C Port (SMD Type).STEP
8.94 x 7.90 x 4.20 mm
