nguyentrungthao/KicadLibrary/3D/Connector/USB/MicroUSB/XKB Connectivity U254-051N-4BH806.step

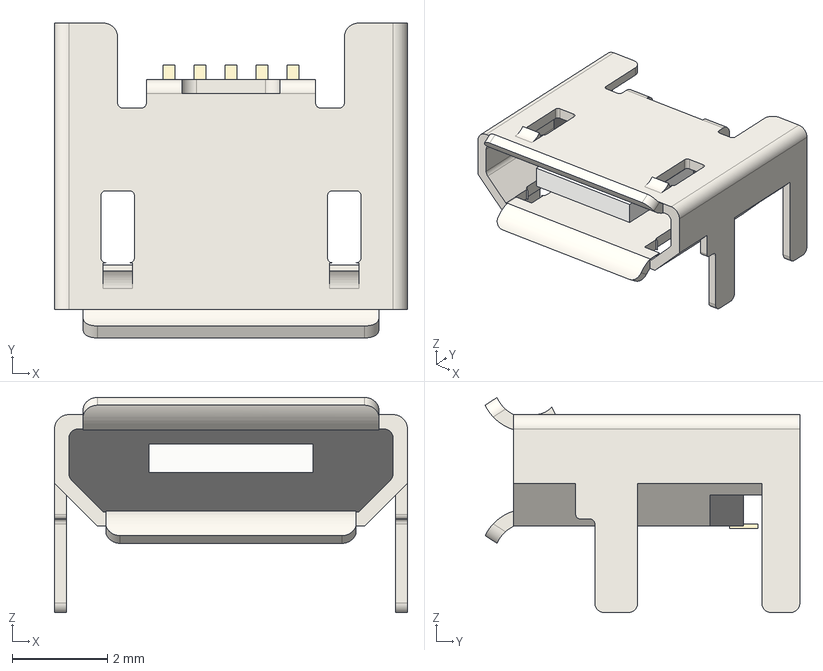
[picture p168: CAD file, 2024-09-17]
3D/Connector/USB/MicroUSB/XKB Connectivity U254-051N-4BH806.step
7.40 x 6.60 x 4.51 mm
