nguyentrungthao/KicadLibrary/3D/Connector/USB/USB_typeA/Dual_Female/usb double.STEP

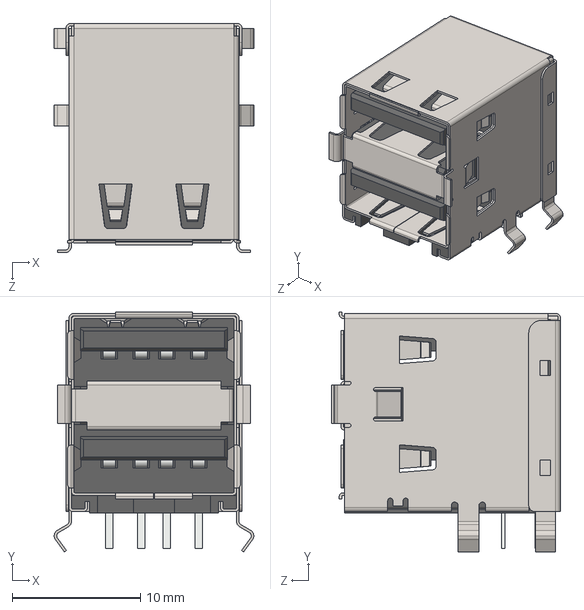
[picture p169: CAD file, 2024-09-17]
3D/Connector/USB/USB_typeA/Dual_Female/usb double.STEP
15.6 x 18.7 x 17.9 mm
