nguyentrungthao/KicadLibrary/3D/Connector/USB/USB_typeA/USB-A 111 (vertical on plate).STEP

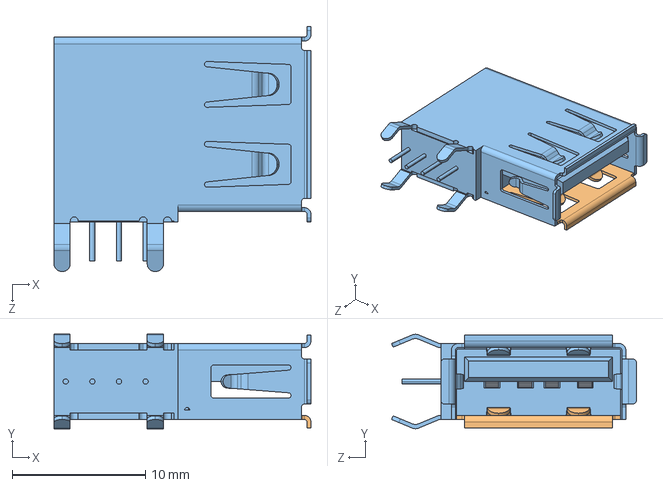
[picture p171: CAD file, 2024-09-17]
3D/Connector/USB/USB_typeA/USB-A 111 (vertical on plate).STEP
19.3 x 7.10 x 18.4 mm
