nguyentrungthao/KicadLibrary/3D/Connector/XH_2.54/SMD Horizontal/JST - XH - SMD (R) - 19Pin - 2.54mm.stp

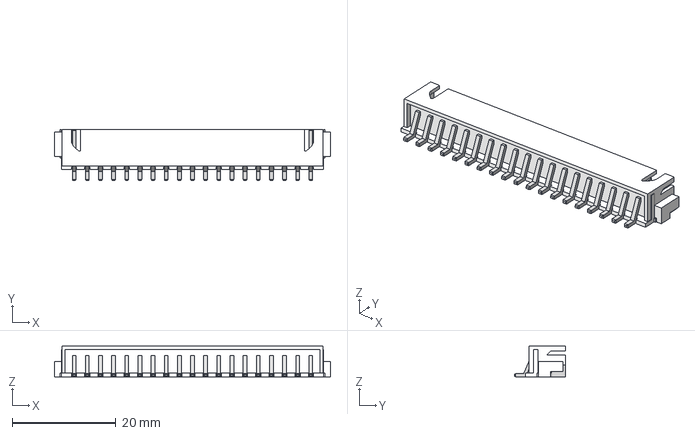
[picture p173: CAD file, 2024-09-17]
3D/Connector/XH_2.54/SMD Horizontal/JST - XH - SMD (R) - 19Pin - 2.54mm.stp
53.3 x 9.91 x 5.92 mm
