nguyentrungthao/KicadLibrary/3D/Connector/XH_2.54/Thru Horizontal/JST - XH - Thru (R) - 16Pin - 2.54mm.stp

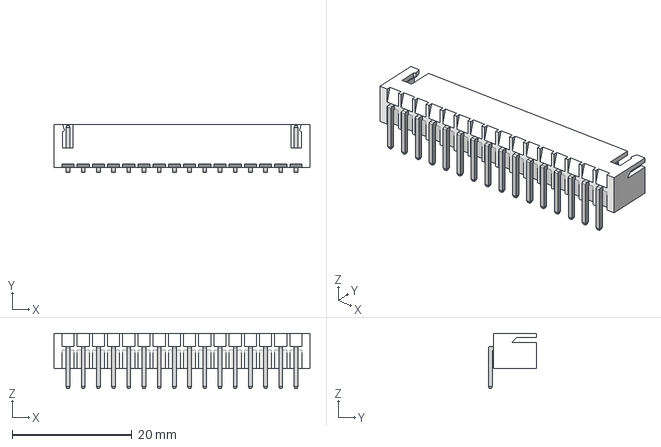
[picture p174: CAD file, 2024-09-17]
3D/Connector/XH_2.54/Thru Horizontal/JST - XH - Thru (R) - 16Pin - 2.54mm.stp
42.8 x 8.04 x 9.22 mm
