nguyentrungthao/KicadLibrary/3D/Connector/XH_2.54/Thru Vertical/JST - XH - Thru (V) - 8Pin - 2.54mm.stp

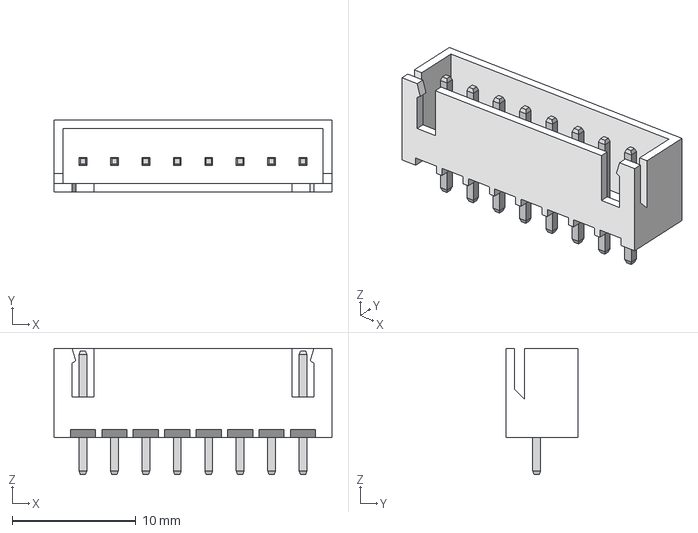
[picture p175: CAD file, 2024-09-17]
3D/Connector/XH_2.54/Thru Vertical/JST - XH - Thru (V) - 8Pin - 2.54mm.stp
22.5 x 5.84 x 10.2 mm
