nguyentrungthao/KicadLibrary/3D/Crystal/CrystalOscillator2016_4P_SMD/QFN_2016_4pins.STEP

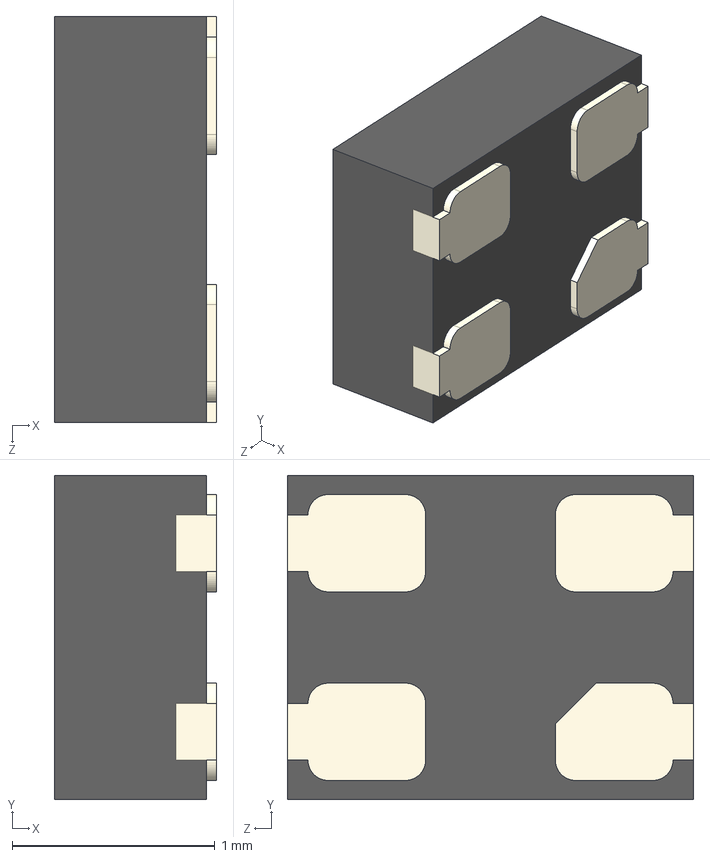
[picture p176: CAD file, 2024-09-17]
3D/Crystal/CrystalOscillator2016_4P_SMD/QFN_2016_4pins.STEP
0.8 x 1.60 x 2.00 mm
