nguyentrungthao/KicadLibrary/3D/Crystal/SMD/Crystal_SMD_3225-4Pin_5.0x3.2mm/OSC3225.STEP

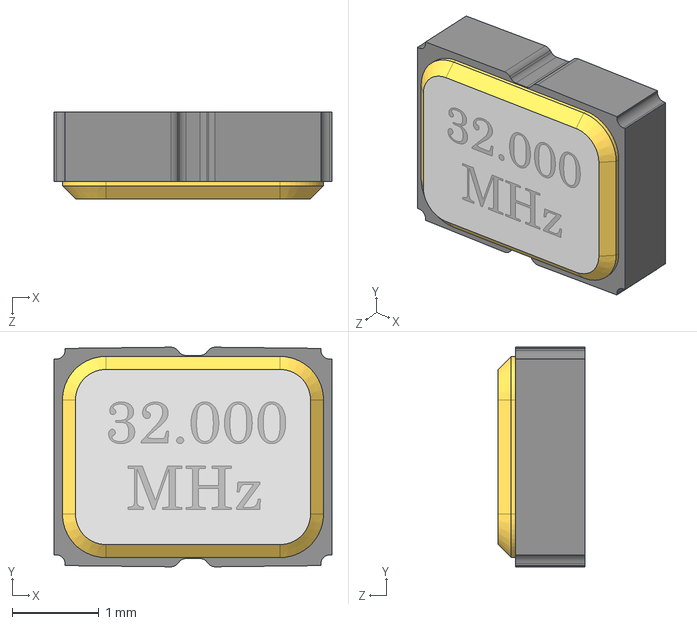
[picture p177: CAD file, 2024-09-17]
3D/Crystal/SMD/Crystal_SMD_3225-4Pin_5.0x3.2mm/OSC3225.STEP
3.20 x 2.53 x 1.00 mm
