nguyentrungthao/KicadLibrary/3D/Crystal/SMD/Crystal_SMD_5032-4Pin_5.0x3.2mm/OSC5032.STEP

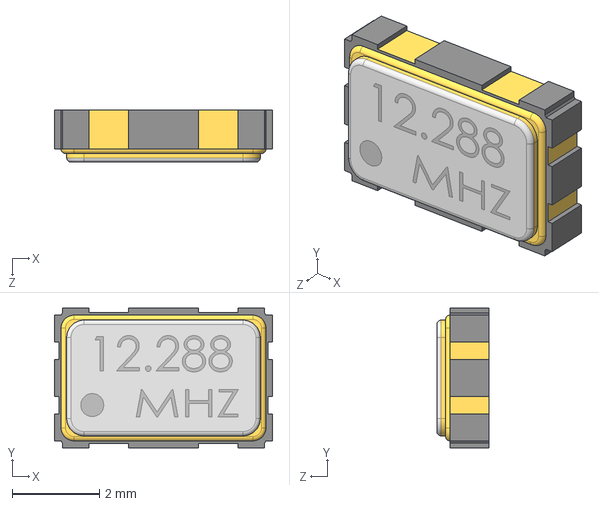
[picture p178: CAD file, 2024-09-17]
3D/Crystal/SMD/Crystal_SMD_5032-4Pin_5.0x3.2mm/OSC5032.STEP
5.00 x 3.20 x 1.20 mm
