nguyentrungthao/KicadLibrary/3D/Crystal/SMD/MC-146/Crystal_SMD_SeikoEpson_MC146-4Pin_6.7x1.5mm.step

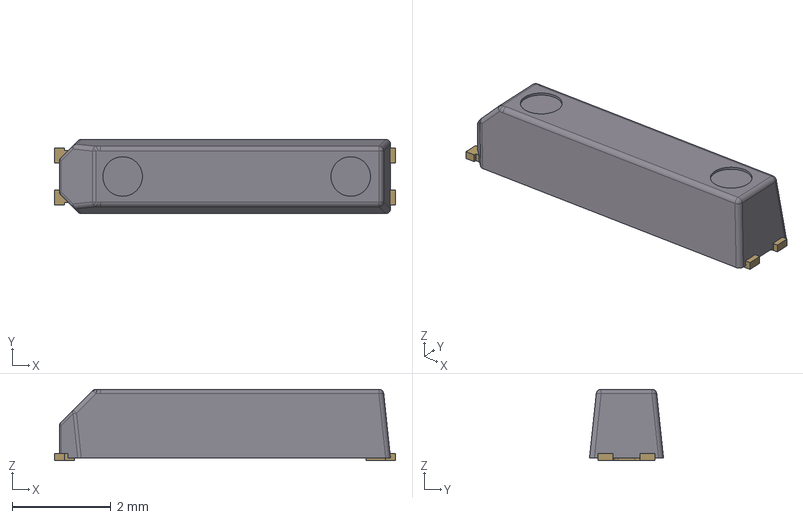
[picture p179: CAD file, 2024-09-17]
3D/Crystal/SMD/MC-146/Crystal_SMD_SeikoEpson_MC146-4Pin_6.7x1.5mm.step
6.90 x 1.50 x 1.45 mm
