nguyentrungthao/KicadLibrary/3D/Crystal/SMD/MC306-ABS25-32.768KHZ/MC306-ABS25-32.768KHZ.STEP

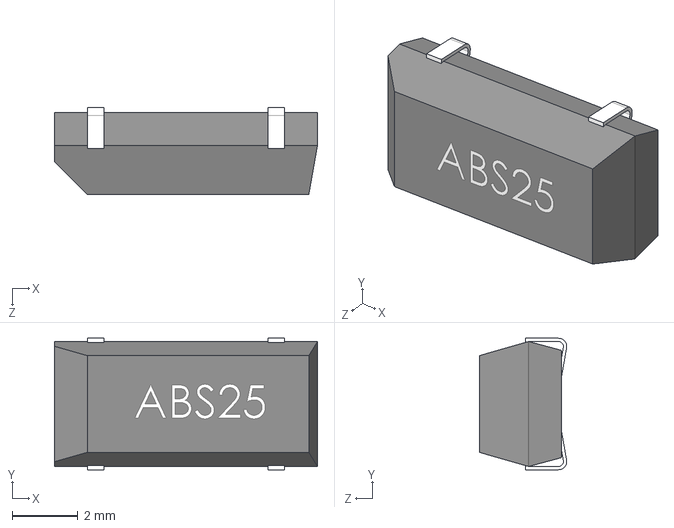
[picture p180: CAD file, 2024-09-17]
3D/Crystal/SMD/MC306-ABS25-32.768KHZ/MC306-ABS25-32.768KHZ.STEP
8.00 x 4.00 x 2.66 mm
