nguyentrungthao/KicadLibrary/3D/Diode/Bridge/MB10E/MB10F-13.step

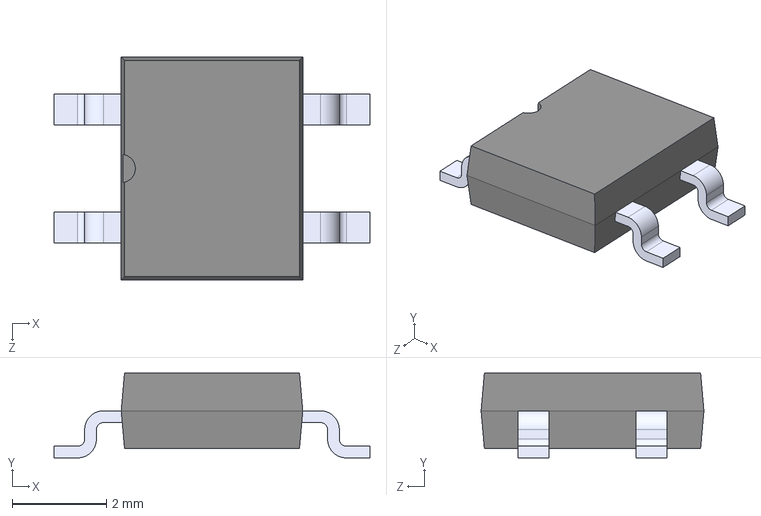
[picture p181: CAD file, 2024-09-17]
3D/Diode/Bridge/MB10E/MB10F-13.step
6.70 x 1.80 x 4.72 mm
