nguyentrungthao/KicadLibrary/3D/Diode/LED/7Segment/3 digit 7seg 38x19.step

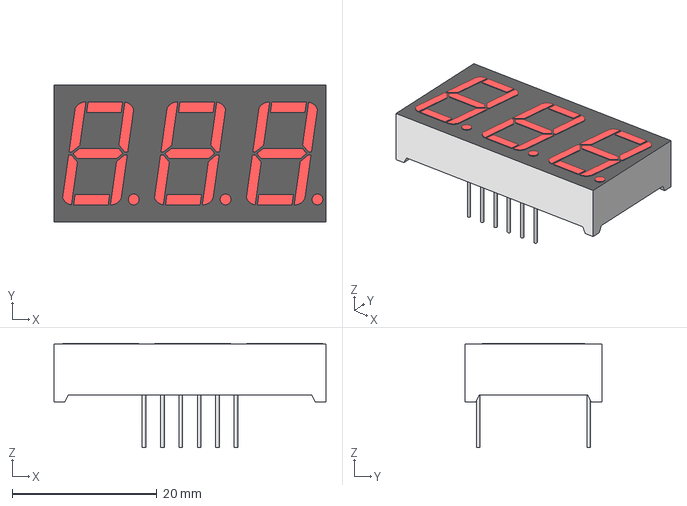
[picture p182: CAD file, 2024-09-17]
3D/Diode/LED/7Segment/3 digit 7seg 38x19.step
37.6 x 19.0 x 14.4 mm
