nguyentrungthao/KicadLibrary/3D/Diode/LED/DIP/5mm/LED 5mm Red.step

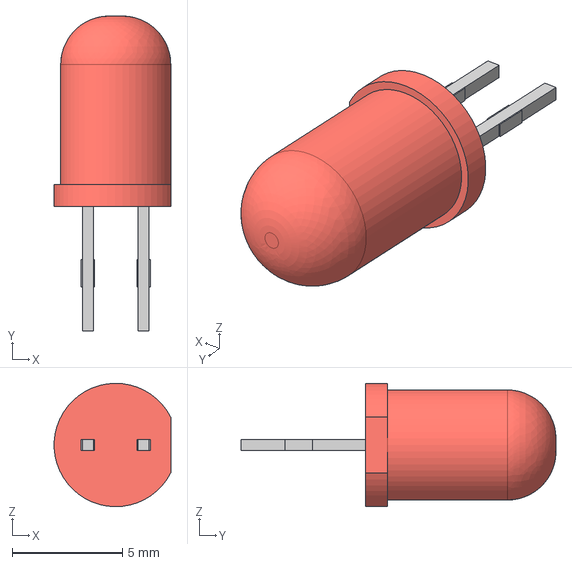
[picture p183: CAD file, 2024-09-17]
3D/Diode/LED/DIP/5mm/LED 5mm Red.step
5.29 x 14.3 x 5.60 mm
