nguyentrungthao/KicadLibrary/3D/Diode/LED/ITR9909.step

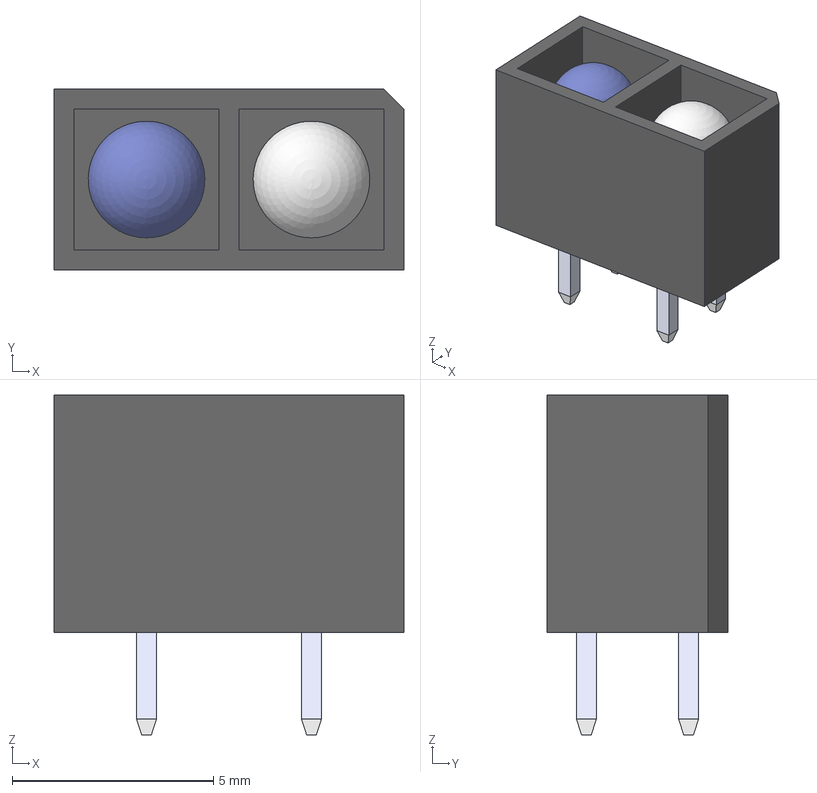
[picture p184: CAD file, 2024-09-17]
3D/Diode/LED/ITR9909.step
8.70 x 4.50 x 8.45 mm
Phototransistor
Infrared LED
