nguyentrungthao/KicadLibrary/3D/Diode/LED/LED/0603 Red.step

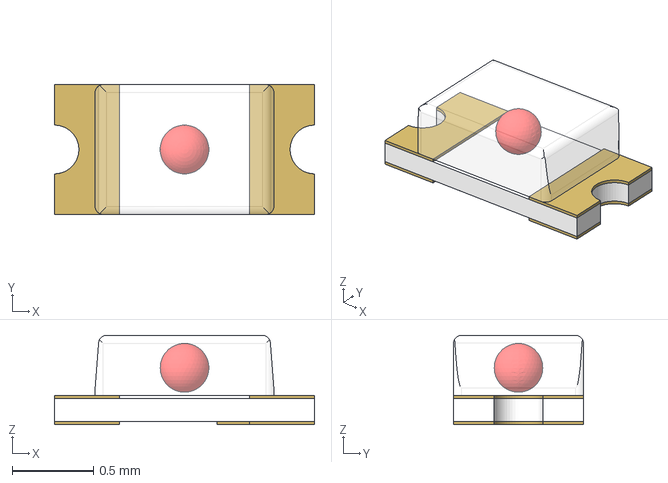
[picture p185: CAD file, 2024-09-17]
3D/Diode/LED/LED/0603 Red.step
1.60 x 0.8 x 0.55 mm
