nguyentrungthao/KicadLibrary/3D/Diode/LED/Led_3mm_DIP/LED 3mm Yellow.step

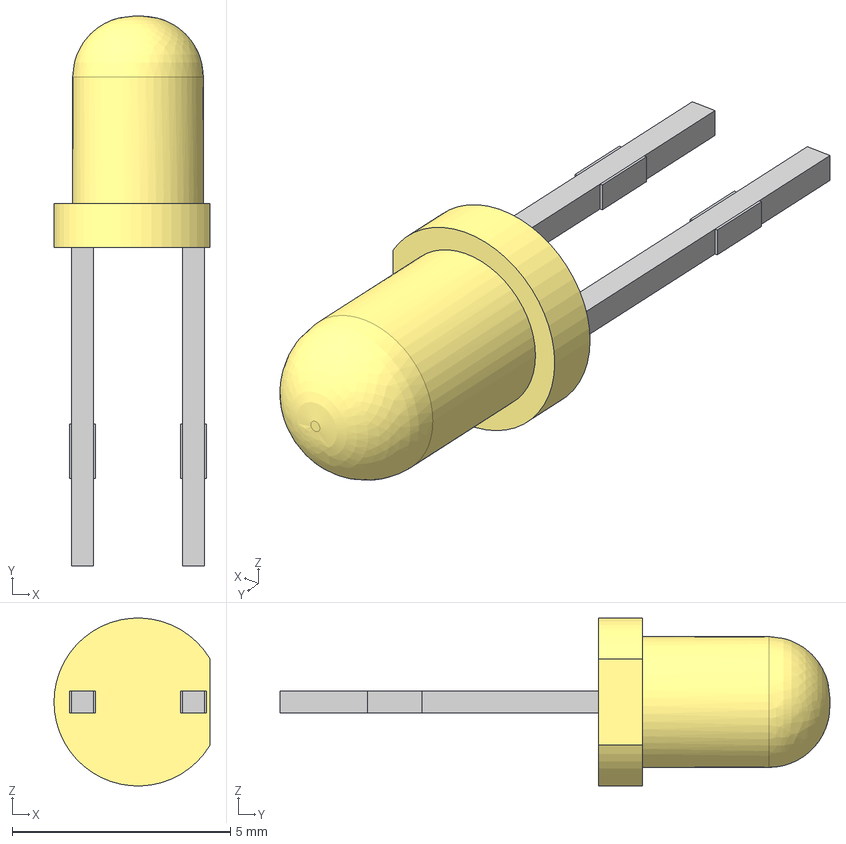
[picture p186: CAD file, 2024-09-17]
3D/Diode/LED/Led_3mm_DIP/LED 3mm Yellow.step
3.58 x 12.6 x 3.85 mm
