nguyentrungthao/KicadLibrary/3D/Diode/LED/LED_Housing/LED 3mm red housing.stp

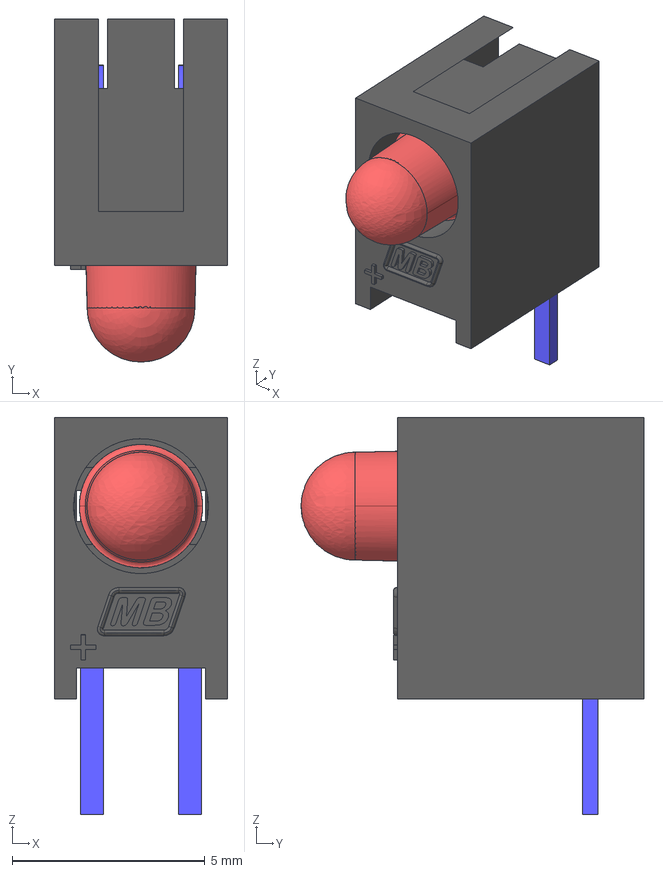
[picture p187: CAD file, 2024-09-17]
3D/Diode/LED/LED_Housing/LED 3mm red housing.stp
4.50 x 8.90 x 10.3 mm
