nguyentrungthao/KicadLibrary/3D/Diode/LED/QBLP680-RGB1/QBLP680-RGB1.step

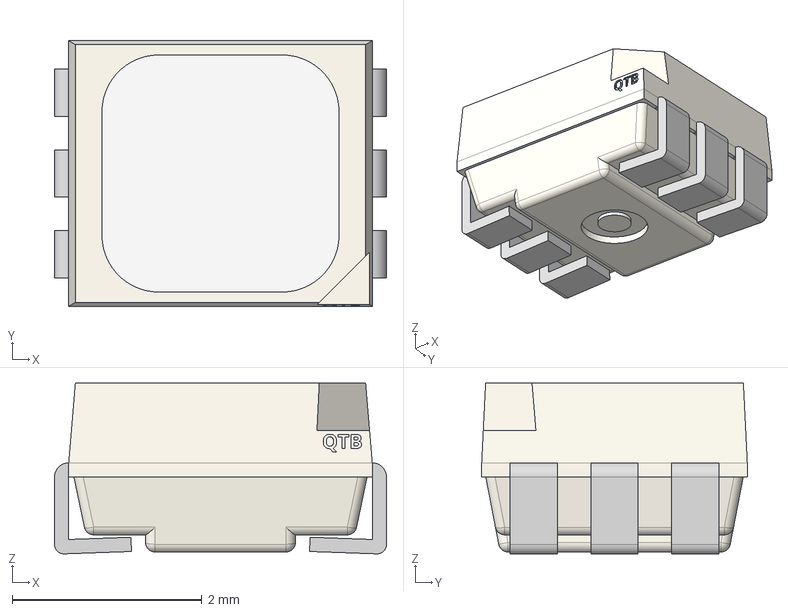
[picture p188: CAD file, 2024-09-17]
3D/Diode/LED/QBLP680-RGB1/QBLP680-RGB1.step
3.50 x 2.80 x 1.80 mm
