nguyentrungthao/KicadLibrary/3D/Diode/SMA/SMA (DO-214AC).STEP

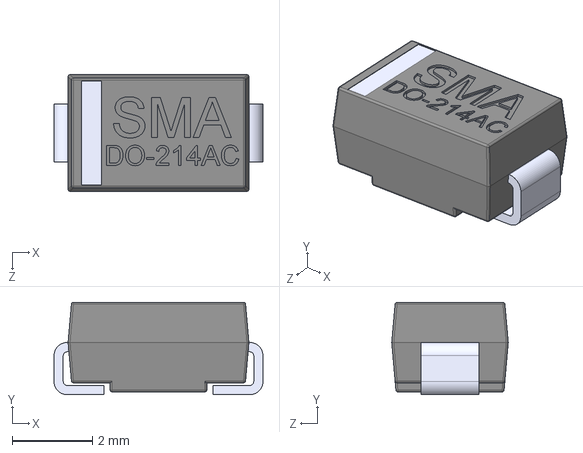
[picture p189: CAD file, 2024-09-17]
3D/Diode/SMA/SMA (DO-214AC).STEP
5.20 x 2.30 x 2.90 mm
