nguyentrungthao/KicadLibrary/3D/Diode/SOD-128/SOD-128.step

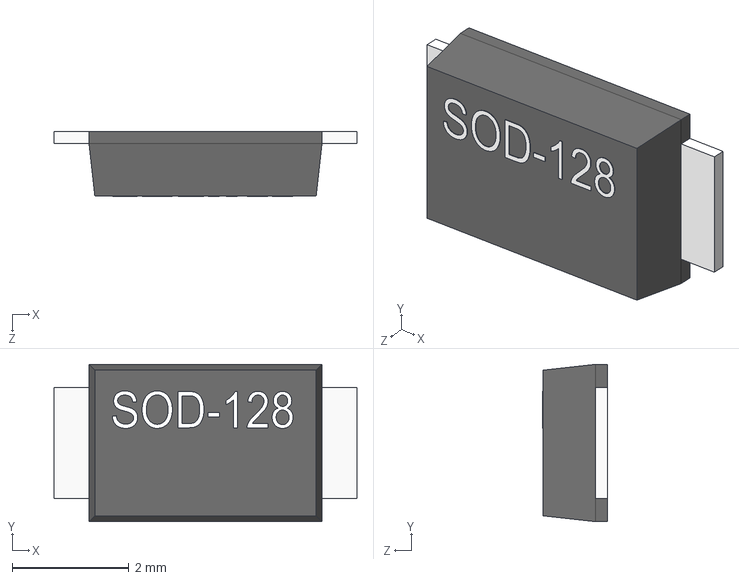
[picture p190: CAD file, 2024-09-17]
3D/Diode/SOD-128/SOD-128.step
5.20 x 2.70 x 1.11 mm
