nguyentrungthao/KicadLibrary/3D/Diode/SOD123/SOD123.step

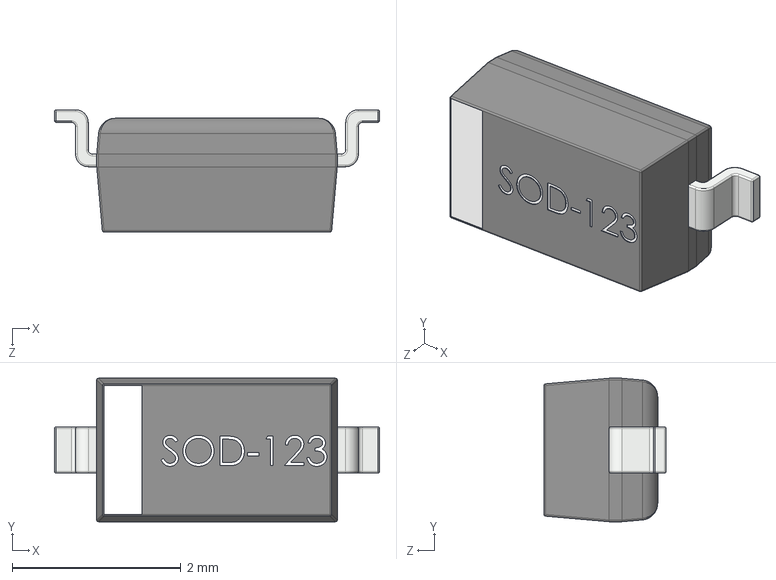
[picture p191: CAD file, 2024-09-17]
3D/Diode/SOD123/SOD123.step
3.85 x 1.70 x 1.45 mm
