nguyentrungthao/KicadLibrary/3D/Diode/SOD123F/SOD-123F.step

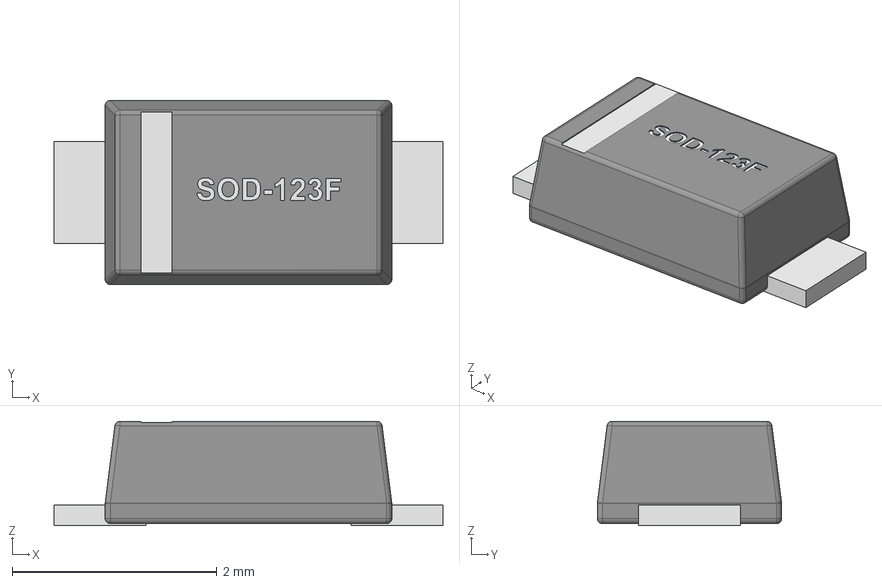
[picture p192: CAD file, 2024-09-17]
3D/Diode/SOD123F/SOD-123F.step
3.80 x 1.80 x 1.02 mm
