nguyentrungthao/KicadLibrary/3D/Diode/SOD323/SOD323.step

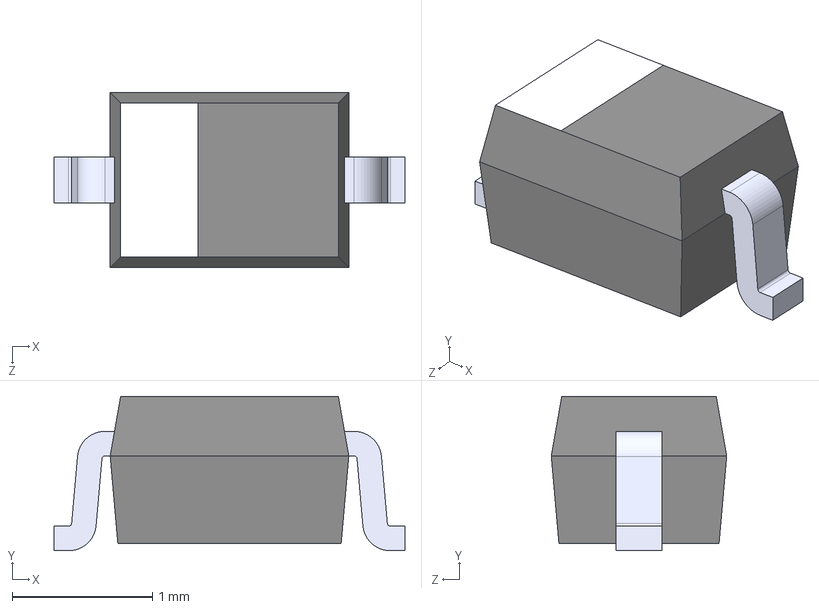
[picture p193: CAD file, 2024-09-17]
3D/Diode/SOD323/SOD323.step
2.50 x 1.10 x 1.25 mm
