nguyentrungthao/KicadLibrary/3D/Diode/THT/1N4007-T.STEP

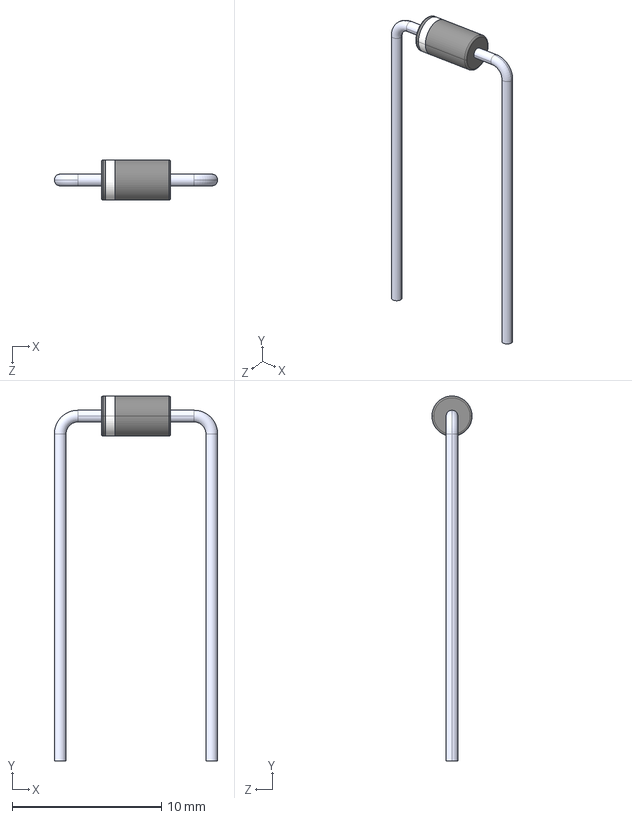
[picture p194: CAD file, 2024-09-17]
3D/Diode/THT/1N4007-T.STEP
10.9 x 24.5 x 2.69 mm
