nguyentrungthao/KicadLibrary/3D/Diode/TPD4EUSB30DQAR/TPD4EUSB30DQAR.step

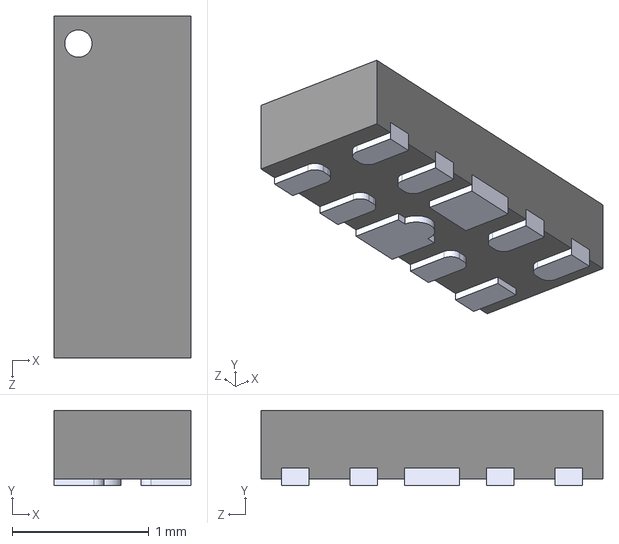
[picture p195: CAD file, 2024-09-17]
3D/Diode/TPD4EUSB30DQAR/TPD4EUSB30DQAR.step
1.00 x 0.55 x 2.50 mm
