nguyentrungthao/KicadLibrary/3D/Driver/L298N.step

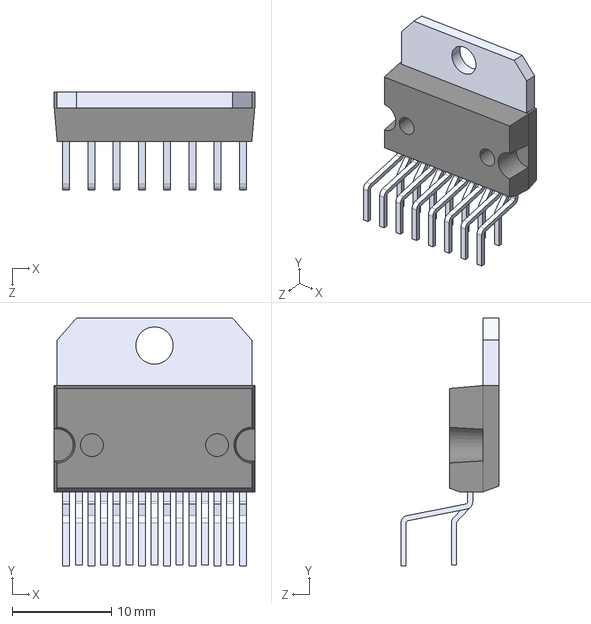
[picture p196: CAD file, 2024-09-17]
3D/Driver/L298N.step
20.2 x 25.0 x 9.89 mm
