nguyentrungthao/KicadLibrary/3D/Encoder/DIP/11mm-metal-shaft-rotary-encoders-tht-vertical-w-push-on-switch/Encoders/EC11-THT-20R-green.step

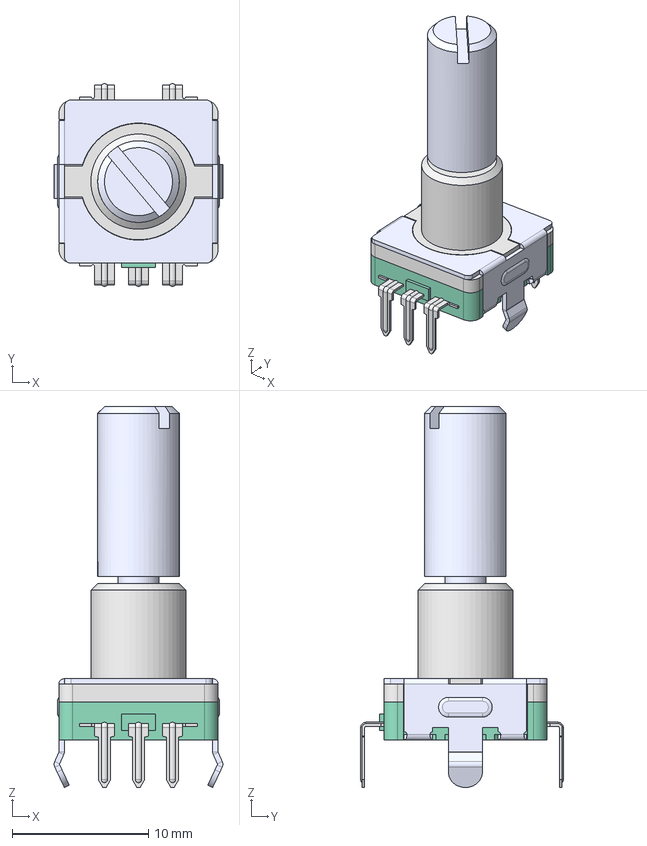
[picture p198: CAD file, 2024-09-17]
3D/Encoder/DIP/11mm-metal-shaft-rotary-encoders-tht-vertical-w-push-on-switch/Encoders/EC11-THT-20R-green.step
12.4 x 14.9 x 28.0 mm
Lb7
20R
EC11-Housing-THT
