nguyentrungthao/KicadLibrary/3D/Encoder/SMD/11mm-metal-shaft-rotary-encoders-smd-vertical-w-push-on-switch-1.snapshot.1/Encoders/EC11-SMD-20R-thread-black.step

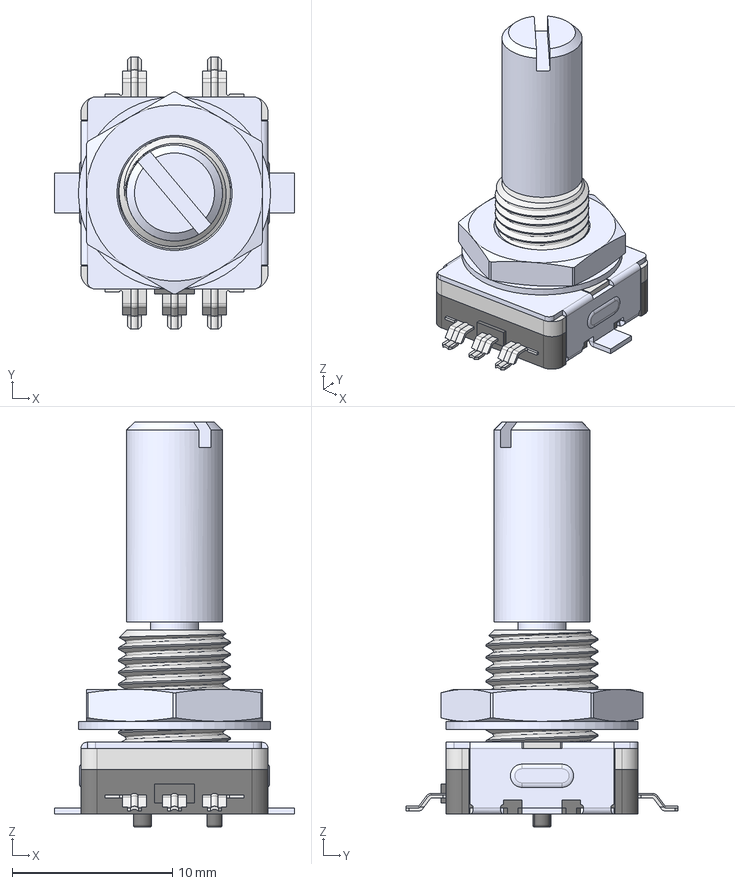
[picture p199: CAD file, 2024-09-17]
3D/Encoder/SMD/11mm-metal-shaft-rotary-encoders-smd-vertical-w-push-on-switch-1.snapshot.1/Encoders/EC11-SMD-20R-thread-black.step
15.0 x 17.0 x 25.3 mm
Lb7 TH
20R
EC11-Housing-SMD
