nguyentrungthao/KicadLibrary/3D/Filter/AC Filter Choke/filtr-ac-pins7x8.STEP

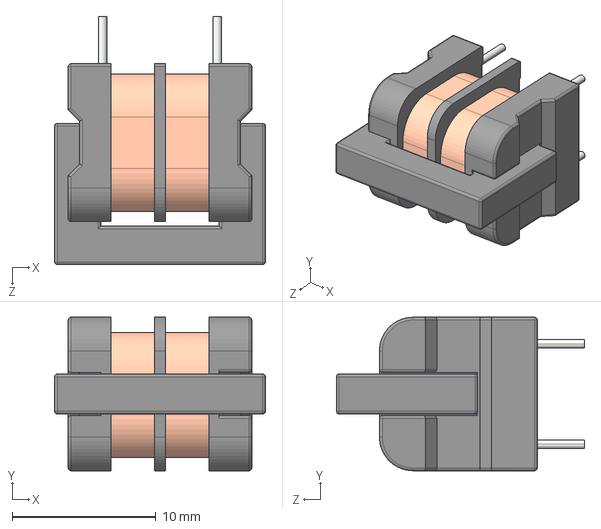
[picture p200: CAD file, 2024-09-17]
3D/Filter/AC Filter Choke/filtr-ac-pins7x8.STEP
14.7 x 10.7 x 17.3 mm
