nguyentrungthao/KicadLibrary/3D/Filter/Gas Discharge Tubes/User Library-SH_Series.STEP

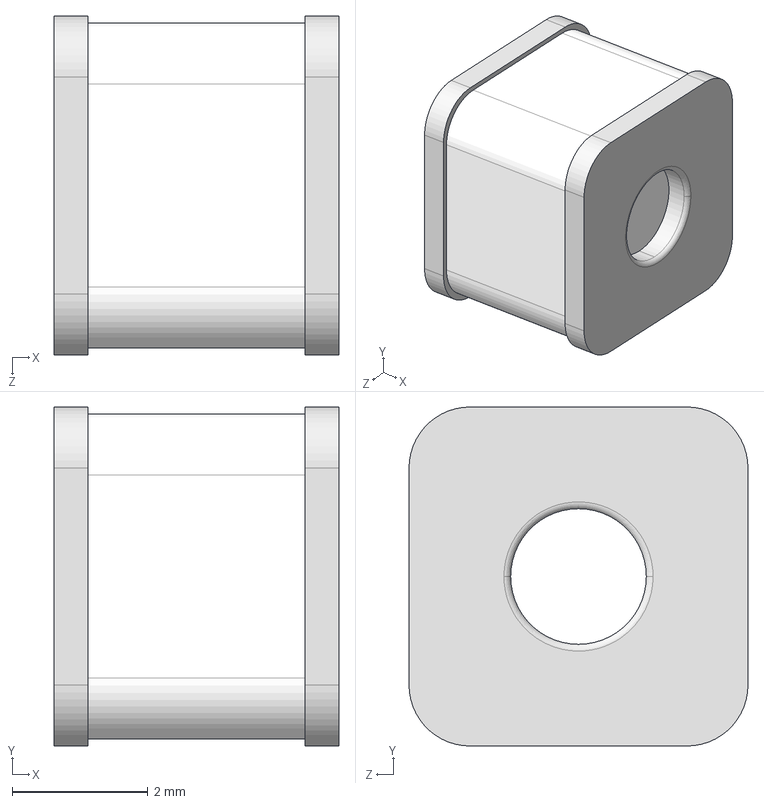
[picture p201: CAD file, 2024-09-17]
3D/Filter/Gas Discharge Tubes/User Library-SH_Series.STEP
4.20 x 5.00 x 5.00 mm
