nguyentrungthao/KicadLibrary/3D/Fuses/FuseHolderGlass5x20mm/Fuse_BLX-A22mm.STEP

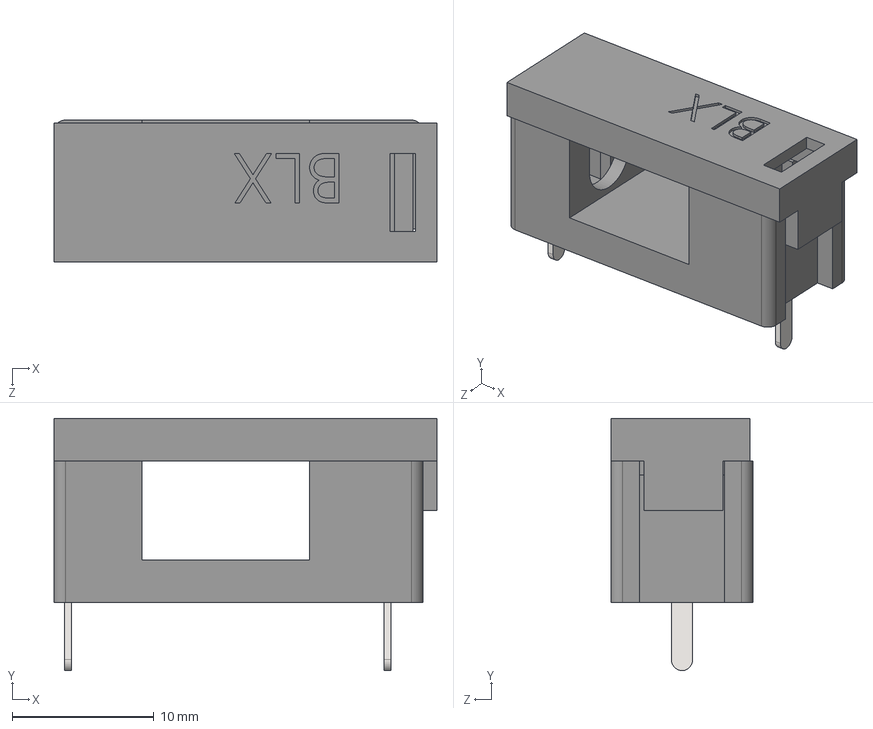
[picture p202: CAD file, 2024-09-17]
3D/Fuses/FuseHolderGlass5x20mm/Fuse_BLX-A22mm.STEP
27.0 x 17.8 x 10.0 mm
