nguyentrungthao/KicadLibrary/3D/Fuses/FuseSMD/litteFuse/Littelfuse 0154.500DRT v5.step

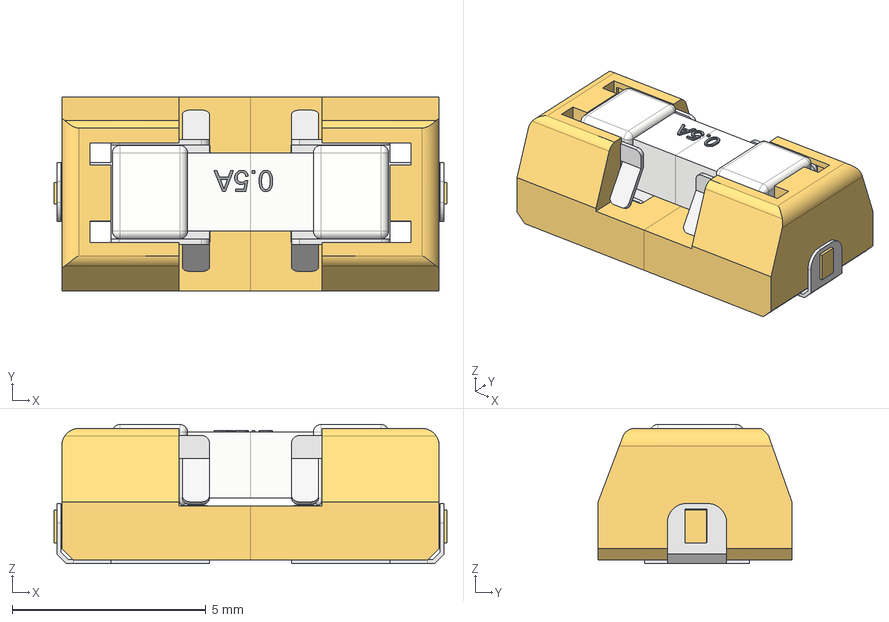
[picture p203: CAD file, 2024-09-17]
3D/Fuses/FuseSMD/litteFuse/Littelfuse 0154.500DRT v5.step
10.1 x 5.00 x 3.59 mm
Komponente1
Komponente2
Komponente3
Komponente4
