nguyentrungthao/KicadLibrary/3D/Fuses/FuseSMD/Resettable Fuse/0603/fuse_silicon_0603L.step

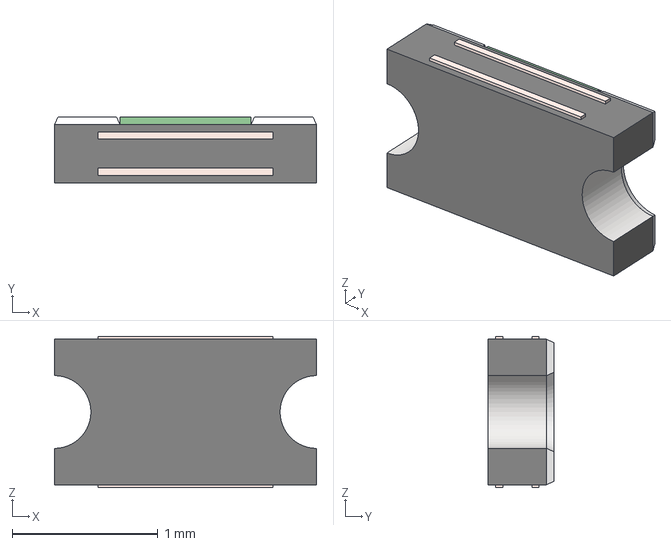
[picture p204: CAD file, 2024-09-17]
3D/Fuses/FuseSMD/Resettable Fuse/0603/fuse_silicon_0603L.step
1.80 x 0.45 x 1.04 mm
