nguyentrungthao/KicadLibrary/3D/Fuses/FuseSMD/Resettable Fuse/1206/Bourns SF Fuse/SF-1206SA2000R-2.stp

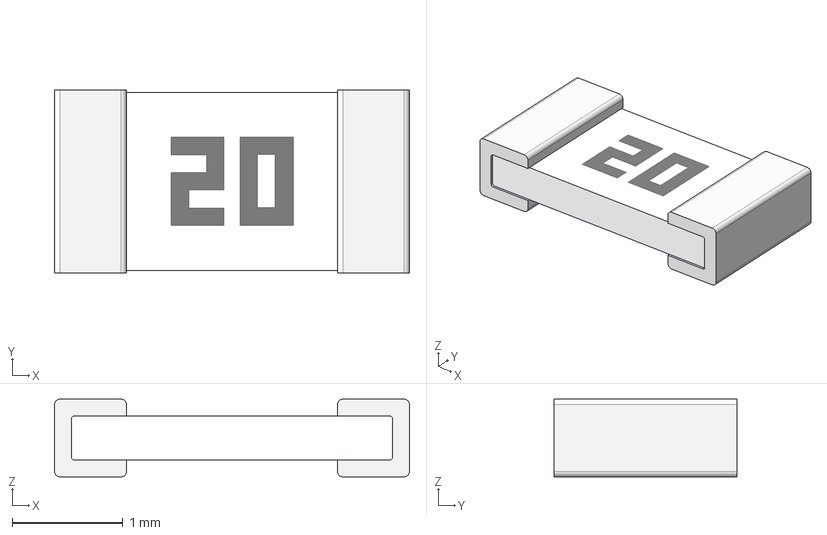
[picture p205: CAD file, 2024-09-17]
3D/Fuses/FuseSMD/Resettable Fuse/1206/Bourns SF Fuse/SF-1206SA2000R-2.stp
3.20 x 1.65 x 0.7 mm
