nguyentrungthao/KicadLibrary/3D/Fuses/FuseSMD/Resettable Fuse/1206/fuse_silicon_1206L.step

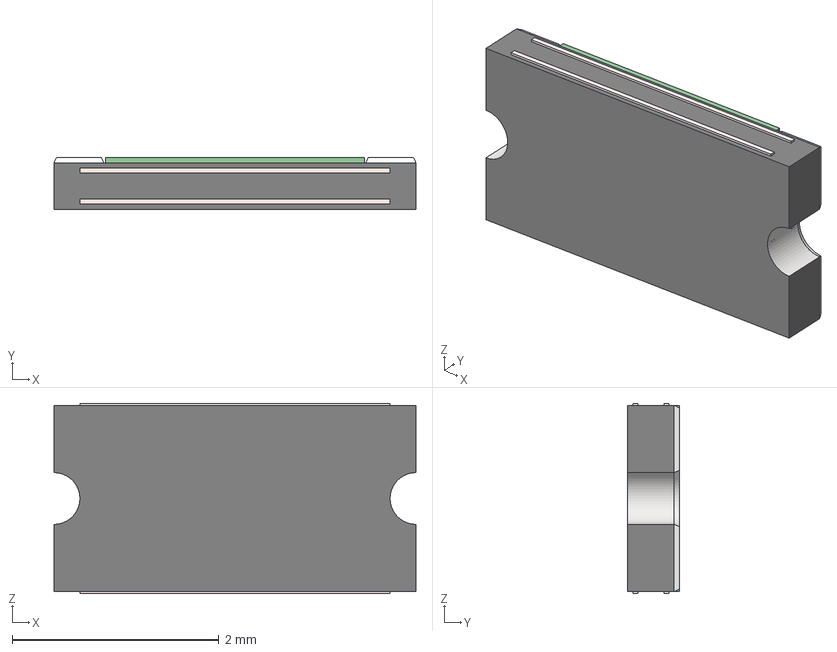
[picture p206: CAD file, 2024-09-17]
3D/Fuses/FuseSMD/Resettable Fuse/1206/fuse_silicon_1206L.step
3.50 x 0.5 x 1.84 mm
