nguyentrungthao/KicadLibrary/3D/Fuses/FuseSMD/Resettable Fuse/1812/smd1812.stp

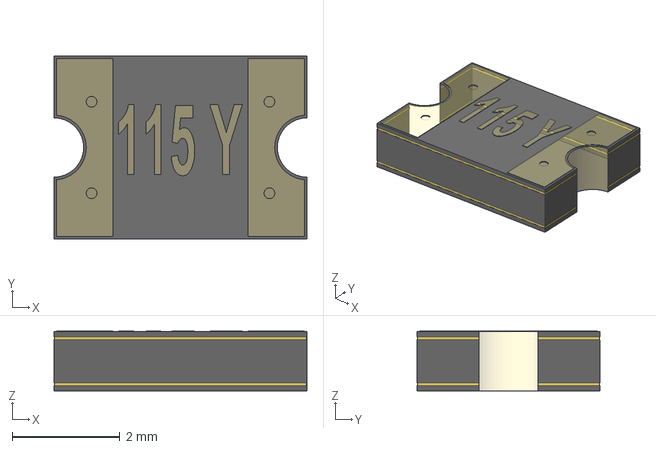
[picture p207: CAD file, 2024-09-17]
3D/Fuses/FuseSMD/Resettable Fuse/1812/smd1812.stp
4.70 x 3.40 x 1.11 mm
