nguyentrungthao/KicadLibrary/3D/Inductor/SMD/CDRH104R/CDRH104R.STEP

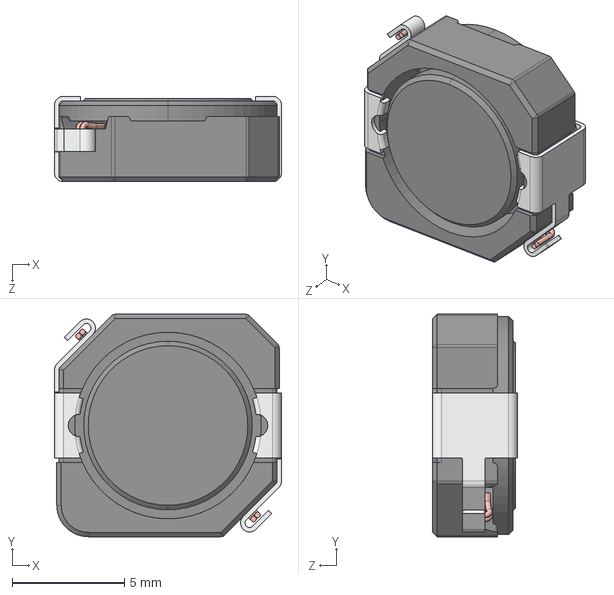
[picture p208: CAD file, 2024-09-17]
3D/Inductor/SMD/CDRH104R/CDRH104R.STEP
10.1 x 9.90 x 3.80 mm
