nguyentrungthao/KicadLibrary/3D/Inductor/SMD/GrayPowerInductor/Inductor_SMD_AMPLF_0620.STEP

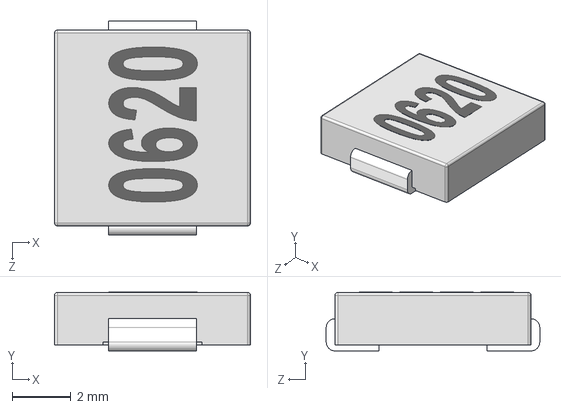
[picture p209: CAD file, 2024-09-17]
3D/Inductor/SMD/GrayPowerInductor/Inductor_SMD_AMPLF_0620.STEP
6.70 x 2.01 x 7.30 mm
