nguyentrungthao/KicadLibrary/3D/Isolation/OPTO/MOC/MOC3020.step

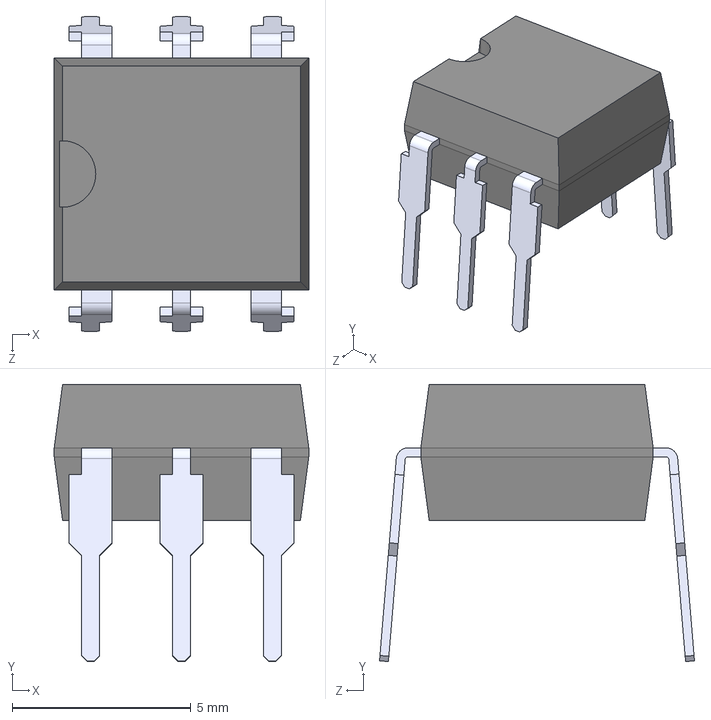
[picture p210: CAD file, 2024-09-17]
3D/Isolation/OPTO/MOC/MOC3020.step
7.12 x 7.75 x 8.81 mm
