nguyentrungthao/KicadLibrary/3D/Isolation/OPTO/pc817/pc817 dip6.step

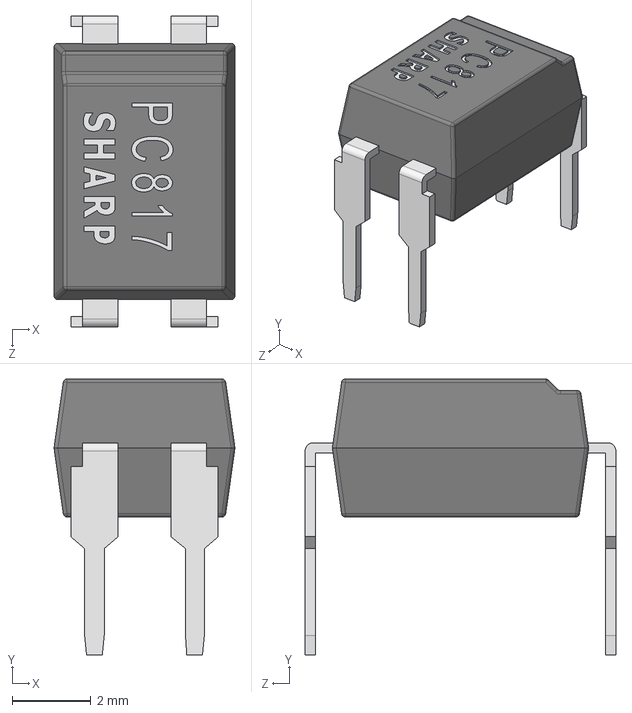
[picture p211: CAD file, 2024-09-17]
3D/Isolation/OPTO/pc817/pc817 dip6.step
4.59 x 7.00 x 7.88 mm
