nguyentrungthao/KicadLibrary/3D/MCU_SoC_Package/Espressif/ESP32-C3-WROOM-02/esp32C3WROOM02H4 v0.step

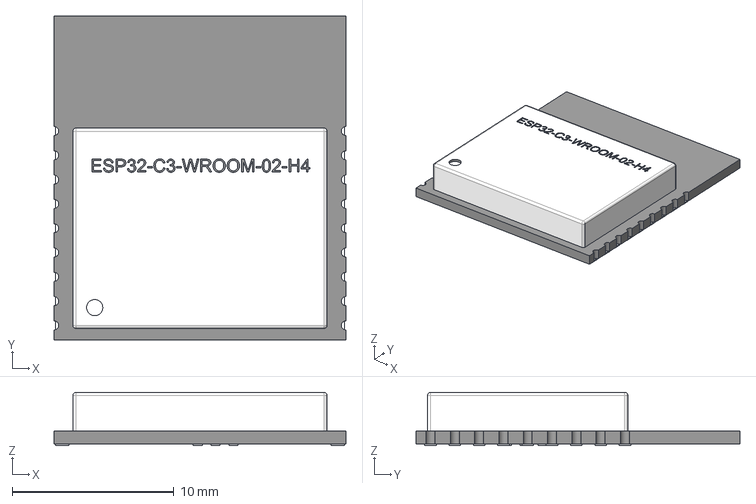
[picture p212: CAD file, 2024-09-17]
3D/MCU_SoC_Package/Espressif/ESP32-C3-WROOM-02/esp32C3WROOM02H4 v0.step
18.0 x 20.0 x 3.30 mm
Pins
