nguyentrungthao/KicadLibrary/3D/MCU_SoC_Package/Fairchild-023N65S3-MOSFET/Fairchild 023N65S3.STEP

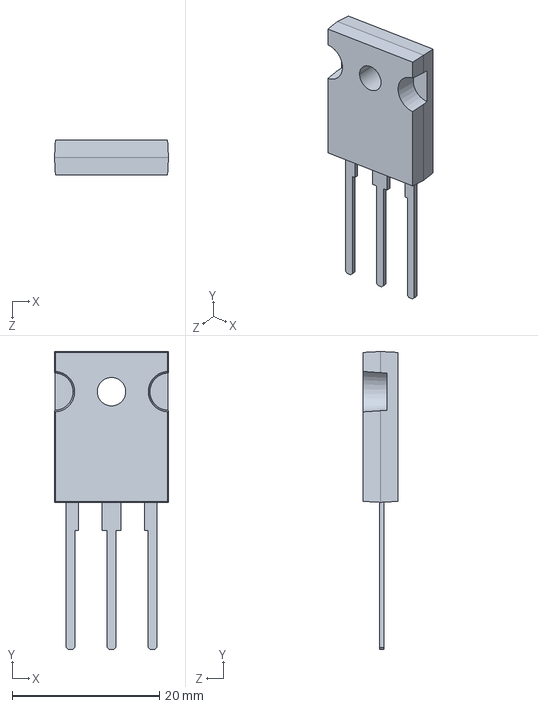
[picture p213: CAD file, 2024-09-17]
3D/MCU_SoC_Package/Fairchild-023N65S3-MOSFET/Fairchild 023N65S3.STEP
15.5 x 40.5 x 4.70 mm
