nguyentrungthao/KicadLibrary/3D/MCU_SoC_Package/GPS/User Library-neo-m8n.STEP

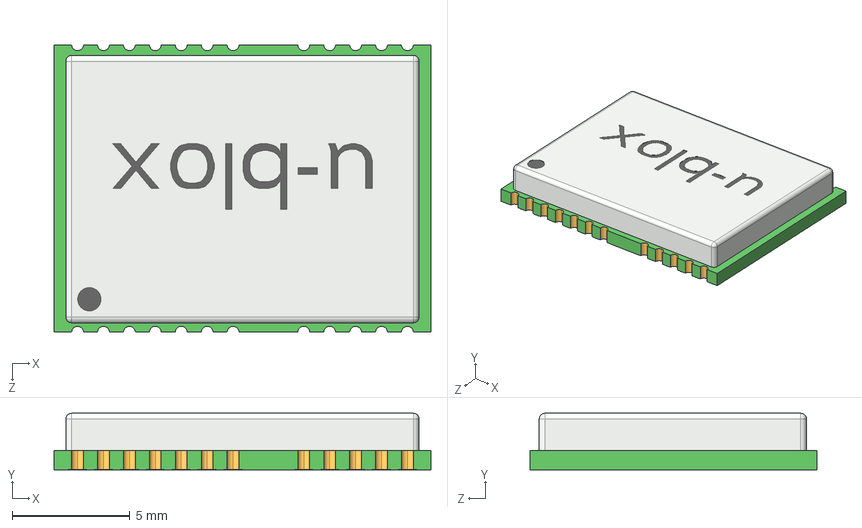
[picture p214: CAD file, 2024-09-17]
3D/MCU_SoC_Package/GPS/User Library-neo-m8n.STEP
16.0 x 2.40 x 12.2 mm
