nguyentrungthao/KicadLibrary/(list of files, cad)

Other CAD files:
3D/Connector/Header_1-27mm_2Row_SMD/1_27mm_Header/1_27mm_single_pin_assembled.SLDASM
3D/Capacitor/Cap_THT/FilmCap/Film Capacitor P10/FILM_BLUE_P1000L1300W600H1200PD80.stp
3D/Connector/RJ11/TJ6P6C/TJ6P6C gray.stp
3D/Connector/RJ11_Connector/TJ6P6C/TJ6P6C gray.stp
3D/Capacitor/Cap_SMD/AluminumCap/100uF 16V.STEP
3D/Capacitor/Cap_SMD/AluminumCap/100uF 25V.STEP
3D/Capacitor/Cap_SMD/AluminumCap/100uF 50V.STEP
3D/Capacitor/Cap_SMD/AluminumCap/220uF 16V.STEP
3D/Capacitor/Cap_SMD/AluminumCap/220uF 25V.STEP
3D/Capacitor/Cap_SMD/AluminumCap/220uF 35V.STEP
3D/Capacitor/Cap_SMD/AluminumCap/220uF 50V.STEP
3D/Capacitor/Cap_SMD/AluminumCap/470uF 16V.STEP
3D/Capacitor/Cap_SMD/AluminumCap/470uF 25V.STEP
3D/Capacitor/Cap_SMD/AluminumCap/470uF 35V.STEP
3D/Capacitor/Cap_SMD/AluminumCap/470uF 50V.STEP
3D/Capacitor/Cap_SMD/AluminumCap/Capacitor_Aluminio_SMD_Edicao.SLDPRT
3D/Capacitor/Cap_SMD/CAP/Film Capacitor P10/FILM_BLUE_P1000L1300W400H900PD80.stp
3D/Capacitor/Cap_SMD/CAP/Film Capacitor P10/FILM_BLUE_P1000L1300W500H1100PD80.stp
3D/Capacitor/Cap_SMD/CAP/Film Capacitor P10/FILM_BLUE_P1000L1300W600H1200PD80.stp
3D/Capacitor/Cap_SMD/CAP/Film Capacitor P10/FILM_GREY_P1000L1300W400H900PD80.stp
3D/Capacitor/Cap_SMD/CAP/Film Capacitor P10/FILM_GREY_P1000L1300W500H1100PD80.stp
3D/Capacitor/Cap_SMD/CAP/Film Capacitor P22.5/FILM_BLUE_P2250L2650W1000H1850PD80.stp
3D/Capacitor/Cap_SMD/CAP/Film Capacitor P22.5/FILM_BLUE_P2250L2650W1050H1650PD80.stp
3D/Capacitor/Cap_SMD/CAP/Film Capacitor P22.5/FILM_BLUE_P2250L2650W1050H1850PD80.stp
3D/Capacitor/Cap_SMD/CAP/Film Capacitor P22.5/FILM_BLUE_P2250L2650W1100H2000PD80.stp
3D/Capacitor/Cap_SMD/CAP/Film Capacitor P22.5/FILM_BLUE_P2250L2650W1100H2100PD80.stp
3D/Capacitor/Cap_SMD/CAP/Film Capacitor P22.5/FILM_BLUE_P2250L2650W1200H2200PD80.stp
3D/Capacitor/Cap_SMD/CAP/Film Capacitor P22.5/FILM_BLUE_P2250L2650W1300H2200PD80.stp
3D/Capacitor/Cap_SMD/CAP/Film Capacitor P22.5/FILM_BLUE_P2250L2650W1450H2950PD80.stp
3D/Capacitor/Cap_SMD/CAP/Film Capacitor P22.5/FILM_BLUE_P2250L2650W600H1500PD80.stp
3D/Capacitor/Cap_SMD/CAP/Film Capacitor P22.5/FILM_BLUE_P2250L2650W700H1600PD80.stp
3D/Capacitor/Cap_SMD/CAP/Film Capacitor P22.5/FILM_BLUE_P2250L2650W850H1700PD80.stp
3D/Capacitor/Cap_SMD/CAP/Film Capacitor P22.5/FILM_GREY_P2250L2650W1000H1850PD80.stp
3D/Capacitor/Cap_SMD/CAP/Film Capacitor P22.5/FILM_GREY_P2250L2650W1050H1650PD80.stp
3D/Capacitor/Cap_SMD/CAP/Film Capacitor P22.5/FILM_GREY_P2250L2650W1050H1850PD80.stp
3D/Capacitor/Cap_SMD/CAP/Film Capacitor P22.5/FILM_GREY_P2250L2650W1100H2100PD80.stp
3D/Capacitor/Cap_SMD/CAP/Film Capacitor P22.5/FILM_GREY_P2250L2650W1200H2200PD80.stp
3D/Capacitor/Cap_SMD/CAP/Film Capacitor P22.5/FILM_GREY_P2250L2650W1300H2200PD80.stp
3D/Capacitor/Cap_SMD/CAP/Film Capacitor P22.5/FILM_GREY_P2250L2650W1450H2950PD80.stp
3D/Capacitor/Cap_SMD/CAP/Film Capacitor P22.5/FILM_GREY_P2250L2650W600H1500PD80.stp
3D/Capacitor/Cap_SMD/CAP/Film Capacitor P22.5/FILM_GREY_P2250L2650W700H1600PD80.stp
3D/Capacitor/Cap_SMD/CAP/Film Capacitor P27.5/FILM_BLUE_P2750L3150W1000H2100PD90.stp
3D/Capacitor/Cap_SMD/CAP/Film Capacitor P27.5/FILM_BLUE_P2750L3150W1250H2150PD90.stp
3D/Capacitor/Cap_SMD/CAP/Film Capacitor P27.5/FILM_BLUE_P2750L3150W1300H2400PD90.stp
3D/Capacitor/Cap_SMD/CAP/Film Capacitor P27.5/FILM_BLUE_P2750L3150W1500H2600PD90.stp
3D/Capacitor/Cap_SMD/CAP/Film Capacitor P27.5/FILM_BLUE_P2750L3150W1800H2750PD90.stp
3D/Capacitor/Cap_SMD/CAP/Film Capacitor P27.5/FILM_BLUE_P2750L3150W2200H3650PD90.stp
3D/Capacitor/Cap_SMD/CAP/Film Capacitor P27.5/FILM_BLUE_P2750L3200W1300H2500PD90.stp
3D/Capacitor/Cap_SMD/CAP/Film Capacitor P27.5/FILM_BLUE_P2750L3200W1400H2800PD90.stp
3D/Capacitor/Cap_SMD/CAP/Film Capacitor P27.5/FILM_BLUE_P2750L3200W1800H3300PD90.stp
3D/Capacitor/Cap_SMD/CAP/Film Capacitor P27.5/FILM_GREY_P2750L3150W1000H2100PD90.stp
3D/Capacitor/Cap_SMD/CAP/Film Capacitor P27.5/FILM_GREY_P2750L3150W1250H2150PD90.stp
3D/Capacitor/Cap_SMD/CAP/Film Capacitor P27.5/FILM_GREY_P2750L3150W1300H2400PD90.stp
3D/Capacitor/Cap_SMD/CAP/Film Capacitor P27.5/FILM_GREY_P2750L3150W1500H2600PD90.stp
3D/Capacitor/Cap_SMD/CAP/Film Capacitor P27.5/FILM_GREY_P2750L3150W1800H2750PD90.stp
3D/Capacitor/Cap_SMD/CAP/Film Capacitor P27.5/FILM_GREY_P2750L3150W2200H3650PD90.stp
3D/Capacitor/Cap_SMD/CAP/Film Capacitor P27.5/FILM_GREY_P2750L3200W1300H2500PD90.stp
3D/Capacitor/Cap_SMD/CAP/Film Capacitor P27.5/FILM_GREY_P2750L3200W1400H2800PD90.stp
3D/Capacitor/Cap_SMD/CAP/Film Capacitor P27.5/FILM_GREY_P2750L3200W1500H2600PD90.stp
3D/Capacitor/Cap_SMD/CAP/Film Capacitor P27.5/FILM_GREY_P2750L3200W1800H3300PD90.stp
3D/Capacitor/Cap_SMD/CAP/Film Capacitor P27.5/FILM_GREY_P2750L3200W2200H3700PD90.stp
3D/Capacitor/Cap_SMD/CAP/Film Capacitor P37.5/FILM_BLUE_P3750L4100W2100H3800PD100.stp
3D/Capacitor/Cap_SMD/CAP/Film Capacitor P37.5/FILM_BLUE_P3750L4150W1300H2400PD100.stp
3D/Capacitor/Cap_SMD/CAP/Film Capacitor P37.5/FILM_BLUE_P3750L4150W2000H4000PD100.stp
3D/Capacitor/Cap_SMD/CAP/Film Capacitor P37.5/FILM_BLUE_P3750L4150W2400H1900PD100.stp
3D/Capacitor/Cap_SMD/CAP/Film Capacitor P37.5/FILM_GREY_P3750L4100W2100H3800PD100.stp
3D/Capacitor/Cap_SMD/CAP/Film Capacitor P37.5/FILM_GREY_P3750L4150W1300H2400PD100.stp
3D/Capacitor/Cap_SMD/CAP/csmd-0201_l0-6_w0-3_h0-3.stp
3D/Capacitor/Cap_SMD/CAP/csmd-0201_l0-6_w0-3_h0-33.stp
3D/Capacitor/Cap_SMD/CAP/csmd-0402_l1_w0-5_h0-5.stp
3D/Capacitor/Cap_SMD/CAP/csmd-0402_l1_w0-5_h0-56.stp
3D/Capacitor/Cap_SMD/CAP/csmd-0603_l1-6_w0-81_h0-86.stp
3D/Capacitor/Cap_SMD/CAP/csmd-0603_l1-6_w0-8_h0-8.stp
3D/Capacitor/Cap_SMD/CAP/csmd-0805_l2_w1-25_h1-25.stp
3D/Capacitor/Cap_SMD/CAP/csmd-1206_l3-2_w1-6_h1-15.stp
3D/Capacitor/Cap_SMD/CAP/csmd-1206_l3-2_w1-6_h1-27.stp
3D/Capacitor/Cap_SMD/CAP/csmd-1206_l3-2_w1-6_h1-52.stp
3D/Capacitor/Cap_SMD/CAP/csmd-1206_l3-2_w1-6_h1-6.stp
3D/Capacitor/Cap_SMD/CAP/csmd-1206_l3-2_w1-6_h1-78.stp
3D/Capacitor/Cap_SMD/CAP/csmd-1210_l3-2_w2-5_h0-94.stp
3D/Capacitor/Cap_SMD/CAP/csmd-1210_l3-2_w2-5_h1-27.stp
3D/Capacitor/Cap_SMD/CAP/csmd-1210_l3-2_w2-5_h1-35.stp
3D/Capacitor/Cap_SMD/CAP/csmd-1210_l3-2_w2-5_h1-4.stp
3D/Capacitor/Cap_SMD/CAP/csmd-1210_l3-2_w2-5_h1-78.stp
3D/Capacitor/Cap_SMD/CAP/csmd-1210_l3-2_w2-5_h1-8.stp
3D/Capacitor/Cap_SMD/CAP/csmd-1210_l3-2_w2-5_h2-5.stp
3D/Capacitor/Cap_SMD/CAP/csmd-1210_l3-2_w2-5_h2.stp
3D/Capacitor/Cap_SMD/CAP/csmd-1808_l4-5_w2_h0-94.stp
3D/Capacitor/Cap_SMD/CAP/csmd-1808_l4-5_w2_h1-27.stp
3D/Capacitor/Cap_SMD/CAP/csmd-1808_l4-5_w2_h1-4.stp
3D/Capacitor/Cap_SMD/CAP/csmd-1812_l4-5_w3-2_h1-02.stp
3D/Capacitor/Cap_SMD/CAP/csmd-1812_l4-5_w3-2_h1-27.stp
3D/Capacitor/Cap_SMD/CAP/csmd-1812_l4-5_w3-2_h1-52.stp
3D/Capacitor/Cap_SMD/CAP/csmd-1812_l4-5_w3-2_h1-78.stp
3D/Capacitor/Cap_SMD/CAP/csmd-1812_l4-5_w3-2_h2-29.stp
3D/Capacitor/Cap_SMD/CAP/csmd-1812_l4-5_w3-2_h2-54.stp
3D/Capacitor/Cap_SMD/CAP/csmd-1825_l4-5_w6-4_h1-27.stp
3D/Capacitor/Cap_SMD/CAP/csmd-1825_l4-5_w6-4_h1-52.stp
3D/Capacitor/Cap_SMD/CAP/csmd-2220_l5-72_w5_h1-27.stp
3D/Capacitor/Cap_SMD/CAP/csmd-2220_l5-72_w5_h1-52.stp
3D/Capacitor/Cap_SMD/CAP/csmd-2220_l5-72_w5_h1-78.stp
3D/Capacitor/Cap_SMD/CAP/csmd-2220_l5-72_w5_h2-54.stp
3D/Capacitor/Cap_SMD/CAP/csmd-2220_l5-72_w5_h2-79.stp
3D/Capacitor/Cap_SMD/CAP/csmd-2225_l5-72_w6-35_h1-27.stp
3D/Capacitor/Cap_SMD/CAP/csmd-2225_l5-72_w6-35_h1-52.stp
3D/Capacitor/Cap_SMD/CAP/csmd-2225_l5-72_w6-35_h1-78.stp
3D/Capacitor/Cap_SMD/CAP/csmd-2225_l5-72_w6-35_h2-54.stp
3D/Capacitor/Cap_THT/Film Capacitor P15/FILM_BLUE_P1500L1800W1000H1600PD80.stp
3D/Capacitor/Cap_THT/Film Capacitor P15/FILM_BLUE_P1500L1800W1100H1850PD80.stp
3D/Capacitor/Cap_THT/Film Capacitor P15/FILM_BLUE_P1500L1800W1100H1900PD80.stp
3D/Capacitor/Cap_THT/Film Capacitor P15/FILM_BLUE_P1500L1800W500H1050PD80.stp
3D/Capacitor/Cap_THT/Film Capacitor P15/FILM_BLUE_P1500L1800W500H1100PD80.stp
3D/Capacitor/Cap_THT/Film Capacitor P15/FILM_BLUE_P1500L1800W600H1200PD80.stp
3D/Capacitor/Cap_THT/Film Capacitor P15/FILM_BLUE_P1500L1800W750H1350PD80.stp
3D/Capacitor/Cap_THT/Film Capacitor P15/FILM_BLUE_P1500L1800W850H1450PD80.stp
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
