nguyentrungthao/KicadLibrary/3D/Connector/HT-3.96/boardmanhinh/boardmanhinh.pdf

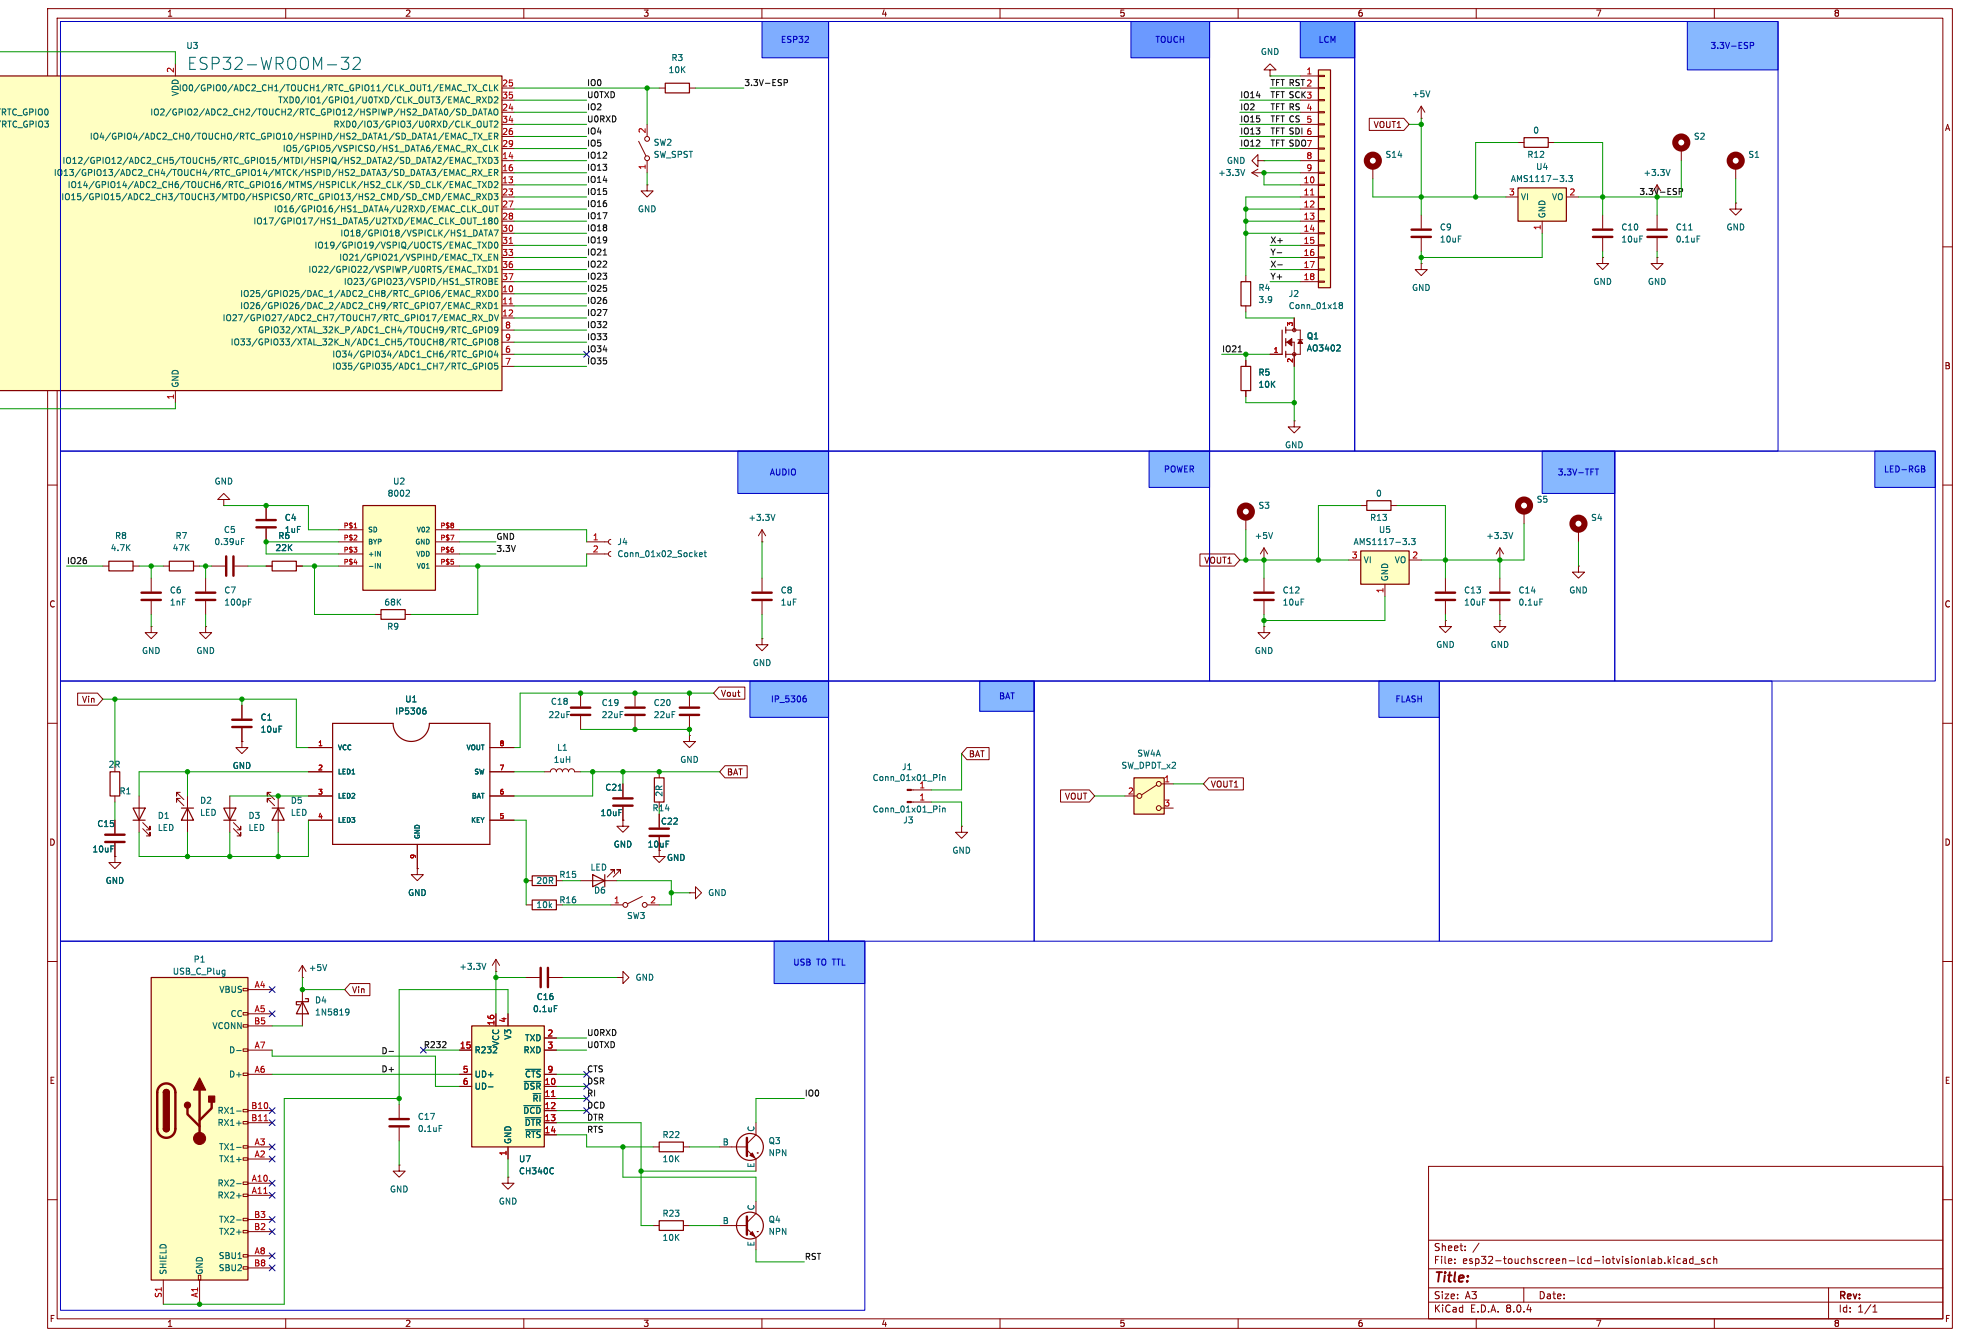
[picture p215: page 1]

1 ~{DSR} 10 ~{RI} 11 ~{DCD} 12 ~{DTR} 13 ~{RTS} 14 R232 15 VCC 16 TXD 2 RXD 3 V3

4 UD+ 5 UD- 6 ~{CTS}9 U7 CH340C GND

Id: 1/1 Title: File: esp32-touchscreen-lcd-iotvisionlab.kicad_sch Sheet: /
