nguyentrungthao/KicadLibrary/3D/Connector/HT-3.96/boardmanhinh/boardmanhinh.kicad_pcb

## KiCad design 3D/Connector/HT-3.96/boardmanhinh/boardmanhinh.kicad_pcb (2024-09-17)

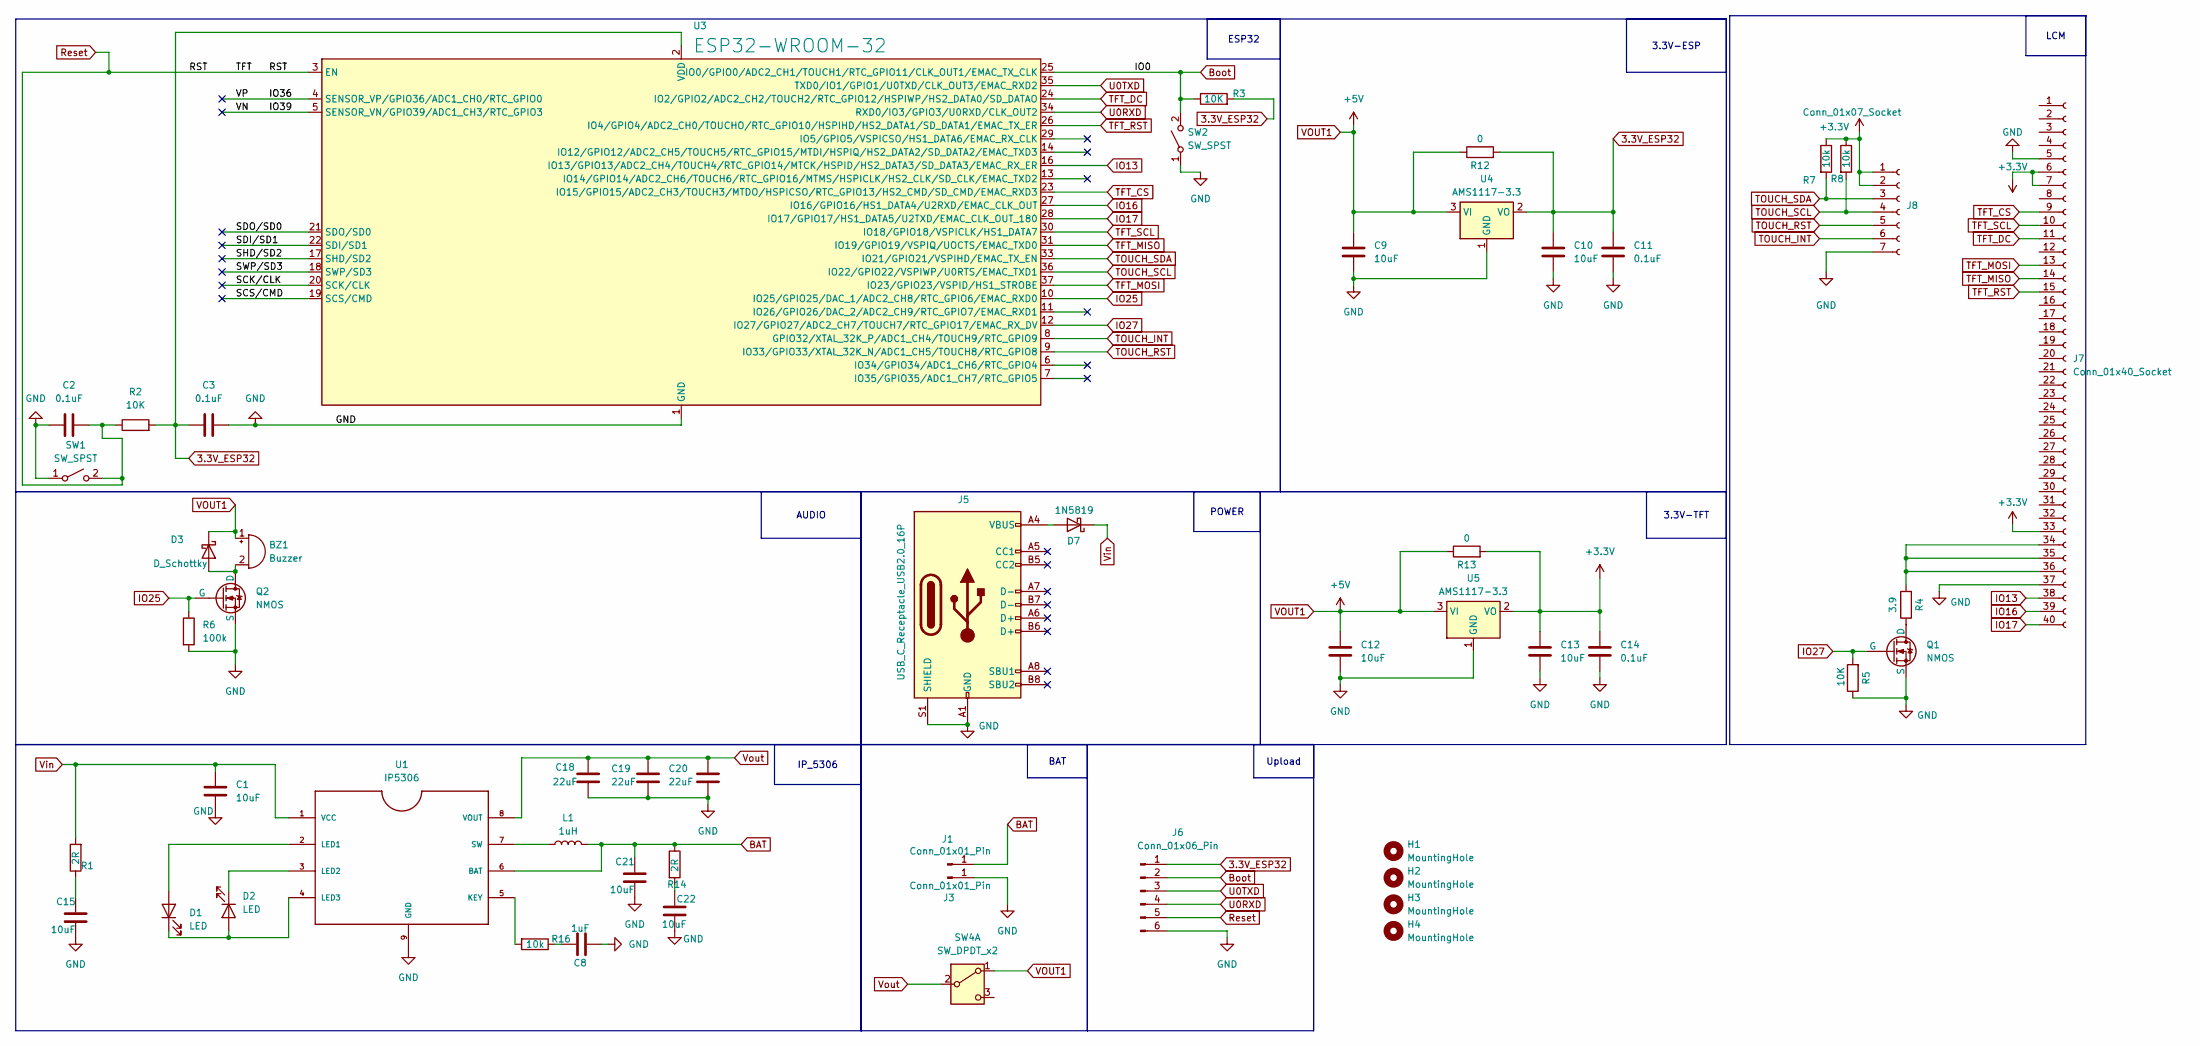
[picture p216: schematic boardmanhinh.kicad_sch]

Parts:
BZ1: Buzzer; 9056-TS DIP Buzzer
C1, C9, C10, C12, C13, C15, C21, C22: 10uF; C_0603_1608Metric
C2, C3, C11, C14: 0.1uF; C_0603_1608Metric
C8: 1uF; C_0603_1608Metric
C18, C19, C20: 22uF; C_0805_2012Metric
D1, D2: LED; LED_0603_1608Metric
D3: D_Schottky; D_SMA
D7: 1N5819; D_0603_1608Metric
H1, H2, H3, H4: MountingHole; MountingHole_2.2mm_M2_ISO7380_Pad
J1, J3: Conn_01x01_Pin; TestPoint_Keystone_5019_Minature
J5: USB_C_Receptacle_USB2.0_16P; USB_C_Receptacle_GCT_USB4105-xx-A_16P_TopMnt_Horizontal
J6: Conn_01x06_Pin; PinHeader_1x06_P2.54mm_Vertical
J7: Conn_01x40_Socket; TE_4-1734839-0_1x40-1MP_P0.5mm_Horizontal
J8: Conn_01x07_Socket; TE_0-1734839-7_1x07-1MP_P0.5mm_Horizontal
L1: 1uH; L_Cenker_CKCS4020
Q1, Q2: NMOS; SOT-23
R1, R14: 2R; R_0603_1608Metric
R2, R3, R5: 10K; R_0603_1608Metric
R4: 3.9; R_0603_1608Metric
R6: 100k; R_0603_1608Metric
R7, R8, R16: 10k; R_0603_1608Metric
R12, R13: 0; R_0603_1608Metric
SW1, SW2: SW_SPST; SW_SPST_PTS810
SW4: SW_DPDT_x2; SW_Slide-03_Wuerth-WS-SLTV_10x2.5x6.4_P2.54mm
U1: IP5306; SOIC9P127_490X600X170L84X42T330X241N
U3: ESP32-WROOM-32; ESP32-WROOM-32E
U4, U5: AMS1117-3.3; SOT-223-3_TabPin2

Connections:
3.3V_ESP32: C3.1, C10.2, C11.2, J6.1, R2.2, R3.2, R12.2, U3.2 (VDD), U4.2 (VO)
+3.3V: C13.2, C14.2, J7.6, J7.7, J7.33, J8.1, J8.2, R7.1, R8.1, R13.2, U5.2 (VO)
/IO36: U3.4 (SENSOR_VP/GPIO36/ADC1_CH0/RTC_GPIO0)
/IO39: U3.5 (SENSOR_VN/GPIO39/ADC1_CH3/RTC_GPIO3)
/SCK/CLK: U3.20 (SCK/CLK)
/SCS/CMD: U3.19 (SCS/CMD)
/SDI/SD1: U3.22 (SDI/SD1)
/SDO/SD0: U3.21 (SDO/SD0)
/SHD/SD2: U3.17 (SHD/SD2)
/SWP/SD3: U3.18 (SWP/SD3)
BAT: C21.1, J1.1, L1.2, R14.1, U1.6 (BAT); also elsewhere on the board
Boot: J6.2, R3.1, SW2.2 (B), U3.25 (IO0/GPIO0/ADC2_CH1/TOUCH1/RTC_GPIO11/CL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); also elsewhere on the board
GND: C1.2, C2.1, C3.2, C8.1, C9.1, C10.1, C11.1, C12.1, C13.1, C14.1, C15.2, C18.2, C19.2, C20.2, C21.2, C22.2, J3.1, J5.A1 (GND), J5.A12 (GND), J5.B1 (GND), J5.B12 (GND), J5.S1 (SHIELD), J6.6, J7.5, J7.37, J8.7, Q1.2 (S), Q2.2 (S), R5.1, R6.2, SW1.1 (A), SW2.1 (A), U1.9 (GND), U3.1 (GND), U3.15 (GND), U3.38 (GND), U3.39 (GND), U4.1 (GND), U5.1 (GND); also elsewhere on the board
IO13: J7.38, U3.16 (IO13/GPIO13/ADC2_CH4/TOUCH4/RTC_GPIO14/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)
IO16: J7.39, U3.27 (IO16/GPIO16/HS1_DATA4/U2RXD/EMAC_CLK_OUT)
IO17: J7.40, U3.28 (IO17/GPIO17/HS1_DATA5/U2TXD/EMAC_CLK_OU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)
IO25: Q2.1 (G), R6.1, U3.10 (IO25/GPIO25/DAC_1/ADC2_CH8/RTC_GPIO6/EM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)
IO27: Q1.1 (G), R5.2, U3.12 (IO27/GPIO27/ADC2_CH7/TOUCH7/RTC_GPIO17/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)
unnamed: BZ1.2 (-), D3.2 (A), Q2.3 (D)
unnamed: C8.2, R16.1
unnamed: C15.1, R1.1
unnamed: C22.1, R14.2
unnamed: D1.2 (A), U1.2 (LED1)
unnamed: D1.1 (K), D2.2 (A), U1.4 (LED3)
unnamed: D2.1 (K), U1.3 (LED2)
unnamed: D7.2 (A), J5.A4 (VBUS), J5.A9 (VBUS), J5.B4 (VBUS), J5.B9 (VBUS)
unnamed: J7.34, J7.35, J7.36, R4.2
unnamed: Q1.3 (D), R4.1
unnamed: R16.2, U1.5 (KEY)
unnamed: L1.1, U1.7 (SW)
Reset: C2.2, J6.5, R2.1, SW1.2 (B), U3.3 (EN); also elsewhere on the board
TFT_CS: J7.9, U3.23 (IO15/GPIO15/ADC2_CH3/TOUCH3/MTDO/HSPICS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)
TFT_DC: J7.11, U3.24 (IO2/GPIO2/ADC2_CH2/TOUCH2/RTC_GPIO12/HS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)
TFT_MISO: J7.14, U3.31 (IO19/GPIO19/VSPIQ/UOCTS/EMAC_TXD0)
TFT_MOSI: J7.13, U3.37 (IO23/GPIO23/VSPID/HS1_STROBE)
TFT_RST: J7.15, U3.26 (IO4/GPIO4/ADC2_CH0/TOUCHO/RTC_GPIO10/HS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)
TFT_SCL: J7.10, U3.30 (IO18/GPIO18/VSPICLK/HS1_DATA7)
TOUCH_INT: J8.6, U3.8 (GPIO32/XTAL_32K_P/ADC1_CH4/TOUCH9/RTC_G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)
TOUCH_RST: J8.5, U3.9 (IO33/GPIO33/XTAL_32K_N/ADC1_CH5/TOUCH8/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)
TOUCH_SCL: J8.4, R8.2, U3.36 (IO22/GPIO22/VSPIWP/U0RTS/EMAC_TXD1)
TOUCH_SDA: J8.3, R7.2, U3.33 (IO21/GPIO21/VSPIHD/EMAC_TX_EN)
U0RXD: J6.4, U3.34 (RXD0/IO3/GPIO3/U0RXD/CLK_OUT2)
U0TXD: J6.3, U3.35 (TXD0/IO1/GPIO1/U0TXD/CLK_OUT3/EMAC_RXD2)
VOUT1: BZ1.1 (+), C9.2, C12.2, D3.1 (K), R12.1, R13.1, SW4.1 (A), U4.3 (VI), U5.3 (VI)
Vin: C1.1, D7.1 (K), R1.2, U1.1 (VCC)
Vout: C18.1, C19.1, C20.1, SW4.2 (B), U1.8 (VOUT)

Notes on the sheet:
Upload
3.3V-TFT
ESP32
LCM
AUDIO
3.3V-ESP
IP_5306
POWER
BAT

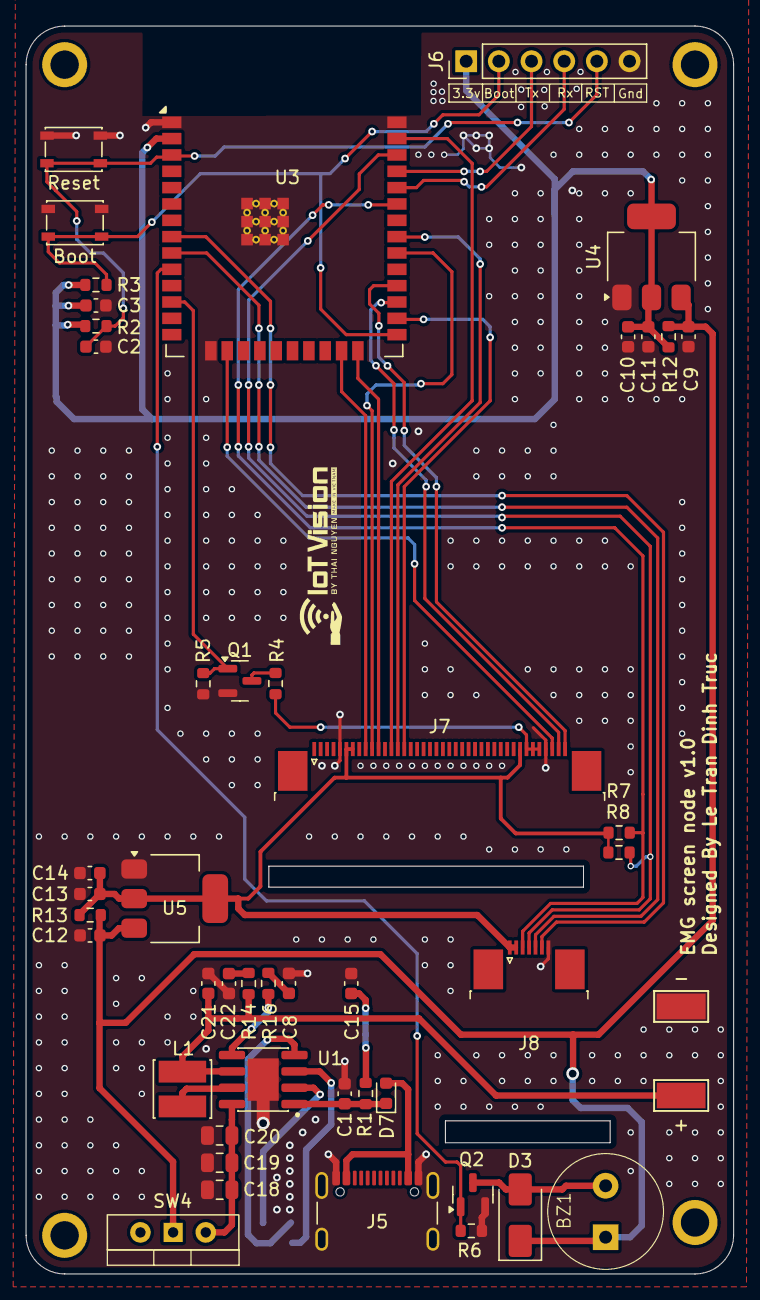
[picture p217: board boardmanhinh.kicad_pcb from above]

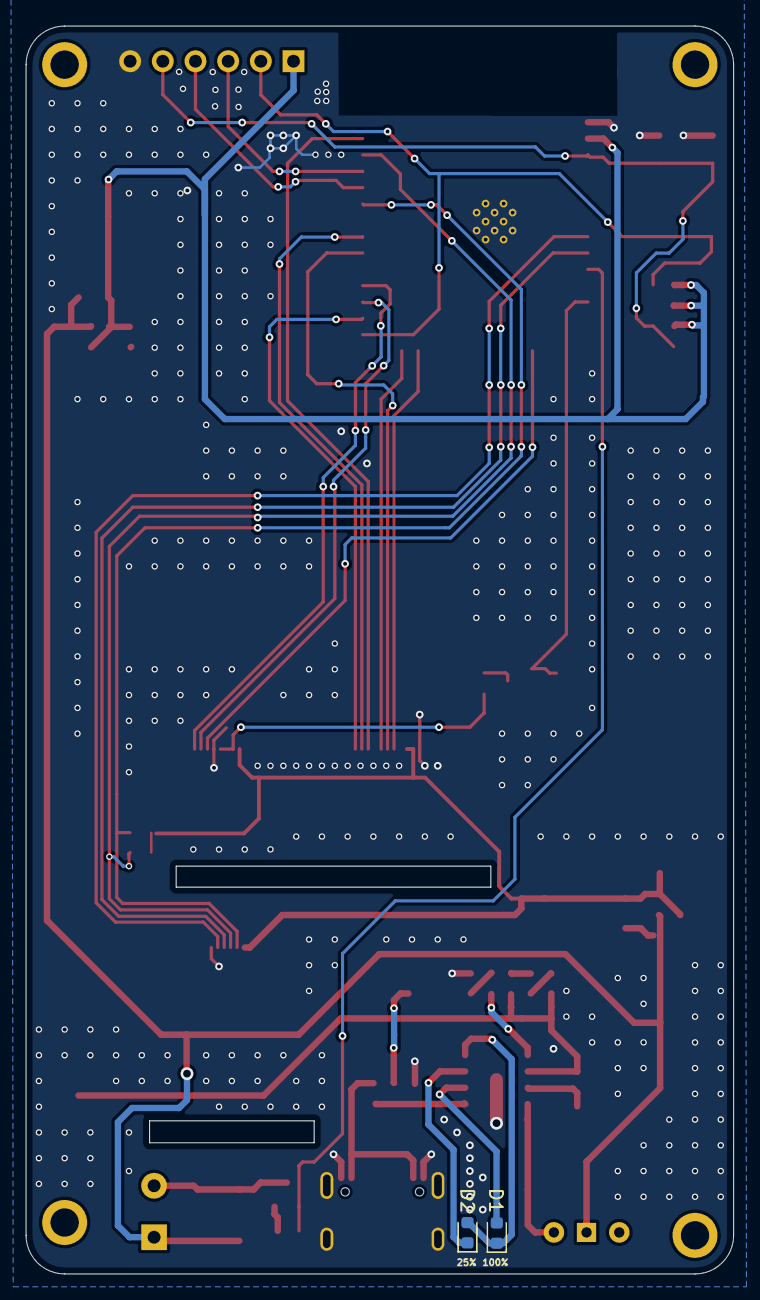
[picture p218: board boardmanhinh.kicad_pcb from below]

Board: 2 copper layers, 55.0 x 97.0 mm, 53 parts (2 on the bottom side), 38 nets.

Other parts of the board:
+: Conn_01x01_Pin; TestPoint_Keystone_5019_Minature
-: Conn_01x01_Pin; TestPoint_Keystone_5019_Minature
Boot: SW_SPST; SW_SPST_PTS810
Reset: SW_SPST; SW_SPST_PTS810

Their connections:
BAT: +.1; also elsewhere on the board
Boot: Boot.2 (B); also elsewhere on the board
GND: -.1, Boot.1 (A), Reset.1 (A); also elsewhere on the board
Reset: Reset.2 (B); also elsewhere on the board
